TiamDesigns/Dachshund60F/hardware/case/renders/02-right-end.png

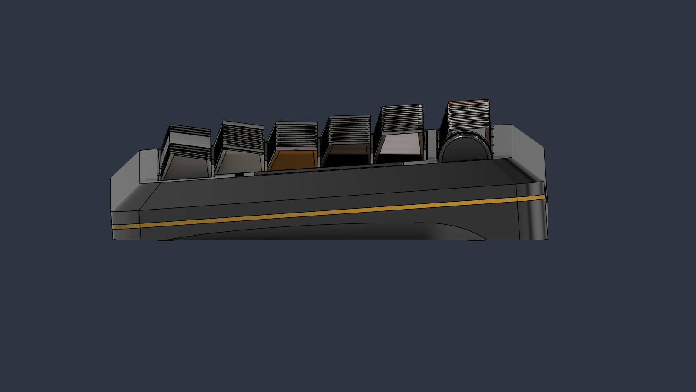
hardware/case/renders/02-right-end.png
