TiamDesigns/Dachshund60F/hardware/case/renders/03-bottom.png

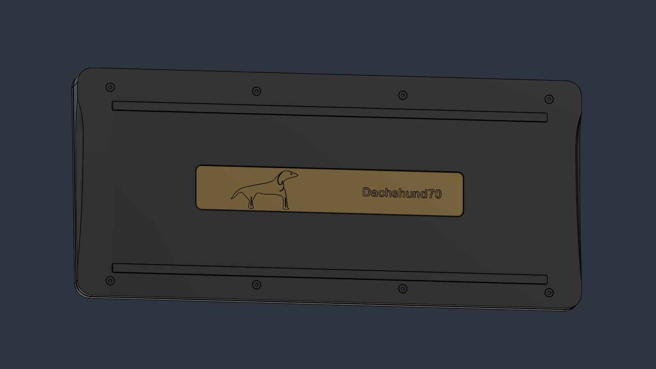
hardware/case/renders/03-bottom.png
