TiamDesigns/Dachshund60F/hardware/case/renders/04-back-face.png

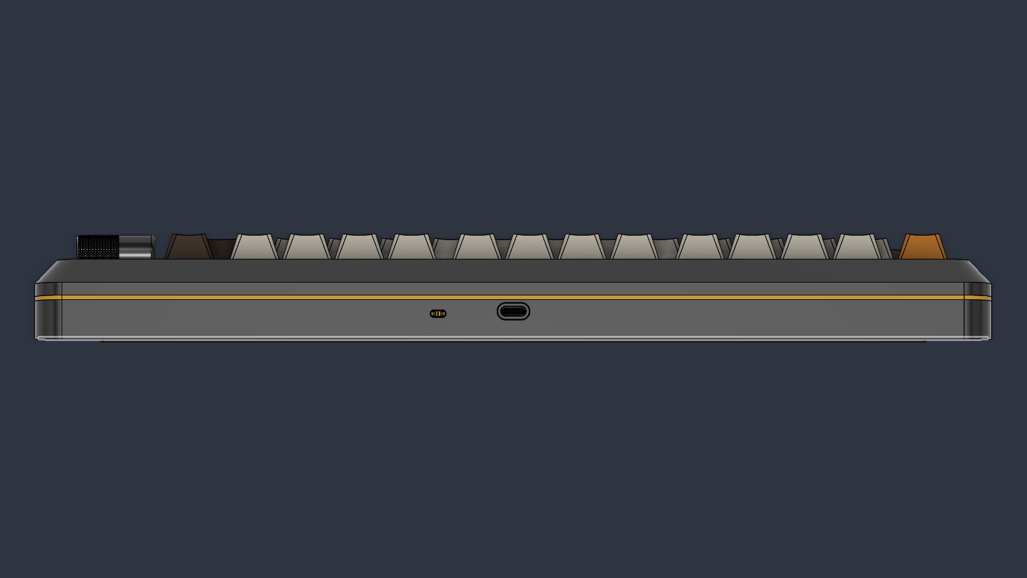
hardware/case/renders/04-back-face.png
