TiamDesigns/Dachshund60F/hardware/case/renders/05-weight-close-up.png

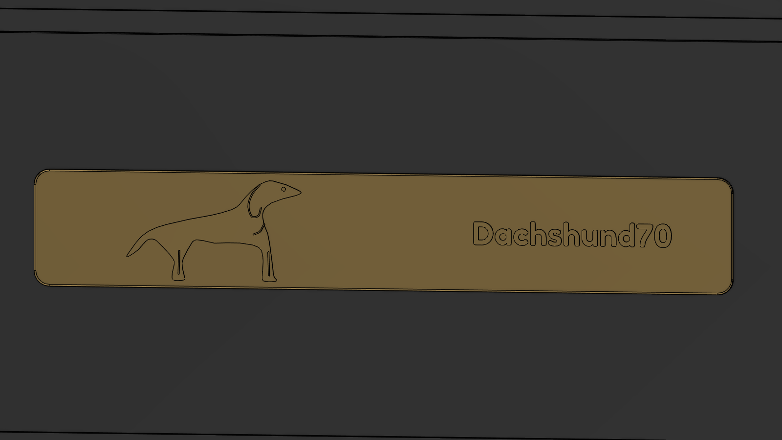
hardware/case/renders/05-weight-close-up.png
