TiamDesigns/Dachshund60F/hardware/3dmodels/Bourns_PEC12R-2x30F-S_standin.step

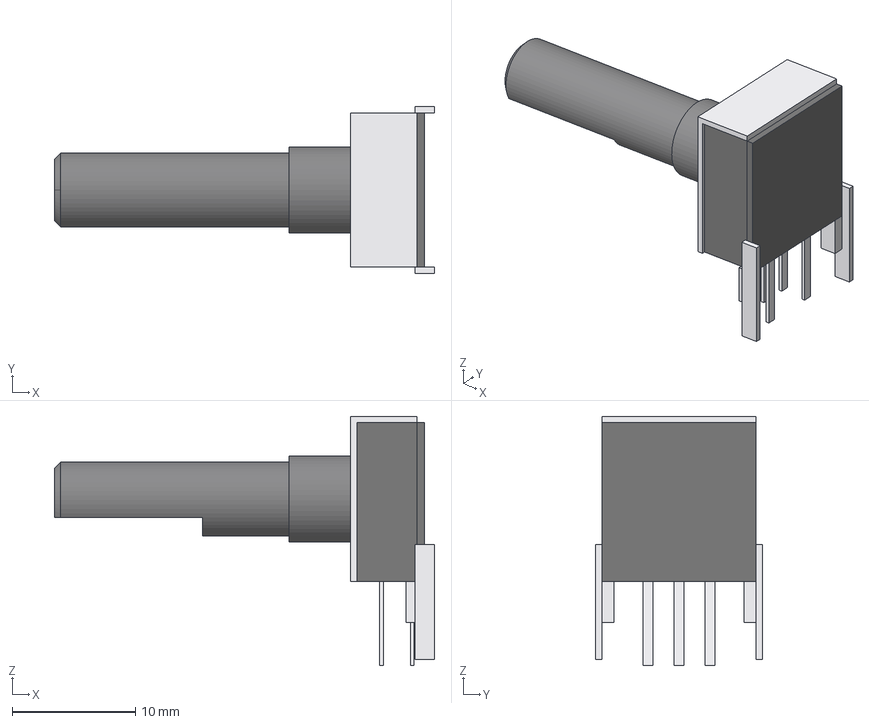
[picture p8: CAD file, 2026-10-28]
hardware/3dmodels/Bourns_PEC12R-2x30F-S_standin.step
30.8 x 13.5 x 20.2 mm
