TiamDesigns/Dachshund60F/hardware/case/dxf/Dachshund70-Weight-Engraving.dxf

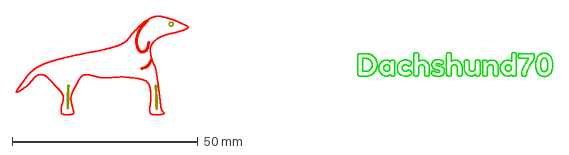
[picture p9: CAD file, 2026-11-04]
hardware/case/dxf/Dachshund70-Weight-Engraving.dxf
144.3 x 26.5 mm
