TiamDesigns/Dachshund60F/hardware/case/step/Dachshund70-Case-Weight.step

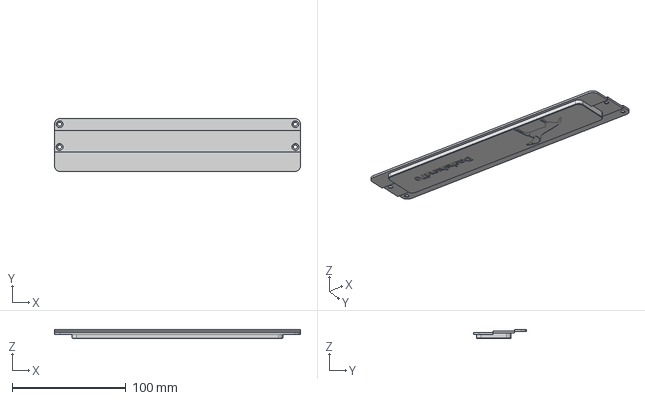
[picture p10: CAD file, 2026-11-04]
hardware/case/step/Dachshund70-Case-Weight.step
216.0 x 46.5 x 7.74 mm
