TiamDesigns/Dachshund60F/hardware/Dachshund70-Plate/Dachshund70-Plate-outline.dxf

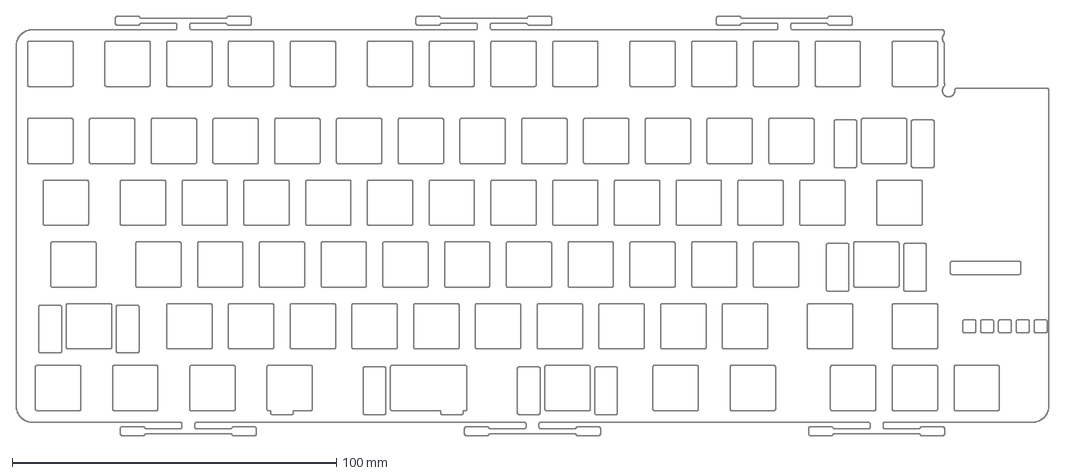
[picture p11: CAD file, 2026-11-03]
hardware/Dachshund70-Plate/Dachshund70-Plate-outline.dxf
318.5 x 129.4 mm
