TiamDesigns/Dachshund60F/hardware/3dmodels/Bourns_PEC12R-2x20F-S_standin.step

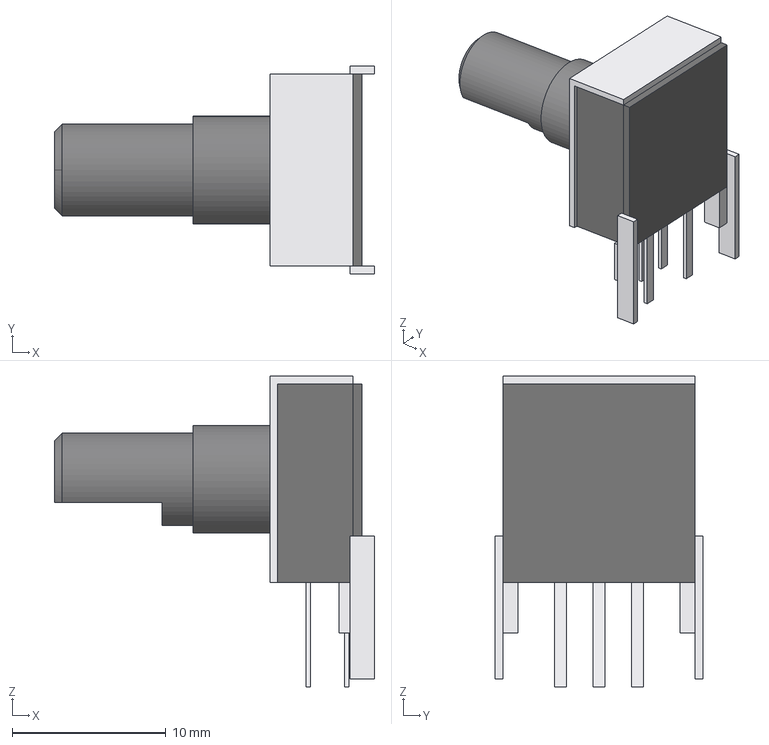
[picture p12: CAD file, 2026-10-28]
hardware/3dmodels/Bourns_PEC12R-2x20F-S_standin.step
20.8 x 13.5 x 20.2 mm
