TiamDesigns/Dachshund60F/hardware/step/Dachshund70-Plate.step

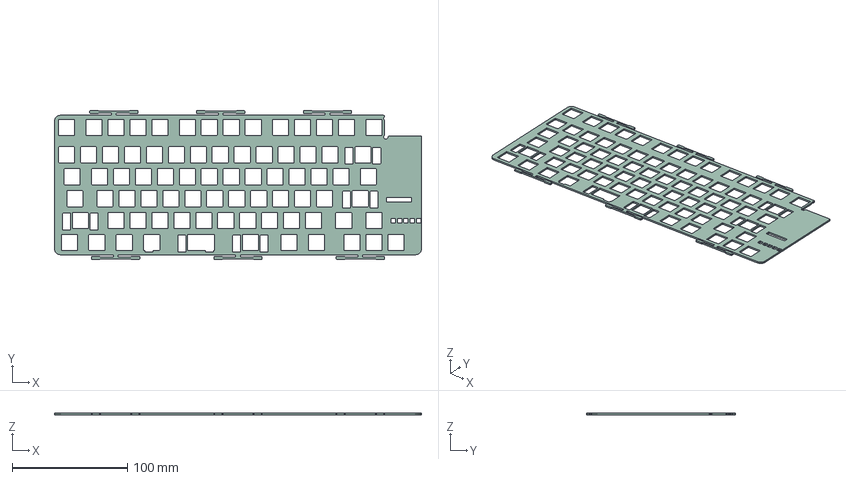
[picture p13: CAD file, 2026-11-03]
hardware/step/Dachshund70-Plate.step
318.5 x 129.4 x 1.51 mm
