TiamDesigns/Dachshund60F/hardware/3dmodels/USB_C_Receptacle_HRO_TYPE-C-31-M-12.step

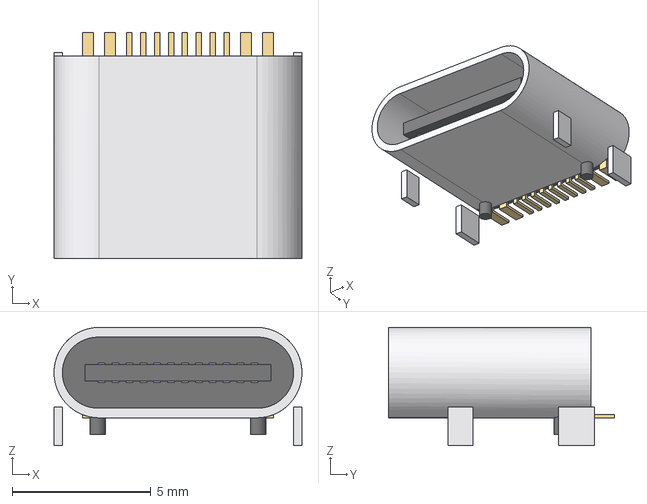
[picture p14: CAD file, 2026-10-23]
hardware/3dmodels/USB_C_Receptacle_HRO_TYPE-C-31-M-12.step
8.94 x 8.15 x 4.26 mm
