TiamDesigns/Dachshund60F/hardware/case/step/Dachshund70-Case-Top.step

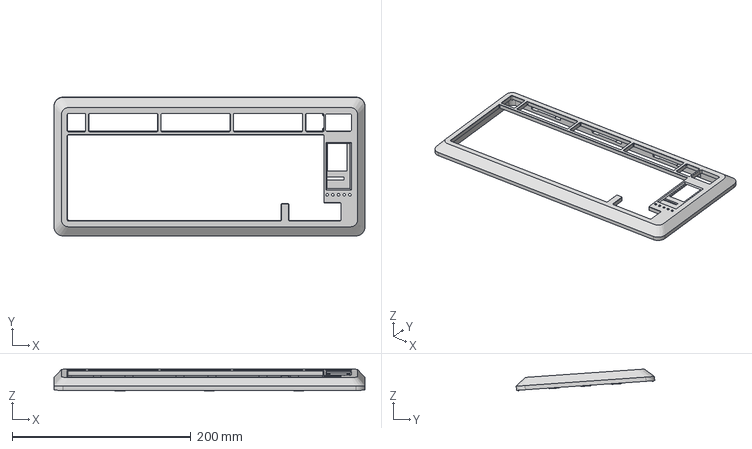
[picture p15: CAD file, 2026-11-03]
hardware/case/step/Dachshund70-Case-Top.step
347.9 x 155.2 x 24.5 mm
