TiamDesigns/Dachshund60F/hardware/3dmodels/JST_PH_S2B-PH-SM4-TB_standin.step

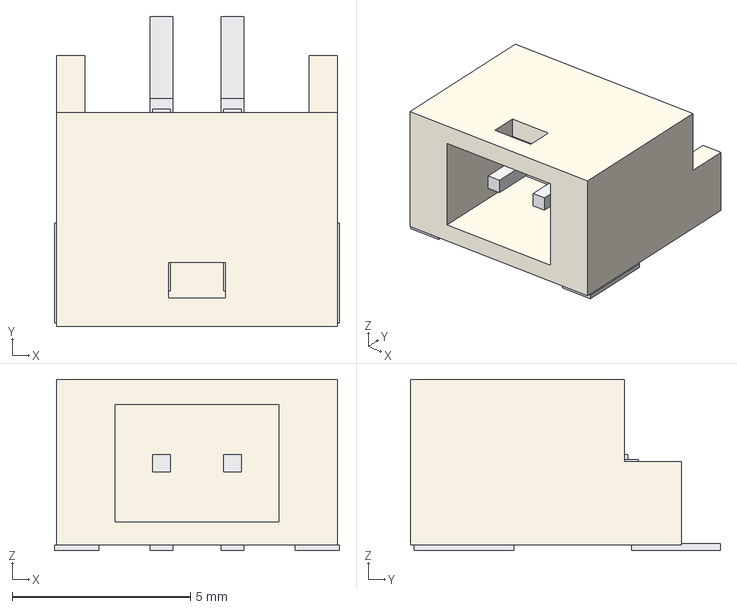
[picture p17: CAD file, 2026-10-23]
hardware/3dmodels/JST_PH_S2B-PH-SM4-TB_standin.step
8.00 x 8.70 x 4.80 mm
