TiamDesigns/Dachshund60F/hardware/case/step/Dachshund70-Case-Encoder-Cover.step

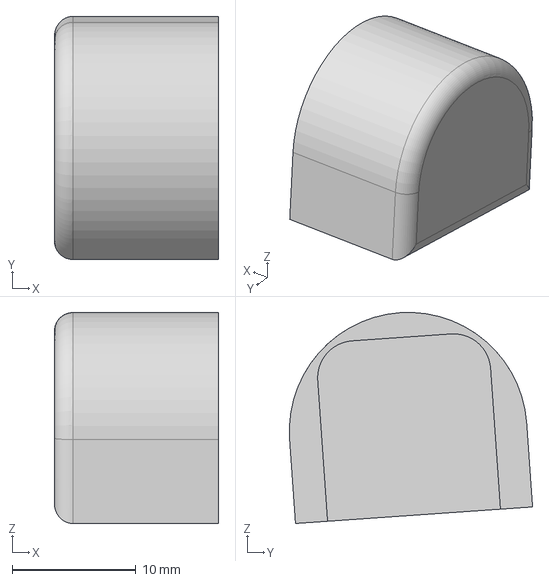
[picture p18: CAD file, 2026-11-03]
hardware/case/step/Dachshund70-Case-Encoder-Cover.step
13.3 x 19.6 x 17.0 mm
