TiamDesigns/Dachshund60F/hardware/case/step/Dachshund70-Case-LED-Guide.step

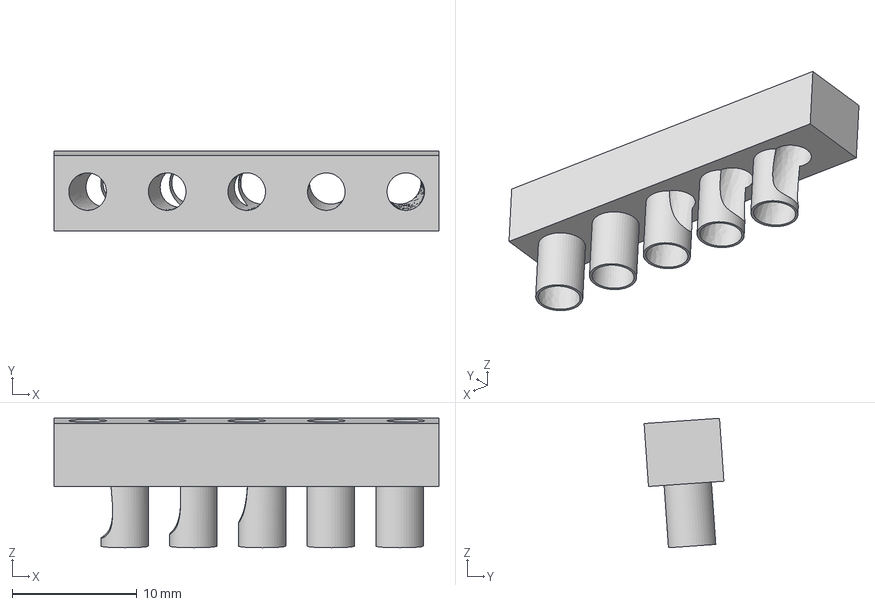
[picture p20: CAD file, 2026-11-03]
hardware/case/step/Dachshund70-Case-LED-Guide.step
30.8 x 6.39 x 10.4 mm
