TiamDesigns/Dachshund60F/hardware/step/Dachshund70-Encoder.step

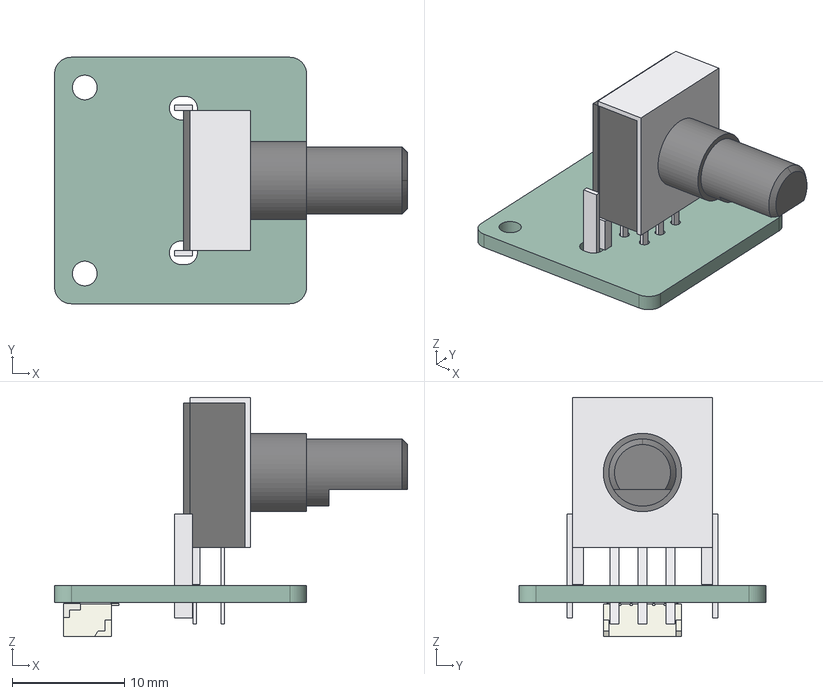
[picture p21: CAD file, 2026-11-03]
hardware/step/Dachshund70-Encoder.step
31.5 x 22.0 x 21.3 mm
Bourns PEC12R-2x20F-S
JST_SH_SM05B-SRSS-TB_1x05-1MP_P1.00mm_Horizontal
Dachshund70-Encoder_PCB
