TiamDesigns/Dachshund60F/hardware/case/step/Dachshund70-Case-Switch-Cap.step

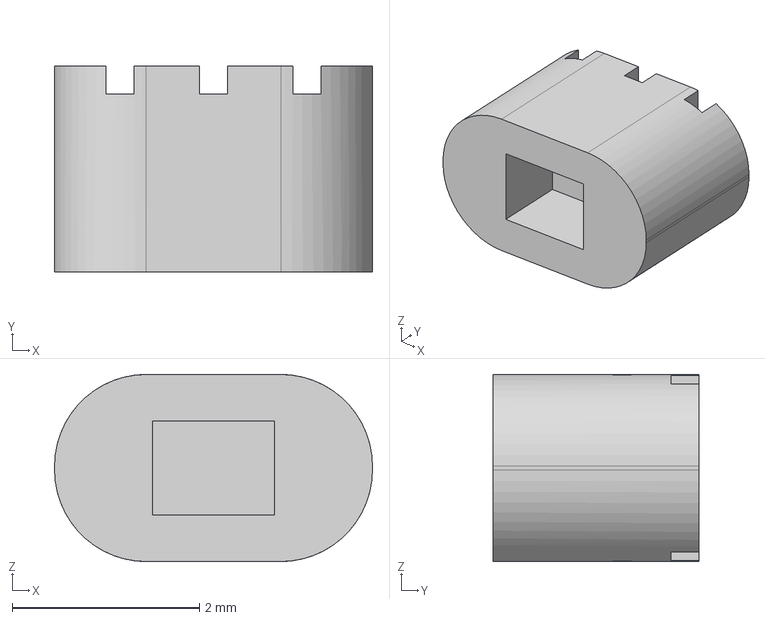
[picture p22: CAD file, 2026-11-03]
hardware/case/step/Dachshund70-Case-Switch-Cap.step
3.40 x 2.20 x 2.00 mm
