TiamDesigns/Dachshund60F/hardware/step/Dachshund70-USB.step

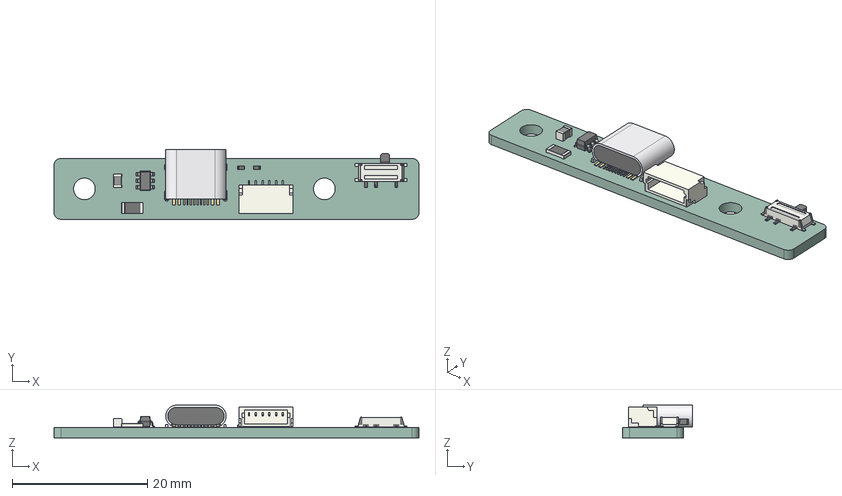
[picture p23: CAD file, 2026-11-03]
hardware/step/Dachshund70-USB.step
54.0 x 10.3 x 4.85 mm
SOT-23-6
HRO TYPE-C-31-M-12
L_0805_2012Metric
R_0402_1005Metric x 2
Fusion_sp
Fuse_1206_3216Metric
JST_SH_SM06B-SRSS-TB_1x06-1MP_P1.00mm_Horizontal
Dachshund70-USB_PCB
