TiamDesigns/Dachshund60F/hardware/case/step/Dachshund70-Case-Knob.step

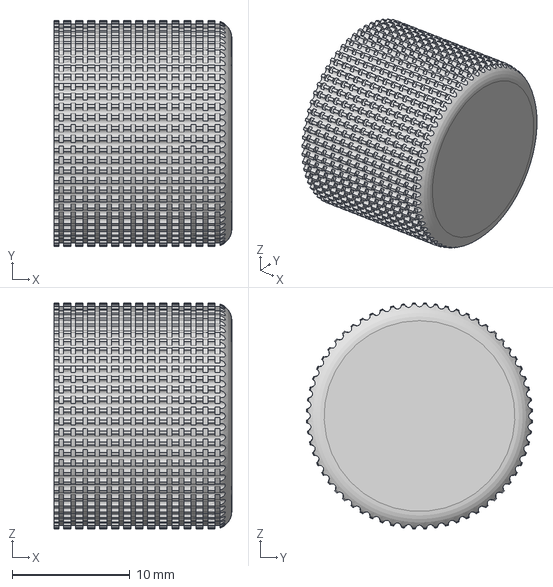
[picture p24: CAD file, 2026-11-03]
hardware/case/step/Dachshund70-Case-Knob.step
15.1 x 19.2 x 19.2 mm
