TiamDesigns/Dachshund60F/hardware/step/Dachshund70-Battery.step

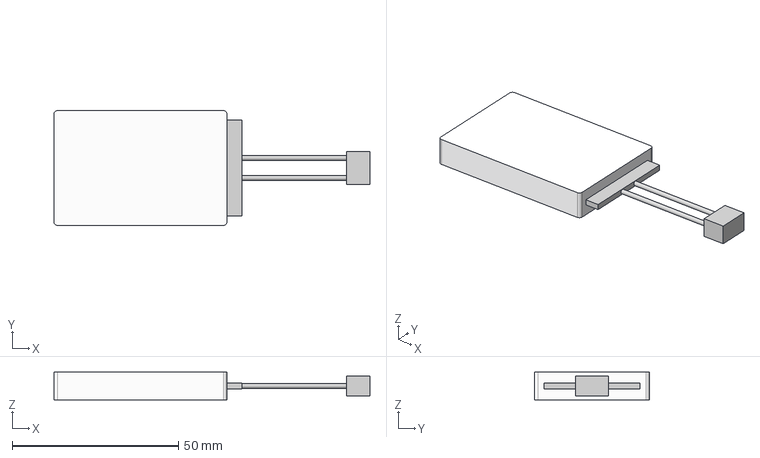
[picture p25: CAD file, 2026-11-03]
hardware/step/Dachshund70-Battery.step
95.0 x 34.5 x 8.30 mm
