TiamDesigns/Dachshund60F/hardware/case/step/Dachshund70-Case-Ring.step

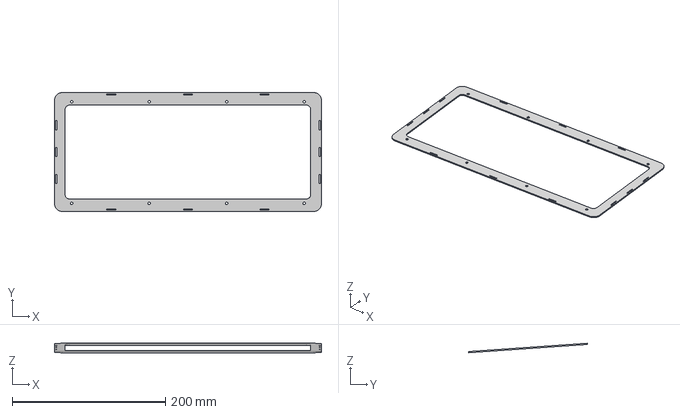
[picture p26: CAD file, 2026-11-03]
hardware/case/step/Dachshund70-Case-Ring.step
347.9 x 154.9 x 12.4 mm
