TiamDesigns/Dachshund60F/hardware/step/Dachshund70-Screen.step

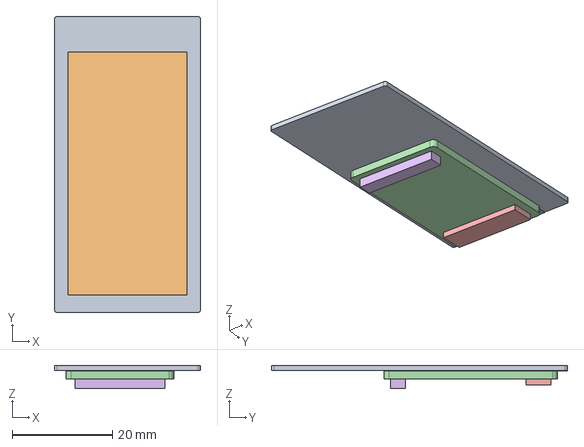
[picture p27: CAD file, 2026-11-03]
hardware/step/Dachshund70-Screen.step
29.2 x 59.2 x 4.60 mm
