TiamDesigns/Dachshund60F/hardware/case/step/Dachshund70-Keycaps.step

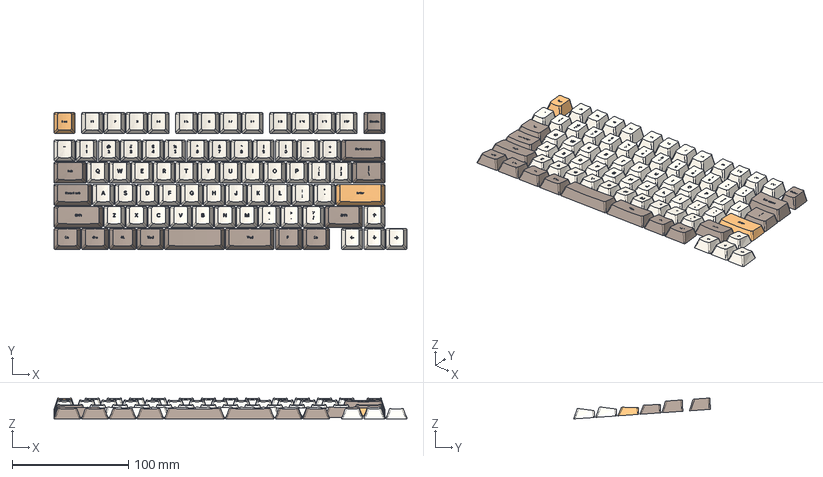
[picture p28: CAD file, 2026-11-03]
hardware/case/step/Dachshund70-Keycaps.step
303.9 x 117.9 x 17.9 mm
cap
legend
cap_1
legend_1
cap_2
legend_2
cap_3
legend_3
cap_4
legend_4
cap_5
legend_5
cap_6
legend_6
cap_7
legend_7
cap_8
legend_8
cap_9
legend_9
cap_10
legend_10
cap_11
legend_11
cap_12
legend_12
cap_13
legend_13
cap_14
legend_14
cap_15
legend_15
cap_16
legend_16
cap_17
legend_17
cap_18
legend_18
cap_19
legend_19
cap_20
legend_20
cap_21
legend_21
cap_22
legend_22
cap_23
legend_23
cap_24
legend_24
cap_25
legend_25
cap_26
legend_26
cap_27
legend_27
cap_28
legend_28
cap_29
legend_29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
