TiamDesigns/Dachshund60F/hardware/case/step/Dachshund70-Case-Bottom.step

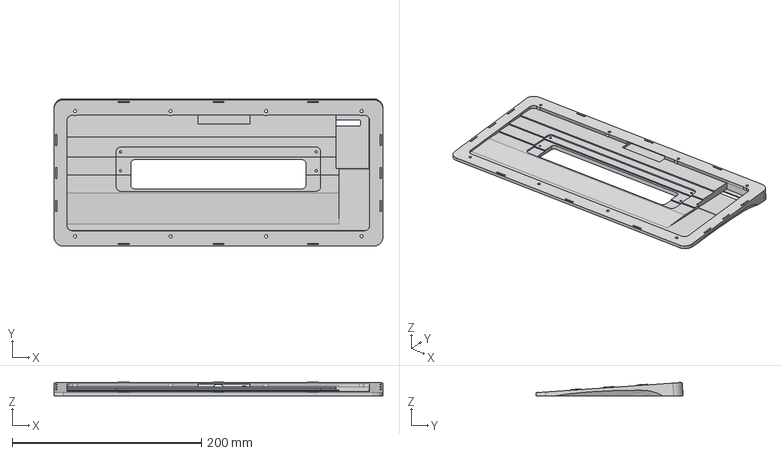
[picture p29: CAD file, 2026-11-03]
hardware/case/step/Dachshund70-Case-Bottom.step
347.9 x 155.8 x 15.1 mm
