TiamDesigns/Dachshund60F/hardware/case/step/Dachshund60F-Weight.step

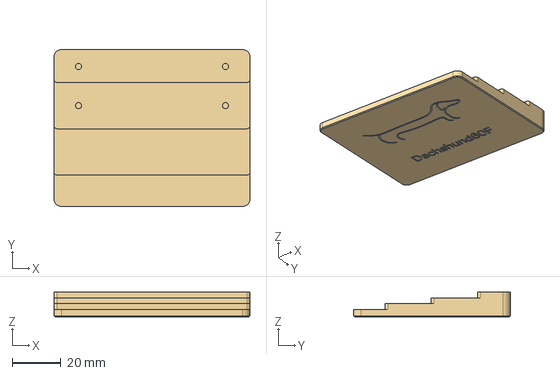
[picture p30: CAD file, 2026-10-29]
hardware/case/step/Dachshund60F-Weight.step
80.0 x 64.0 x 10.0 mm
