TiamDesigns/Dachshund60F/hardware/case/step/Dachshund60F-Case-Panel.step

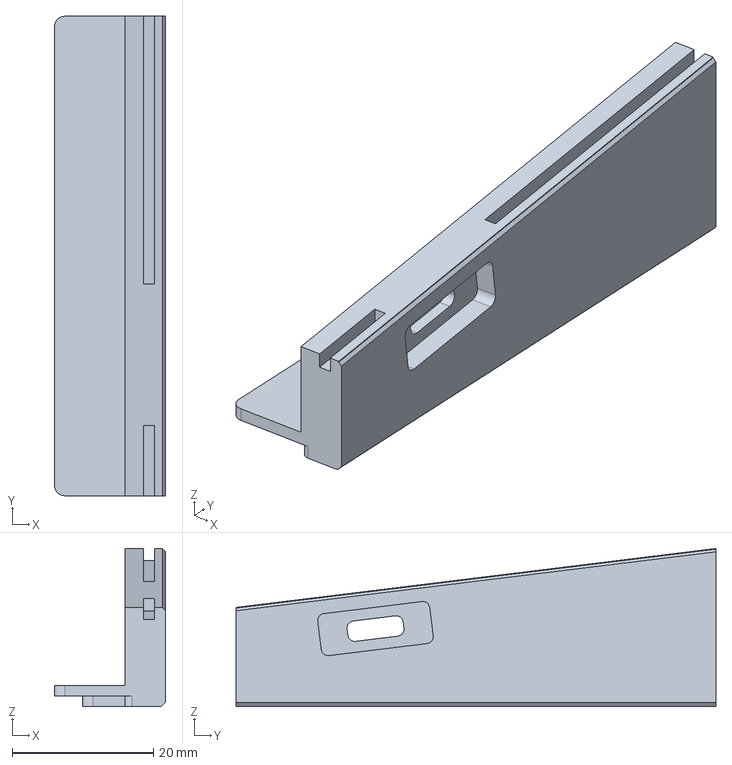
[picture p31: CAD file, 2026-10-29]
hardware/case/step/Dachshund60F-Case-Panel.step
15.8 x 68.0 x 22.4 mm
