TiamDesigns/Dachshund60F/hardware/case/step/Dachshund60F-Case-Bottom.step

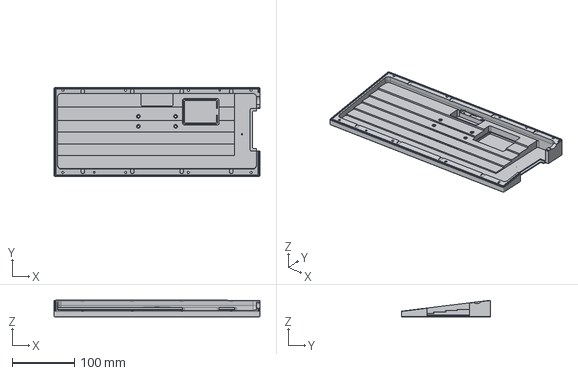
[picture p32: CAD file, 2026-10-29]
hardware/case/step/Dachshund60F-Case-Bottom.step
331.5 x 144.0 x 26.6 mm
