TiamDesigns/Dachshund60F/hardware/case/step/Dachshund60F-Case-Top.step

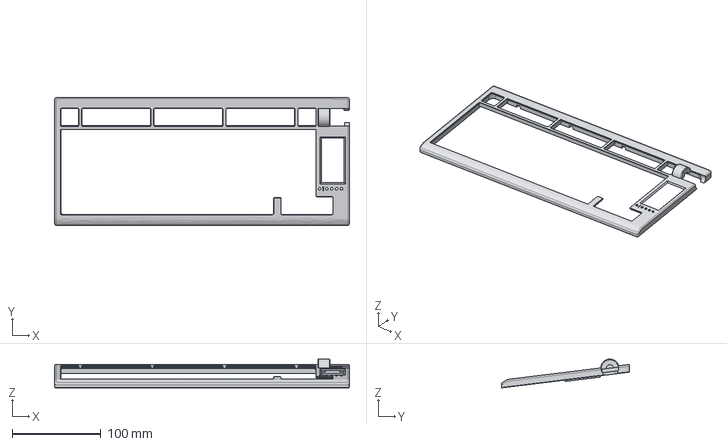
[picture p33: CAD file, 2026-10-29]
hardware/case/step/Dachshund60F-Case-Top.step
331.5 x 144.0 x 32.3 mm
