TiamDesigns/Dachshund60F/hardware/case/step/Dachshund60F-Gaskets.step

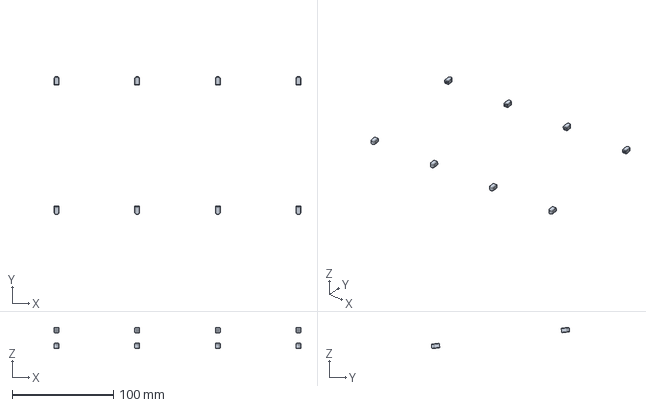
[picture p34: CAD file, 2026-10-29]
hardware/case/step/Dachshund60F-Gaskets.step
243.9 x 136.5 x 21.1 mm
