TiamDesigns/Dachshund60F/hardware/case/step/Dachshund60F-LED-Plugs.step

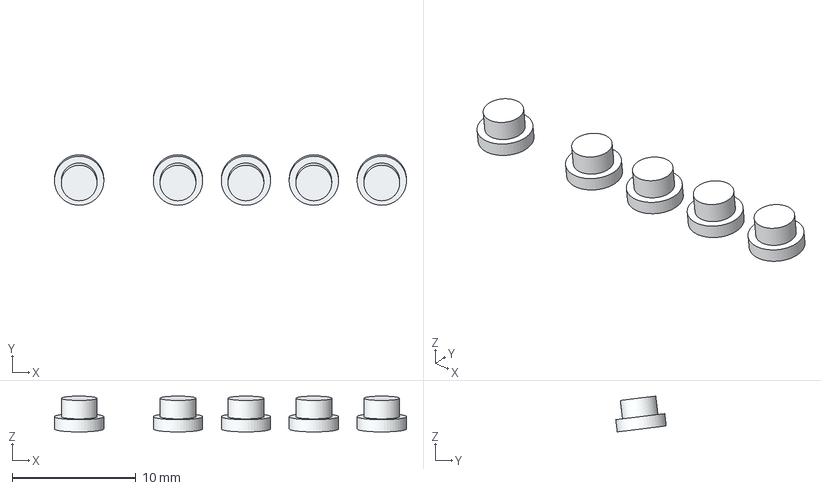
[picture p35: CAD file, 2026-10-29]
hardware/case/step/Dachshund60F-LED-Plugs.step
28.5 x 4.09 x 2.90 mm
