TiamDesigns/Dachshund60F/hardware/case/step/Dachshund60F-LED-Guide.step

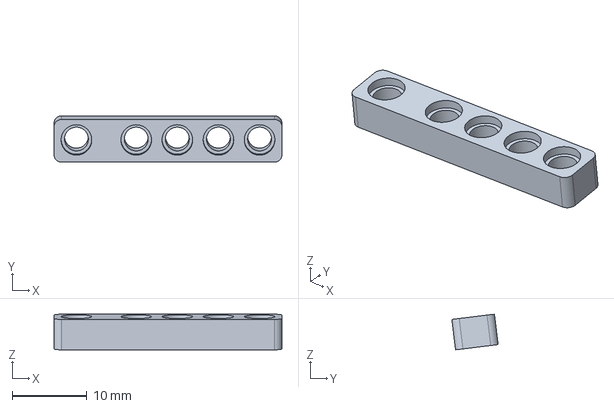
[picture p36: CAD file, 2026-10-29]
hardware/case/step/Dachshund60F-LED-Guide.step
30.5 x 6.21 x 4.77 mm
