TiamDesigns/Dachshund60F/hardware/case/step/Dachshund60F-Switch-Cap.step

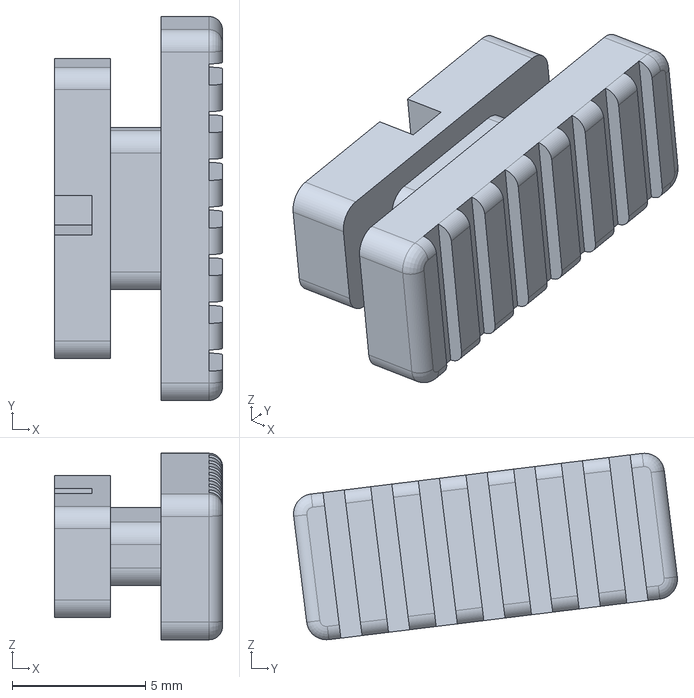
[picture p37: CAD file, 2026-10-29]
hardware/case/step/Dachshund60F-Switch-Cap.step
6.30 x 14.4 x 6.99 mm
