TiamDesigns/Dachshund60F/(list of files, cad)

Other CAD files:
hardware/case/step/Dachshund70-Case-Assembly.step
hardware/step/Dachshund60F-Assembly.step
hardware/case/step/Dachshund60F-Case-Assembly.step
hardware/step/Dachshund60F-Battery.step
hardware/case/step/Dachshund70-Keycaps-6.25u.step
hardware/step/Dachshund60F-Screen.step
hardware/step/Dachshund60F-Plate.step
hardware/step/Dachshund60F.step
hardware/step/Dachshund60F-USB.step
hardware/step/Dachshund60F-Encoder.step
hardware/step/Dachshund60F-Dongle.step
hardware/case/dxf/Dachshund70-Case-Ring.dxf
hardware/case/fusion/Dachshund70-Case-rev2.f3d
