TiamDesigns/Dachshund60F/hardware/Dachshund70/Dachshund70.kicad_pcb

## KiCad design hardware/Dachshund70/Dachshund70.kicad_pcb (2026-11-04)

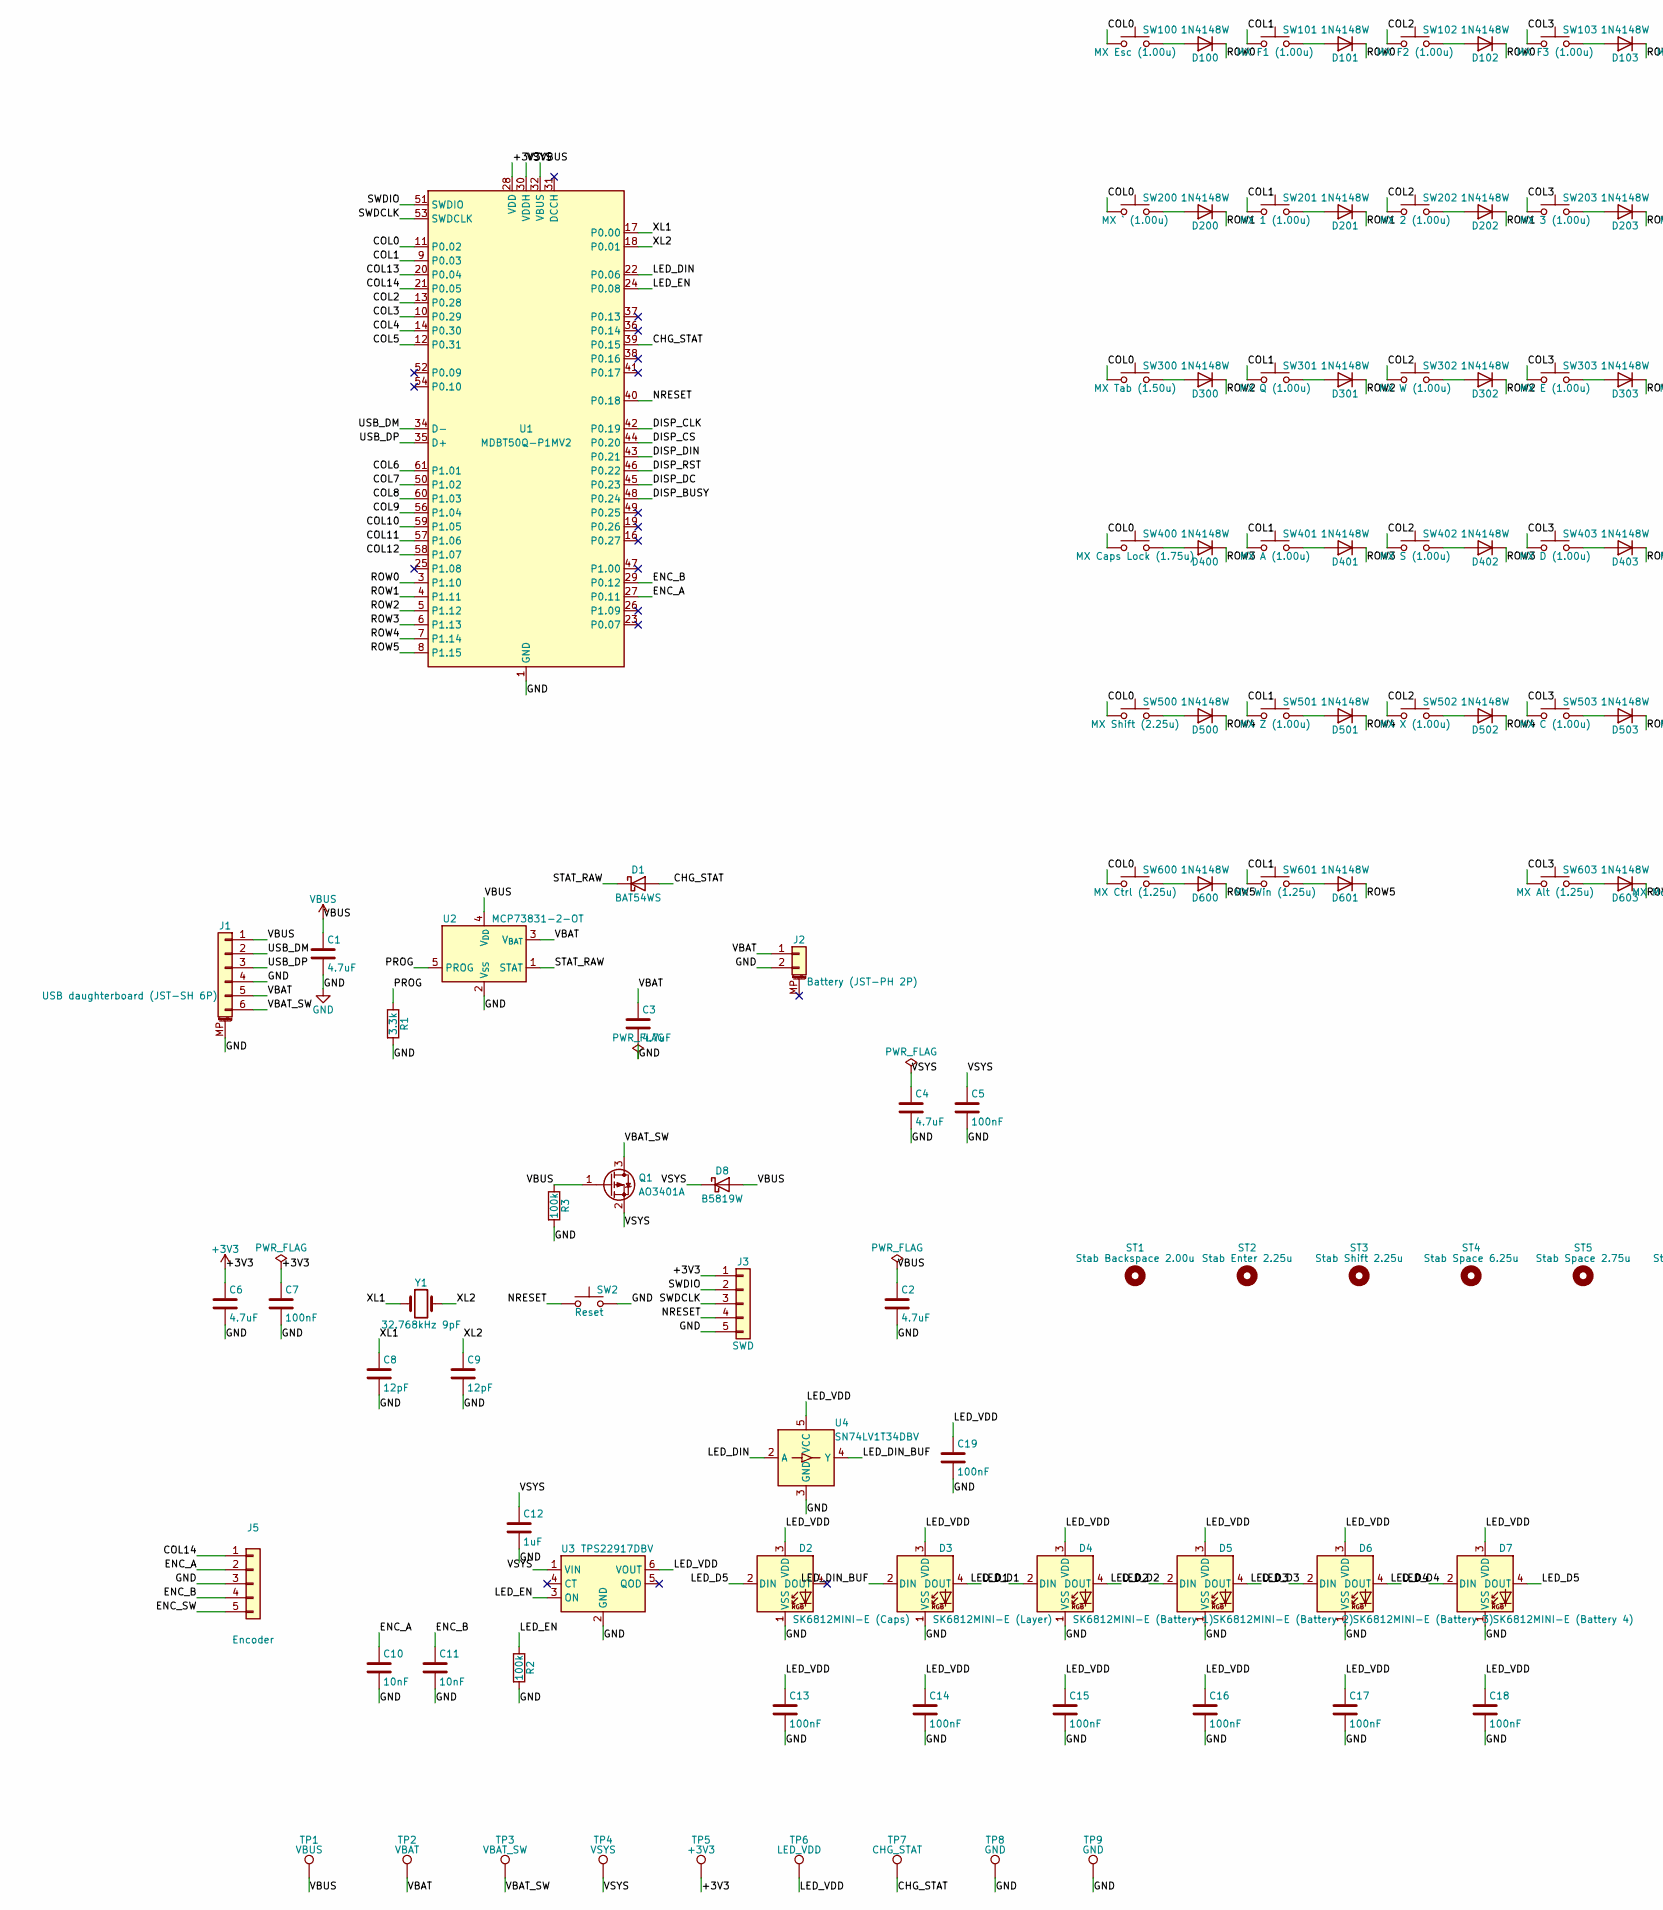
[picture p38: schematic Dachshund70.kicad_sch, part in row 1, column 1]

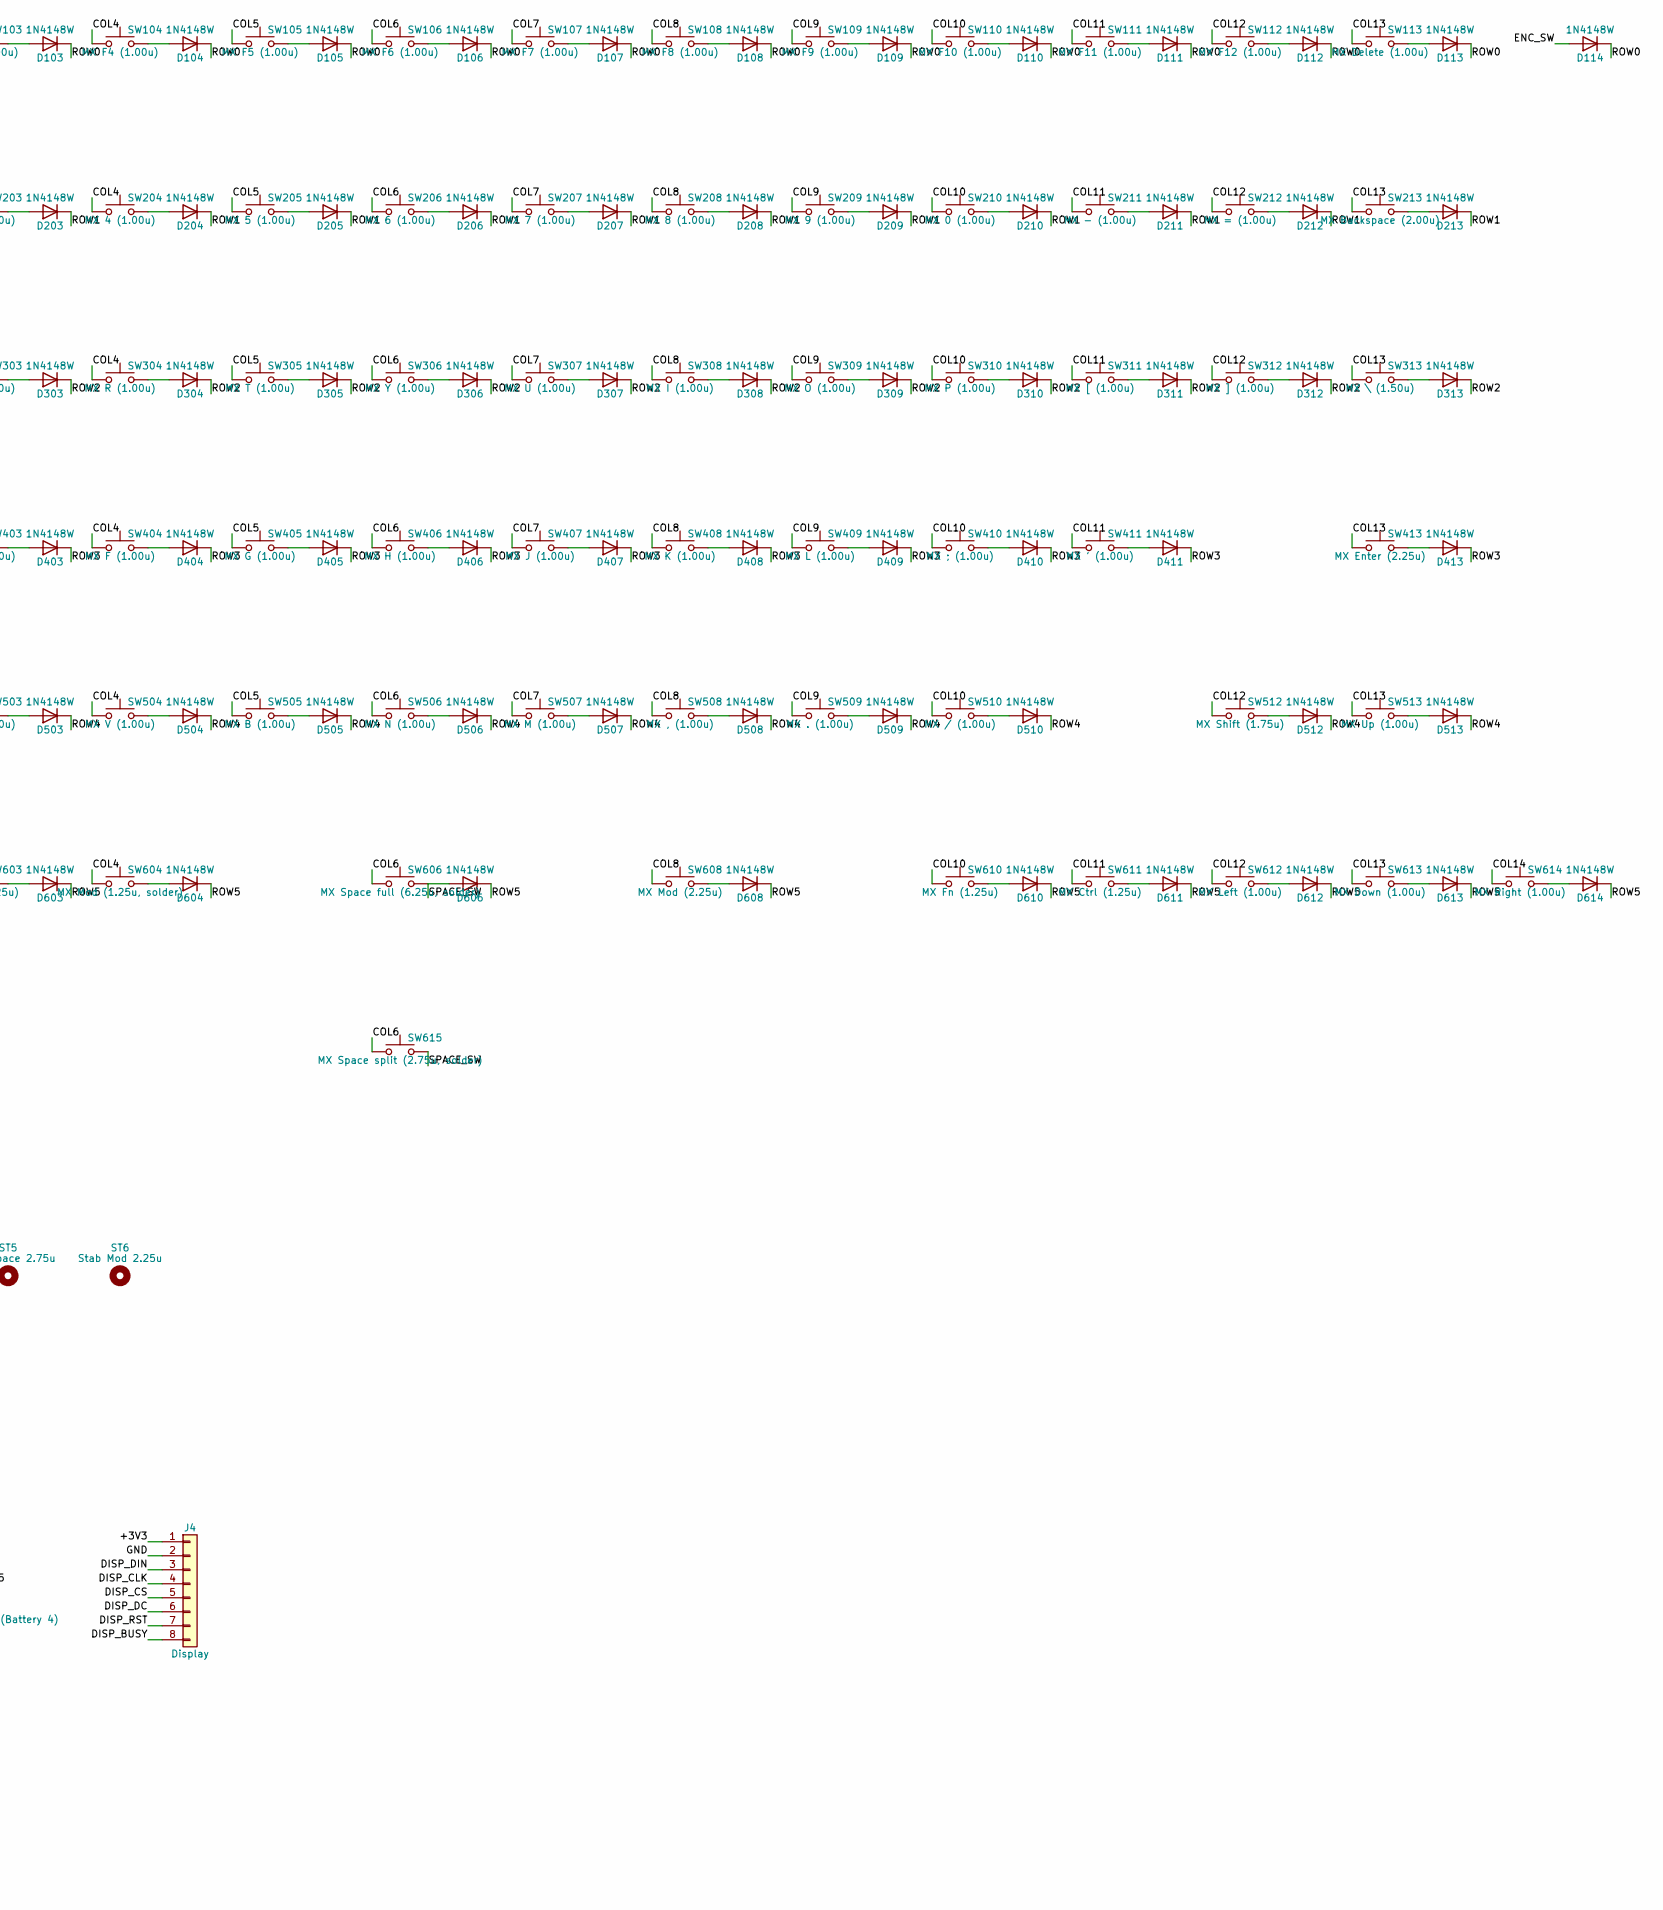
[picture p39: schematic Dachshund70.kicad_sch, part in row 1, column 2]

Parts:
C1, C2, C3, C4, C6: 4.7uF; C_0603_1608Metric; MPN Samsung CL10A475KO8NNNC; LCSC C19666
C5, C7, C13, C14, C15, C16, C17, C18, C19: 100nF; C_0402_1005Metric; MPN Samsung CL05B104KO5NNNC; LCSC C1525
C8, C9: 12pF; C_0402_1005Metric; MPN FH 0402CG120J500NT; LCSC C1547
C10, C11: 10nF; C_0402_1005Metric; MPN Samsung CL05B103KB5NNNC; LCSC C15195
C12: 1uF; C_0402_1005Metric; MPN Samsung CL05A105KA5NQNC; LCSC C52923
D1: BAT54WS; D_SOD-323; MPN CJ BAT54WS; LCSC C2991936
D2: SK6812MINI-E (Caps); LED_SK6812MINI-E_3.2x2.8mm_P1.5mm_ReverseMount_Cutout3.4; MPN OPSCO SK6812MINI-E; LCSC C5149201
D3: SK6812MINI-E (Layer); LED_SK6812MINI-E_3.2x2.8mm_P1.5mm_ReverseMount_Cutout3.4; MPN OPSCO SK6812MINI-E; LCSC C5149201
D4: SK6812MINI-E (Battery 1); LED_SK6812MINI-E_3.2x2.8mm_P1.5mm_ReverseMount_Cutout3.4; MPN OPSCO SK6812MINI-E; LCSC C5149201
D5: SK6812MINI-E (Battery 2); LED_SK6812MINI-E_3.2x2.8mm_P1.5mm_ReverseMount_Cutout3.4; MPN OPSCO SK6812MINI-E; LCSC C5149201
D6: SK6812MINI-E (Battery 3); LED_SK6812MINI-E_3.2x2.8mm_P1.5mm_ReverseMount_Cutout3.4; MPN OPSCO SK6812MINI-E; LCSC C5149201
D7: SK6812MINI-E (Battery 4); LED_SK6812MINI-E_3.2x2.8mm_P1.5mm_ReverseMount_Cutout3.4; MPN OPSCO SK6812MINI-E; LCSC C5149201
D8: B5819W; D_SOD-123; MPN B5819W SL; LCSC C8598
D100, D101, D102, D103, D104, D105, D106, D107, D108, D109, D110, D111, D112, D113, D114, D200, D201, D202, D203, D204, D205, D206, D207, D208, D209, D210, D211, D212, D213, D300, D301, D302, D303, D304, D305, D306, D307, D308, D309, D310, D311, D312, D313, D400, D401, D402, D403, D404, D405, D406, D407, D408, D409, D410, D411, D413, D500, D501, D502, D503, D504, D505, D506, D507, D508, D509, D510, D512, D513, D600, D601, D603, D604, D606, D608, D610, D611, D612, D613, D614: 1N4148W; D_SOD-123; MPN 1N4148W; LCSC C81598
J1: USB daughterboard (JST-SH 6P); JST_SH_SM06B-SRSS-TB_1x06-1MP_P1.00mm_Horizontal; MPN JST SM06B-SRSS-TB(LF)(SN); LCSC C160405
J2: Battery (JST-PH 2P); JST_PH_S2B-PH-SM4-TB_1x02-1MP_P2.00mm_Horizontal; MPN JST S2B-PH-SM4-TB(LF)(SN); LCSC C295747
J3: SWD; PinHeader_1x05_P1.27mm_Vertical; MPN XFCN PZ127V-11-05-H25; LCSC C962329
J4: Display; PinHeader_1x08_P2.54mm_Vertical
J5: Encoder; JST_SH_SM05B-SRSS-TB_1x05-1MP_P1.00mm_Horizontal; MPN JST SM05B-SRSS-TB
Q1: AO3401A; SOT-23; MPN AO3401A; LCSC C15127
R1: 3.3k; R_0603_1608Metric; MPN UNI-ROYAL 0603WAF3301T5E; LCSC C22978
R2: 100k; R_0402_1005Metric; MPN UNI-ROYAL 0402WGF1003TCE; LCSC C25741
R3: 100k; R_0603_1608Metric; MPN UNI-ROYAL 0603WAF1003T5E; LCSC C25803
ST1: Stab Backspace 2.00u; Stabilizer_Cherry_MX_2.00u
ST2: Stab Enter 2.25u; Stabilizer_Cherry_MX_2.00u
ST3: Stab Shift 2.25u; Stabilizer_Cherry_MX_2.00u
ST4: Stab Space 6.25u; Stabilizer_Cherry_MX_6.25u
ST5: Stab Space 2.75u; Stabilizer_Cherry_MX_2.00u
ST6: Stab Mod 2.25u; Stabilizer_Cherry_MX_2.00u
SW2: Reset; SW_SPST_TL3342; MPN E-Switch TL3342F160QG; LCSC C2886898
SW100: MX Esc (1.00u); SW_Hotswap_Kailh_MX_1.00u; MPN HanElectricity CPG151101S11-2 (Kailh-pa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; LCSC C49352235
SW101: MX F1 (1.00u); SW_Hotswap_Kailh_MX_1.00u; MPN HanElectricity CPG151101S11-2 (Kailh-pa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; LCSC C49352235
SW102: MX F2 (1.00u); SW_Hotswap_Kailh_MX_1.00u; MPN HanElectricity CPG151101S11-2 (Kailh-pa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; LCSC C49352235
SW103: MX F3 (1.00u); SW_Hotswap_Kailh_MX_1.00u; MPN HanElectricity CPG151101S11-2 (Kailh-pa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; LCSC C49352235
SW104: MX F4 (1.00u); SW_Hotswap_Kailh_MX_1.00u; MPN HanElectricity CPG151101S11-2 (Kailh-pa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; LCSC C49352235
SW105: MX F5 (1.00u); SW_Hotswap_Kailh_MX_1.00u; MPN HanElectricity CPG151101S11-2 (Kailh-pa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; LCSC C49352235
SW106: MX F6 (1.00u); SW_Hotswap_Kailh_MX_1.00u; MPN HanElectricity CPG151101S11-2 (Kailh-pa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; LCSC C49352235
SW107: MX F7 (1.00u); SW_Hotswap_Kailh_MX_1.00u; MPN HanElectricity CPG151101S11-2 (Kailh-pa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; LCSC C49352235
SW108: MX F8 (1.00u); SW_Hotswap_Kailh_MX_1.00u; MPN HanElectricity CPG151101S11-2 (Kailh-pa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; LCSC C49352235
SW109: MX F9 (1.00u); SW_Hotswap_Kailh_MX_1.00u; MPN HanElectricity CPG151101S11-2 (Kailh-pa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; LCSC C49352235
SW110: MX F10 (1.00u); SW_Hotswap_Kailh_MX_1.00u; MPN HanElectricity CPG151101S11-2 (Kailh-pa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; LCSC C49352235
SW111: MX F11 (1.00u); SW_Hotswap_Kailh_MX_1.00u; MPN HanElectricity CPG151101S11-2 (Kailh-pa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; LCSC C49352235
SW112: MX F12 (1.00u); SW_Hotswap_Kailh_MX_1.00u; MPN HanElectricity CPG151101S11-2 (Kailh-pa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; LCSC C49352235
SW113: MX Delete (1.00u); SW_Hotswap_Kailh_MX_1.00u; MPN HanElectricity CPG151101S11-2 (Kailh-pa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; LCSC C49352235
SW200: MX ` (1.00u); SW_Hotswap_Kailh_MX_1.00u; MPN HanElectricity CPG151101S11-2 (Kailh-pa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; LCSC C49352235
SW201: MX 1 (1.00u); SW_Hotswap_Kailh_MX_1.00u; MPN HanElectricity CPG151101S11-2 (Kailh-pa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; LCSC C49352235
SW202: MX 2 (1.00u); SW_Hotswap_Kailh_MX_1.00u; MPN HanElectricity CPG151101S11-2 (Kailh-pa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; LCSC C49352235
SW203: MX 3 (1.00u); SW_Hotswap_Kailh_MX_1.00u; MPN HanElectricity CPG151101S11-2 (Kailh-pa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; LCSC C49352235
SW204: MX 4 (1.00u); SW_Hotswap_Kailh_MX_1.00u; MPN HanElectricity CPG151101S11-2 (Kailh-pa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; LCSC C49352235
SW205: MX 5 (1.00u); SW_Hotswap_Kailh_MX_1.00u; MPN HanElectricity CPG151101S11-2 (Kailh-pa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; LCSC C49352235
SW206: MX 6 (1.00u); SW_Hotswap_Kailh_MX_1.00u; MPN HanElectricity CPG151101S11-2 (Kailh-pa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; LCSC C49352235
SW207: MX 7 (1.00u); SW_Hotswap_Kailh_MX_1.00u; MPN HanElectricity CPG151101S11-2 (Kailh-pa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; LCSC C49352235
SW208: MX 8 (1.00u); SW_Hotswap_Kailh_MX_1.00u; MPN HanElectricity CPG151101S11-2 (Kailh-pa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; LCSC C49352235
SW209: MX 9 (1.00u); SW_Hotswap_Kailh_MX_1.00u; MPN HanElectricity CPG151101S11-2 (Kailh-pa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; LCSC C49352235
SW210: MX 0 (1.00u); SW_Hotswap_Kailh_MX_1.00u; MPN HanElectricity CPG151101S11-2 (Kailh-pa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; LCSC C49352235
SW211: MX - (1.00u); SW_Hotswap_Kailh_MX_1.00u; MPN HanElectricity CPG151101S11-2 (Kailh-pa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; LCSC C49352235
SW212: MX = (1.00u); SW_Hotswap_Kailh_MX_1.00u; MPN HanElectricity CPG151101S11-2 (Kailh-pa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; LCSC C49352235
SW213: MX Backspace (2.00u); SW_Hotswap_Kailh_MX_2.00u; MPN HanElectricity CPG151101S11-2 (Kailh-pa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; LCSC C49352235
SW300: MX Tab (1.50u); SW_Hotswap_Kailh_MX_1.50u; MPN HanElectricity CPG151101S11-2 (Kailh-pa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; LCSC C49352235
SW301: MX Q (1.00u); SW_Hotswap_Kailh_MX_1.00u; MPN HanElectricity CPG151101S11-2 (Kailh-pa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; LCSC C49352235
SW302: MX W (1.00u); SW_Hotswap_Kailh_MX_1.00u; MPN HanElectricity CPG151101S11-2 (Kailh-pa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; LCSC C49352235
SW303: MX E (1.00u); SW_Hotswap_Kailh_MX_1.00u; MPN HanElectricity CPG151101S11-2 (Kailh-pa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; LCSC C49352235
SW304: MX R (1.00u); SW_Hotswap_Kailh_MX_1.00u; MPN HanElectricity CPG151101S11-2 (Kailh-pa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; LCSC C49352235
SW305: MX T (1.00u); SW_Hotswap_Kailh_MX_1.00u; MPN HanElectricity CPG151101S11-2 (Kailh-pa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; LCSC C49352235
SW306: MX Y (1.00u); SW_Hotswap_Kailh_MX_1.00u; MPN HanElectricity CPG151101S11-2 (Kailh-pa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; LCSC C49352235
SW307: MX U (1.00u); SW_Hotswap_Kailh_MX_1.00u; MPN HanElectricity CPG151101S11-2 (Kailh-pa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; LCSC C49352235
SW308: MX I (1.00u); SW_Hotswap_Kailh_MX_1.00u; MPN HanElectricity CPG151101S11-2 (Kailh-pa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; LCSC C49352235
SW309: MX O (1.00u); SW_Hotswap_Kailh_MX_1.00u; MPN HanElectricity CPG151101S11-2 (Kailh-pa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; LCSC C49352235
SW310: MX P (1.00u); SW_Hotswap_Kailh_MX_1.00u; MPN HanElectricity CPG151101S11-2 (Kailh-pa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; LCSC C49352235
SW311: MX [ (1.00u); SW_Hotswap_Kailh_MX_1.00u; MPN HanElectricity CPG151101S11-2 (Kailh-pa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; LCSC C49352235
SW312: MX ] (1.00u); SW_Hotswap_Kailh_MX_1.00u; MPN HanElectricity CPG151101S11-2 (Kailh-pa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; LCSC C49352235
SW313: MX \ (1.50u); SW_Hotswap_Kailh_MX_1.50u; MPN HanElectricity CPG151101S11-2 (Kailh-pa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; LCSC C49352235
SW400: MX Caps Lock (1.75u); SW_Hotswap_Kailh_MX_1.75u; MPN HanElectricity CPG151101S11-2 (Kailh-pa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; LCSC C49352235
SW401: MX A (1.00u); SW_Hotswap_Kailh_MX_1.00u; MPN HanElectricity CPG151101S11-2 (Kailh-pa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; LCSC C49352235
SW402: MX S (1.00u); SW_Hotswap_Kailh_MX_1.00u; MPN HanElectricity CPG151101S11-2 (Kailh-pa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; LCSC C49352235
SW403: MX D (1.00u); SW_Hotswap_Kailh_MX_1.00u; MPN HanElectricity CPG151101S11-2 (Kailh-pa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; LCSC C49352235
SW404: MX F (1.00u); SW_Hotswap_Kailh_MX_1.00u; MPN HanElectricity CPG151101S11-2 (Kailh-pa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; LCSC C49352235
SW405: MX G (1.00u); SW_Hotswap_Kailh_MX_1.00u; MPN HanElectricity CPG151101S11-2 (Kailh-pa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; LCSC C49352235
SW406: MX H (1.00u); SW_Hotswap_Kailh_MX_1.00u; MPN HanElectricity CPG151101S11-2 (Kailh-pa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; LCSC C49352235
SW407: MX J (1.00u); SW_Hotswap_Kailh_MX_1.00u; MPN HanElectricity CPG151101S11-2 (Kailh-pa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; LCSC C49352235
SW408: MX K (1.00u); SW_Hotswap_Kailh_MX_1.00u; MPN HanElectricity CPG151101S11-2 (Kailh-pa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; LCSC C49352235
SW409: MX L (1.00u); SW_Hotswap_Kailh_MX_1.00u; MPN HanElectricity CPG151101S11-2 (Kailh-pa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; LCSC C49352235
SW410: MX ; (1.00u); SW_Hotswap_Kailh_MX_1.00u; MPN HanElectricity CPG151101S11-2 (Kailh-pa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; LCSC C49352235
SW411: MX ' (1.00u); SW_Hotswap_Kailh_MX_1.00u; MPN HanElectricity CPG151101S11-2 (Kailh-pa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; LCSC C49352235
SW413: MX Enter (2.25u); SW_Hotswap_Kailh_MX_2.25u; MPN HanElectricity CPG151101S11-2 (Kailh-pa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; LCSC C49352235
SW500: MX Shift (2.25u); SW_Hotswap_Kailh_MX_2.25u; MPN HanElectricity CPG151101S11-2 (Kailh-pa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; LCSC C49352235
SW501: MX Z (1.00u); SW_Hotswap_Kailh_MX_1.00u; MPN HanElectricity CPG151101S11-2 (Kailh-pa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; LCSC C49352235
SW502: MX X (1.00u); SW_Hotswap_Kailh_MX_1.00u; MPN HanElectricity CPG151101S11-2 (Kailh-pa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; LCSC C49352235
SW503: MX C (1.00u); SW_Hotswap_Kailh_MX_1.00u; MPN HanElectricity CPG151101S11-2 (Kailh-pa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; LCSC C49352235
SW504: MX V (1.00u); SW_Hotswap_Kailh_MX_1.00u; MPN HanElectricity CPG151101S11-2 (Kailh-pa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; LCSC C49352235
SW505: MX B (1.00u); SW_Hotswap_Kailh_MX_1.00u; MPN HanElectricity CPG151101S11-2 (Kailh-pa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; LCSC C49352235
SW506: MX N (1.00u); SW_Hotswap_Kailh_MX_1.00u; MPN HanElectricity CPG151101S11-2 (Kailh-pa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; LCSC C49352235
SW507: MX M (1.00u); SW_Hotswap_Kailh_MX_1.00u; MPN HanElectricity CPG151101S11-2 (Kailh-pa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; LCSC C49352235
SW508: MX , (1.00u); SW_Hotswap_Kailh_MX_1.00u; MPN HanElectricity CPG151101S11-2 (Kailh-pa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; LCSC C49352235
SW509: MX . (1.00u); SW_Hotswap_Kailh_MX_1.00u; MPN HanElectricity CPG151101S11-2 (Kailh-pa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; LCSC C49352235
SW510: MX / (1.00u); SW_Hotswap_Kailh_MX_1.00u; MPN HanElectricity CPG151101S11-2 (Kailh-pa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; LCSC C49352235
SW512: MX Shift (1.75u); SW_Hotswap_Kailh_MX_1.75u; MPN HanElectricity CPG151101S11-2 (Kailh-pa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; LCSC C49352235
SW513: MX Up (1.00u); SW_Hotswap_Kailh_MX_1.00u; MPN HanElectricity CPG151101S11-2 (Kailh-pa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; LCSC C49352235
SW600, SW611: MX Ctrl (1.25u); SW_Hotswap_Kailh_MX_1.25u; MPN HanElectricity CPG151101S11-2 (Kailh-pa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; LCSC C49352235
SW601: MX Win (1.25u); SW_Hotswap_Kailh_MX_1.25u; MPN HanElectricity CPG151101S11-2 (Kailh-pa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; LCSC C49352235
SW603: MX Alt (1.25u); SW_Hotswap_Kailh_MX_1.25u; MPN HanElectricity CPG151101S11-2 (Kailh-pa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; LCSC C49352235
SW604: MX Mod (1.25u, solder); SW_Cherry_MX_1.25u_Plate
SW606: MX Space full (6.25u, solder); SW_Cherry_MX_6.25u_Plate
SW608: MX Mod (2.25u); SW_Hotswap_Kailh_MX_2.25u; MPN HanElectricity CPG151101S11-2 (Kailh-pa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; LCSC C49352235
SW610: MX Fn (1.25u); SW_Hotswap_Kailh_MX_1.25u; MPN HanElectricity CPG151101S11-2 (Kailh-pa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; LCSC C49352235
SW612: MX Left (1.00u); SW_Hotswap_Kailh_MX_1.00u; MPN HanElectricity CPG151101S11-2 (Kailh-pa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; LCSC C49352235
SW613: MX Down (1.00u); SW_Hotswap_Kailh_MX_1.00u; MPN HanElectricity CPG151101S11-2 (Kailh-pa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; LCSC C49352235
SW614: MX Right (1.00u); SW_Hotswap_Kailh_MX_1.00u; MPN HanElectricity CPG151101S11-2 (Kailh-pa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; LCSC C49352235
SW615: MX Space split (2.75u, solder); SW_Cherry_MX_2.75u_Plate
TP1: VBUS; TestPoint_Pad_D1.5mm
TP2: VBAT; TestPoint_Pad_D1.5mm
TP3: VBAT_SW; TestPoint_Pad_D1.5mm
TP4: VSYS; TestPoint_Pad_D1.5mm
TP5: +3V3; TestPoint_Pad_D1.5mm
TP6: LED_VDD; TestPoint_Pad_D1.5mm
TP7: CHG_STAT; TestPoint_Pad_D1.5mm
TP8, TP9: GND; TestPoint_Pad_D1.5mm
U1: MDBT50Q-P1MV2; Raytac_MDBT50Q; MPN Raytac MDBT50Q-P1MV2; LCSC C5119772
U2: MCP73831-2-OT; SOT-23-5; MPN Microchip MCP73831T-2ACI/OT; LCSC C424093
U3: TPS22917DBV; SOT-23-6; MPN TI TPS22917DBVR; LCSC C2681320
U4: SN74LV1T34DBV; SOT-23-5; MPN TI SN74LV1T34DBVR; LCSC C100024
Y1: 32.768kHz 9pF; Crystal_SMD_3215-2Pin_3.2x1.5mm; MPN Epson X1A0000910005 (32.768 kHz, 9 pF); LCSC C255869

Connections:
+3V3: C6.1, C7.1, J3.1, J4.1, TP5.1, U1.28 (VDD)
/CHG_STAT: D1.2 (A), TP7.1, U1.39 (P0.15)
/COL0: SW100.1, SW200.1, SW300.1, SW400.1, SW500.1, SW600.1, U1.11 (P0.02)
/COL1: SW101.1, SW201.1, SW301.1, SW401.1, SW501.1, SW601.1, U1.9 (P0.03)
/COL2: SW102.1, SW202.1, SW302.1, SW402.1, SW502.1, U1.13 (P0.28)
/COL3: SW103.1, SW203.1, SW303.1, SW403.1, SW503.1, SW603.1, U1.10 (P0.29)
/COL4: SW104.1, SW204.1, SW304.1, SW404.1, SW504.1, SW604.1, U1.14 (P0.30)
/COL5: SW105.1, SW205.1, SW305.1, SW405.1, SW505.1, U1.12 (P0.31)
/COL6: SW106.1, SW206.1, SW306.1, SW406.1, SW506.1, SW606.1, SW615.1, U1.61 (P1.01)
/COL7: SW107.1, SW207.1, SW307.1, SW407.1, SW507.1, U1.50 (P1.02)
/COL8: SW108.1, SW208.1, SW308.1, SW408.1, SW508.1, SW608.1, U1.60 (P1.03)
/COL9: SW109.1, SW209.1, SW309.1, SW409.1, SW509.1, U1.56 (P1.04)
/COL10: SW110.1, SW210.1, SW310.1, SW410.1, SW510.1, SW610.1, U1.59 (P1.05)
/COL11: SW111.1, SW211.1, SW311.1, SW411.1, SW611.1, U1.57 (P1.06)
/COL12: SW112.1, SW212.1, SW312.1, SW512.1, SW612.1, U1.58 (P1.07)
/COL13: SW113.1, SW213.1, SW313.1, SW413.1, SW513.1, SW613.1, U1.20 (P0.04)
/COL14: J5.1, SW614.1, U1.21 (P0.05)
/DISP_BUSY: J4.8, U1.48 (P0.24)
/DISP_CLK: J4.4, U1.42 (P0.19)
/DISP_CS: J4.5, U1.44 (P0.20)
/DISP_DC: J4.6, U1.45 (P0.23)
/DISP_DIN: J4.3, U1.43 (P0.21)
/DISP_RST: J4.7, U1.46 (P0.22)
/ENC_A: C10.1, J5.2, U1.27 (P0.11)
/ENC_B: C11.1, J5.4, U1.29 (P0.12)
/ENC_SW: D114.2 (A), J5.5
/LED_D1: D3.4 (DOUT), D4.2 (DIN)
/LED_D2: D4.4 (DOUT), D5.2 (DIN)
/LED_D3: D5.4 (DOUT), D6.2 (DIN)
/LED_D4: D6.4 (DOUT), D7.2 (DIN)
/LED_D5: D2.2 (DIN), D7.4 (DOUT)
/LED_DIN: U1.22 (P0.06), U4.2 (A)
/LED_DIN_BUF: D3.2 (DIN), U4.4 (Y)
/LED_EN: R2.1, U1.24 (P0.08), U3.3 (ON)
/LED_VDD: C13.1, C14.1, C15.1, C16.1, C17.1, C18.1, C19.1, D2.3 (VDD), D3.3 (VDD), D4.3 (VDD), D5.3 (VDD), D6.3 (VDD), D7.3 (VDD), TP6.1, U3.6 (VOUT), U4.5 (VCC)
/NRESET: J3.4, SW2.1, U1.40 (P0.18)
/PROG: R1.1, U2.5 (PROG)
/ROW0: D100.1 (K), D101.1 (K), D102.1 (K), D103.1 (K), D104.1 (K), D105.1 (K), D106.1 (K), D107.1 (K), D108.1 (K), D109.1 (K), D110.1 (K), D111.1 (K), D112.1 (K), D113.1 (K), D114.1 (K), U1.3 (P1.10)
/ROW1: D200.1 (K), D201.1 (K), D202.1 (K), D203.1 (K), D204.1 (K), D205.1 (K), D206.1 (K), D207.1 (K), D208.1 (K), D209.1 (K), D210.1 (K), D211.1 (K), D212.1 (K), D213.1 (K), U1.4 (P1.11)
/ROW2: D300.1 (K), D301.1 (K), D302.1 (K), D303.1 (K), D304.1 (K), D305.1 (K), D306.1 (K), D307.1 (K), D308.1 (K), D309.1 (K), D310.1 (K), D311.1 (K), D312.1 (K), D313.1 (K), U1.5 (P1.12)
/ROW3: D400.1 (K), D401.1 (K), D402.1 (K), D403.1 (K), D404.1 (K), D405.1 (K), D406.1 (K), D407.1 (K), D408.1 (K), D409.1 (K), D410.1 (K), D411.1 (K), D413.1 (K), U1.6 (P1.13)
/ROW4: D500.1 (K), D501.1 (K), D502.1 (K), D503.1 (K), D504.1 (K), D505.1 (K), D506.1 (K), D507.1 (K), D508.1 (K), D509.1 (K), D510.1 (K), D512.1 (K), D513.1 (K), U1.7 (P1.14)
/ROW5: D600.1 (K), D601.1 (K), D603.1 (K), D604.1 (K), D606.1 (K), D608.1 (K), D610.1 (K), D611.1 (K), D612.1 (K), D613.1 (K), D614.1 (K), U1.8 (P1.15)
/SPACE_SW: D606.2 (A), SW606.2, SW615.2
/STAT_RAW: D1.1 (K), U2.1 (STAT)
/SWDCLK: J3.3, U1.53 (SWDCLK)
/SWDIO: J3.2, U1.51 (SWDIO)
/USB_DM: J1.2, U1.34 (D-)
/USB_DP: J1.3, U1.35 (D+)
/VBAT: C3.1, J1.5, J2.1, TP2.1, U2.3 (V_{BAT})
/VBAT_SW: J1.6, Q1.3 (D), TP3.1
/VSYS: C4.1, C5.1, C12.1, D8.1 (K), Q1.2 (S), TP4.1, U1.30 (VDDH), U3.1 (VIN)
/XL1: C8.1, U1.17 (P0.00), Y1.1
/XL2: C9.1, U1.18 (P0.01), Y1.2
GND: C1.2, C2.2, C3.2, C4.2, C5.2, C6.2, C7.2, C8.2, C9.2, C10.2, C11.2, C12.2, C13.2, C14.2, C15.2, C16.2, C17.2, C18.2, C19.2, D2.1 (VSS), D3.1 (VSS), D4.1 (VSS), D5.1 (VSS), D6.1 (VSS), D7.1 (VSS), J1.4, J1.MP (MountPin), J2.2, J3.5, J4.2, J5.3, J5.MP, R1.2, R2.2, R3.2, SW2.2, TP8.1, TP9.1, U1.1 (GND), U1.2 (GND), U1.15 (GND), U1.33 (GND), U1.55 (GND), U2.2 (V_{SS}), U3.2 (GND), U4.3 (GND)
unnamed: D100.2 (A), SW100.2
unnamed: D101.2 (A), SW101.2
unnamed: D102.2 (A), SW102.2
unnamed: D103.2 (A), SW103.2
unnamed: D104.2 (A), SW104.2
unnamed: D105.2 (A), SW105.2
unnamed: D106.2 (A), SW106.2
unnamed: D107.2 (A), SW107.2
unnamed: D108.2 (A), SW108.2
unnamed: D109.2 (A), SW109.2
unnamed: D110.2 (A), SW110.2
unnamed: D111.2 (A), SW111.2
unnamed: D112.2 (A), SW112.2
unnamed: D113.2 (A), SW113.2
unnamed: D200.2 (A), SW200.2
unnamed: D201.2 (A), SW201.2
unnamed: D202.2 (A), SW202.2
unnamed: D203.2 (A), SW203.2
unnamed: D204.2 (A), SW204.2
unnamed: D205.2 (A), SW205.2
unnamed: D206.2 (A), SW206.2
unnamed: D207.2 (A), SW207.2
unnamed: D208.2 (A), SW208.2
unnamed: D209.2 (A), SW209.2
unnamed: D210.2 (A), SW210.2
unnamed: D211.2 (A), SW211.2
unnamed: D212.2 (A), SW212.2
unnamed: D213.2 (A), SW213.2
unnamed: D300.2 (A), SW300.2
unnamed: D301.2 (A), SW301.2
unnamed: D302.2 (A), SW302.2
unnamed: D303.2 (A), SW303.2
unnamed: D304.2 (A), SW304.2
unnamed: D305.2 (A), SW305.2
unnamed: D306.2 (A), SW306.2
unnamed: D307.2 (A), SW307.2
unnamed: D308.2 (A), SW308.2
unnamed: D309.2 (A), SW309.2
unnamed: D310.2 (A), SW310.2
unnamed: D311.2 (A), SW311.2
unnamed: D312.2 (A), SW312.2
unnamed: D313.2 (A), SW313.2
unnamed: D400.2 (A), SW400.2
unnamed: D401.2 (A), SW401.2
unnamed: D402.2 (A), SW402.2
unnamed: D403.2 (A), SW403.2
unnamed: D404.2 (A), SW404.2
unnamed: D405.2 (A), SW405.2
unnamed: D406.2 (A), SW406.2
unnamed: D407.2 (A), SW407.2
unnamed: D408.2 (A), SW408.2
unnamed: D409.2 (A), SW409.2
unnamed: D410.2 (A), SW410.2
unnamed: D411.2 (A), SW411.2
unnamed: D413.2 (A), SW413.2
unnamed: D500.2 (A), SW500.2
unnamed: D501.2 (A), SW501.2
unnamed: D502.2 (A), SW502.2
unnamed: D503.2 (A), SW503.2
unnamed: D504.2 (A), SW504.2
unnamed: D505.2 (A), SW505.2
unnamed: D506.2 (A), SW506.2
unnamed: D507.2 (A), SW507.2
unnamed: D508.2 (A), SW508.2
unnamed: D509.2 (A), SW509.2
unnamed: D510.2 (A), SW510.2
unnamed: D512.2 (A), SW512.2
unnamed: D513.2 (A), SW513.2
unnamed: D600.2 (A), SW600.2
unnamed: D601.2 (A), SW601.2
unnamed: D603.2 (A), SW603.2
unnamed: D604.2 (A), SW604.2
unnamed: D608.2 (A), SW608.2
unnamed: D610.2 (A), SW610.2
unnamed: D611.2 (A), SW611.2
unnamed: D612.2 (A), SW612.2
unnamed: D613.2 (A), SW613.2
unnamed: D614.2 (A), SW614.2
VBUS: C1.1, C2.1, D8.2 (A), J1.1, Q1.1 (G), R3.1, TP1.1, U1.32 (VBUS), U2.4 (V_{DD})

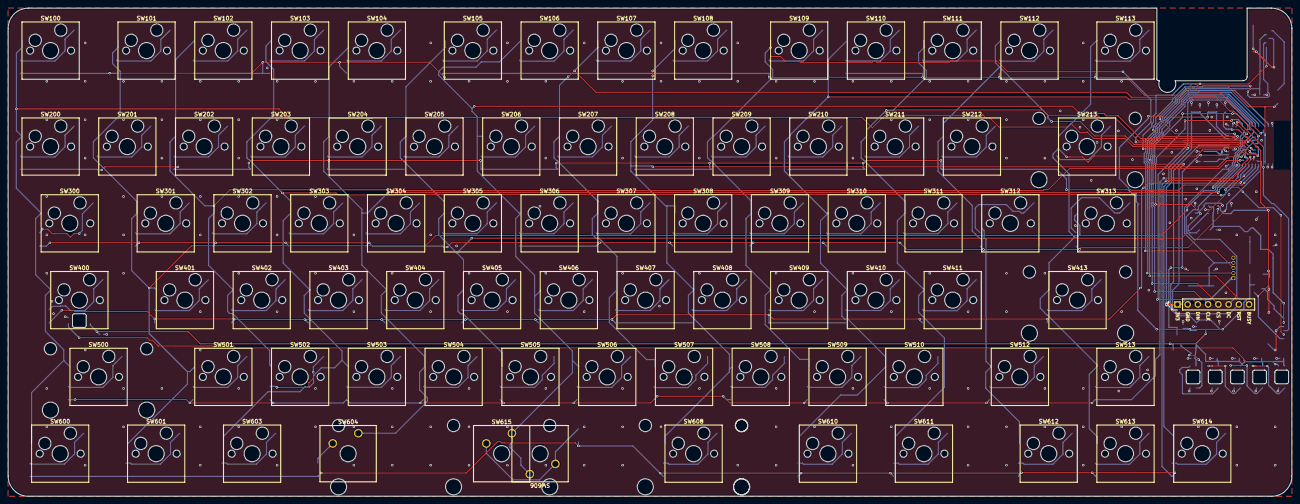
[picture p40: board Dachshund70.kicad_pcb from above]

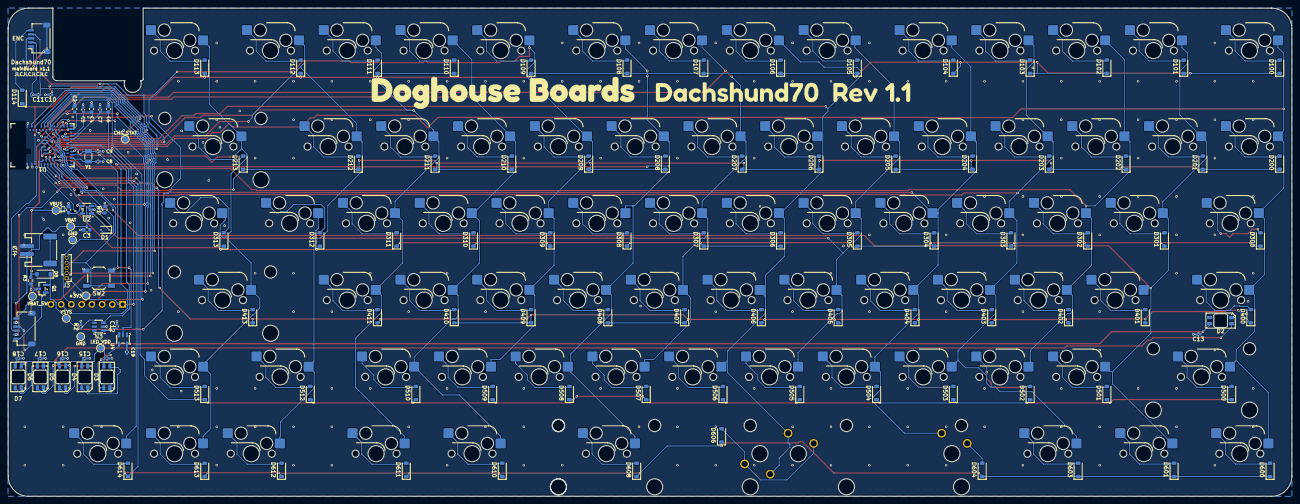
[picture p41: board Dachshund70.kicad_pcb from below]

Board: 2 copper layers, 318.5 x 121.1 mm, 217 parts (130 on the bottom side), 134 nets.
