TiamDesigns/Dachshund60F/hardware/Dachshund70-USB/Dachshund70-USB.kicad_pcb

## KiCad design hardware/Dachshund70-USB/Dachshund70-USB.kicad_pcb (2026-11-03)

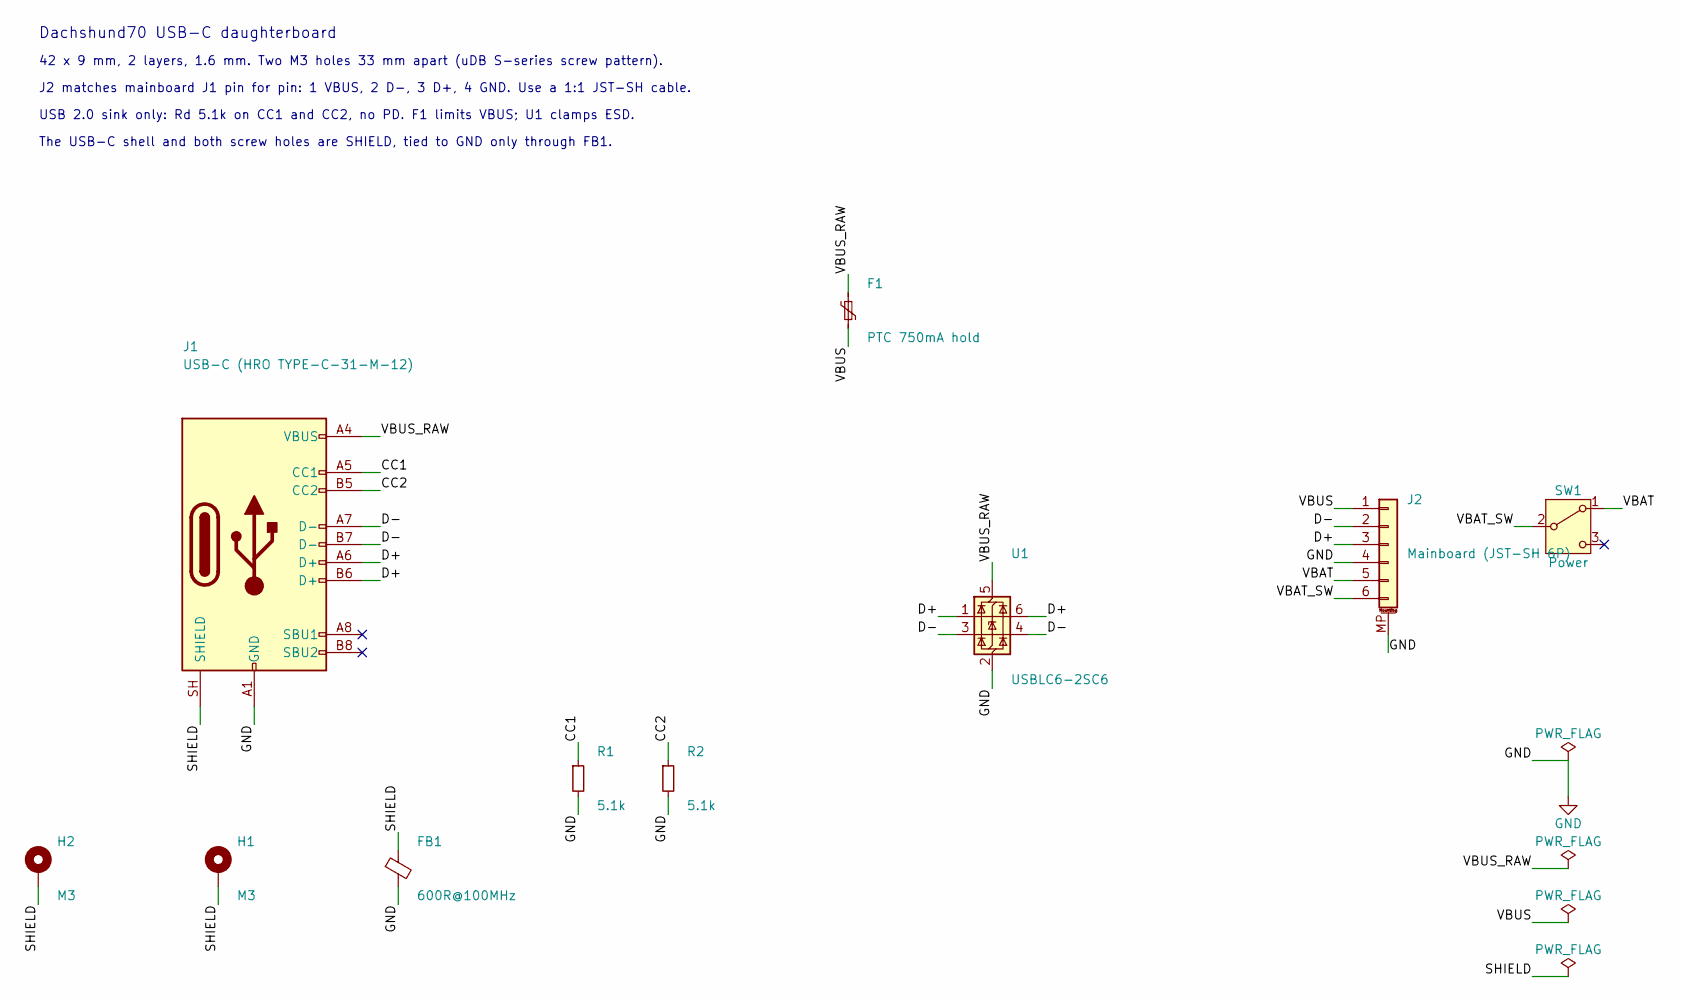
[picture p42: schematic Dachshund70-USB.kicad_sch, Dachshund70 USB-C daughterboard]

Parts:
F1: PTC 750mA hold; Fuse_1206_3216Metric; MPN BHFUSE BSMD1206-075-6V; LCSC C883127
FB1: 600R@100MHz; L_0805_2012Metric; MPN Sunlord GZ2012D601TF; LCSC C1017
H1, H2: M3; MountingHole_3.2mm_M3_ISO7380_Pad_TopBottom
J1: USB-C (HRO TYPE-C-31-M-12); USB_C_Receptacle_HRO_TYPE-C-31-M-12; MPN HRO TYPE-C-31-M-12; LCSC C165948
J2: Mainboard (JST-SH 6P); JST_SH_SM06B-SRSS-TB_1x06-1MP_P1.00mm_Horizontal; MPN JST SM06B-SRSS-TB(LF)(SN); LCSC C160405
R1, R2: 5.1k; R_0402_1005Metric; MPN UNI-ROYAL 0402WGF5101TCE; LCSC C25905
SW1: Power; SW_SPDT_PCM12; MPN C&K PCM12SMTR; LCSC C221841
U1: USBLC6-2SC6; SOT-23-6; MPN ST USBLC6-2SC6; LCSC C7519

Connections:
/CC1: J1.A5 (CC1), R1.1
/CC2: J1.B5 (CC2), R2.1
/D+: J1.A6 (D+), J1.B6 (D+), J2.3, U1.1 (I/O1), U1.6 (I/O1)
/D-: J1.A7 (D-), J1.B7 (D-), J2.2, U1.3 (I/O2), U1.4 (I/O2)
/SHIELD: FB1.1, H1.1, H2.1, J1.SH (SHIELD)
/VBAT: J2.5, SW1.1 (A)
/VBAT_SW: J2.6, SW1.2 (B)
/VBUS: F1.2, J2.1
/VBUS_RAW: F1.1, J1.A4 (VBUS), J1.A9 (VBUS), J1.B4 (VBUS), J1.B9 (VBUS), U1.5 (VBUS)
GND: FB1.2, J1.A1 (GND), J1.A12 (GND), J1.B1 (GND), J1.B12 (GND), J2.4, J2.MP (MountPin), R1.2, R2.2, U1.2 (GND)

Notes on the sheet:
Dachshund70 USB-C daughterboard
42 x 9 mm, 2 layers, 1.6 mm. Two M3 holes 33 mm apart (uDB S-series screw pattern).
J2 matches mainboard J1 pin for pin: 1 VBUS, 2 D-, 3 D+, 4 GND. Use a 1:1 JST-SH cable.
USB 2.0 sink only: Rd 5.1k on CC1 and CC2, no PD. F1 limits VBUS; U1 clamps ESD.
The USB-C shell and both screw holes are SHIELD, tied to GND only through FB1.

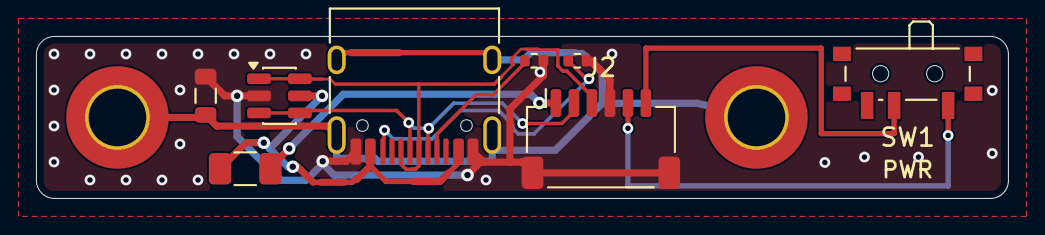
[picture p43: board Dachshund70-USB.kicad_pcb from above]

Board: 2 copper layers, 54.0 x 9.0 mm, 10 parts (0 on the bottom side), 10 nets.
