TiamDesigns/Dachshund60F/hardware/Dachshund70-Dongle/Dachshund70-Dongle.kicad_pcb

## KiCad design hardware/Dachshund70-Dongle/Dachshund70-Dongle.kicad_pcb (2026-11-03)

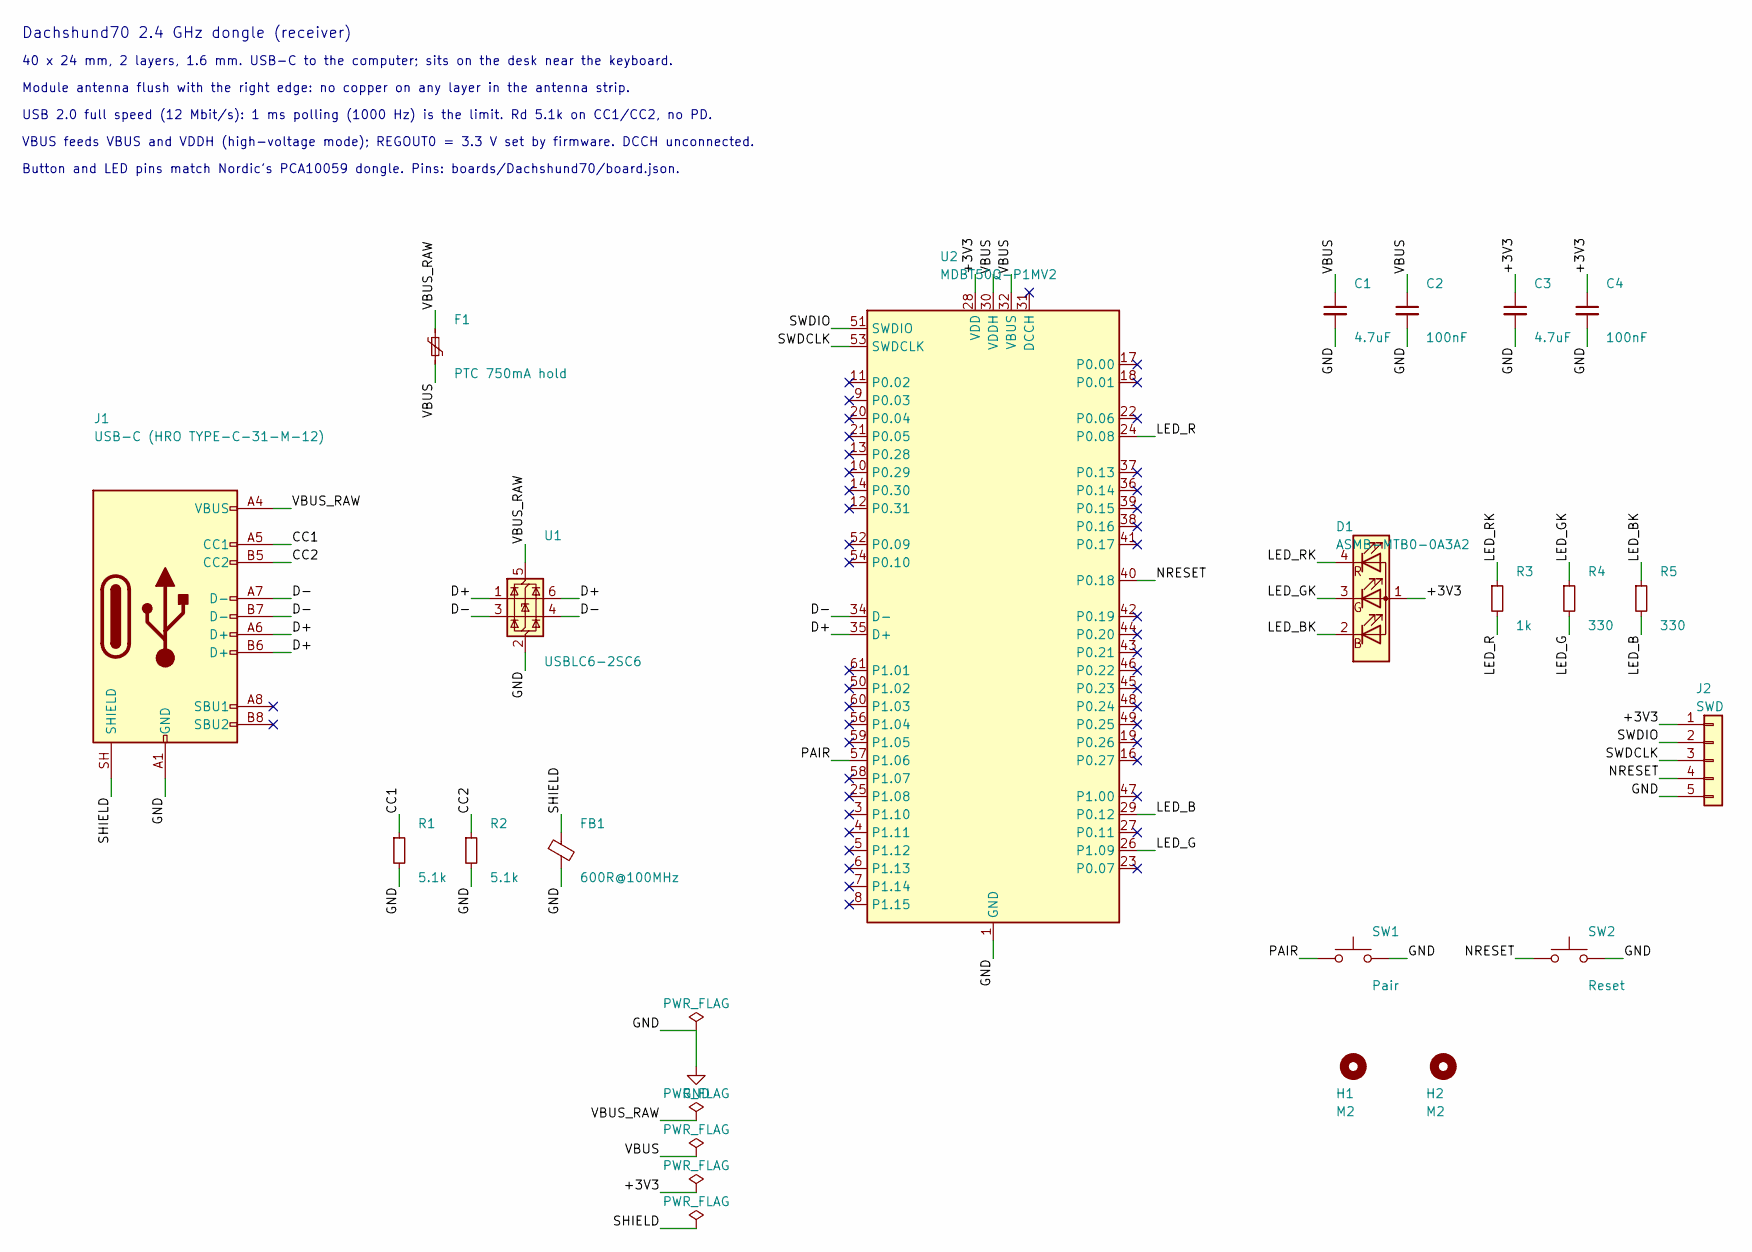
[picture p44: schematic Dachshund70-Dongle.kicad_sch, Dachshund70 2.4 GHz dongle]

Parts:
C1, C3: 4.7uF; C_0603_1608Metric; MPN Samsung CL10A475KO8NNNC; LCSC C19666
C2, C4: 100nF; C_0402_1005Metric; MPN Samsung CL05B104KO5NNNC; LCSC C1525
D1: ASMB-MTB0-0A3A2; LED_Avago_PLCC4_3.2x2.8mm_CW; MPN Broadcom ASMB-MTB0-0A3A2
F1: PTC 750mA hold; Fuse_1206_3216Metric; MPN BHFUSE BSMD1206-075-6V; LCSC C883127
FB1: 600R@100MHz; L_0805_2012Metric; MPN Sunlord GZ2012D601TF; LCSC C1017
H1, H2: M2; MountingHole_2.2mm_M2
J1: USB-C (HRO TYPE-C-31-M-12); USB_C_Receptacle_HRO_TYPE-C-31-M-12; MPN HRO TYPE-C-31-M-12; LCSC C165948
J2: SWD; PinHeader_1x05_P1.27mm_Vertical; MPN XFCN PZ127V-11-05-H25; LCSC C962329
R1, R2: 5.1k; R_0402_1005Metric; MPN UNI-ROYAL 0402WGF5101TCE; LCSC C25905
R3: 1k; R_0402_1005Metric; MPN UNI-ROYAL 0402WGF1001TCE; LCSC C11702
R4, R5: 330; R_0402_1005Metric; MPN UNI-ROYAL 0402WGF3300TCE; LCSC C25104
SW1: Pair; SW_SPST_TL3342; MPN E-Switch TL3342F160QG; LCSC C2886898
SW2: Reset; SW_SPST_TL3342; MPN E-Switch TL3342F160QG; LCSC C2886898
U1: USBLC6-2SC6; SOT-23-6; MPN ST USBLC6-2SC6; LCSC C7519
U2: MDBT50Q-P1MV2; Raytac_MDBT50Q; MPN Raytac MDBT50Q-P1MV2; LCSC C5119772

Connections:
/+3V3: C3.1, C4.1, D1.1 (A), J2.1, U2.28 (VDD)
/CC1: J1.A5 (CC1), R1.1
/CC2: J1.B5 (CC2), R2.1
/D+: J1.A6 (D+), J1.B6 (D+), U1.1 (I/O1), U1.6 (I/O1), U2.35 (D+)
/D-: J1.A7 (D-), J1.B7 (D-), U1.3 (I/O2), U1.4 (I/O2), U2.34 (D-)
/LED_B: R5.2, U2.29 (P0.12)
/LED_BK: D1.2 (BK), R5.1
/LED_G: R4.2, U2.26 (P1.09)
/LED_GK: D1.3 (GK), R4.1
/LED_R: R3.2, U2.24 (P0.08)
/LED_RK: D1.4 (RK), R3.1
/NRESET: J2.4, SW2.1, U2.40 (P0.18)
/PAIR: SW1.1, U2.57 (P1.06)
/SHIELD: FB1.1, J1.SH (SHIELD)
/SWDCLK: J2.3, U2.53 (SWDCLK)
/SWDIO: J2.2, U2.51 (SWDIO)
/VBUS: C1.1, C2.1, F1.2, U2.30 (VDDH), U2.32 (VBUS)
/VBUS_RAW: F1.1, J1.A4 (VBUS), J1.A9 (VBUS), J1.B4 (VBUS), J1.B9 (VBUS), U1.5 (VBUS)
GND: C1.2, C2.2, C3.2, C4.2, FB1.2, J1.A1 (GND), J1.A12 (GND), J1.B1 (GND), J1.B12 (GND), J2.5, R1.2, R2.2, SW1.2, SW2.2, U1.2 (GND), U2.1 (GND), U2.2 (GND), U2.15 (GND), U2.33 (GND), U2.55 (GND)

Notes on the sheet:
Dachshund70 2.4 GHz dongle (receiver)
40 x 24 mm, 2 layers, 1.6 mm. USB-C to the computer; sits on the desk near the keyboard.
Module antenna flush with the right edge: no copper on any layer in the antenna strip.
USB 2.0 full speed (12 Mbit/s): 1 ms polling (1000 Hz) is the limit. Rd 5.1k on CC1/CC2, no PD.
VBUS feeds VBUS and VDDH (high-voltage mode); REGOUT0 = 3.3 V set by firmware. DCCH unconnected.
Button and LED pins match Nordic's PCA10059 dongle. Pins: boards/Dachshund70/board.json.

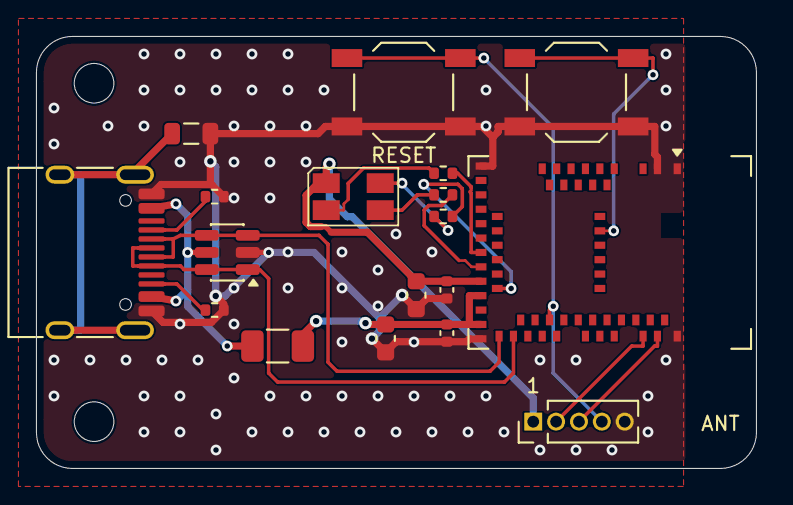
[picture p45: board Dachshund70-Dongle.kicad_pcb from above]

Board: 2 copper layers, 40.0 x 24.0 mm, 20 parts (0 on the bottom side), 19 nets.
