TiamDesigns/Dachshund60F/boards/Pup/firmware/board_keymap.h

/* The Pup's default keymap size: one key (boards/Pup/keyboard.json). */
#ifndef BOARD_KEYMAP_H
#define BOARD_KEYMAP_H

#define DEFAULT_KEYMAP_LAYERS 4
#define DEFAULT_KEYMAP_ROWS 1
#define DEFAULT_KEYMAP_COLS 1

#endif /* BOARD_KEYMAP_H */
