TiamDesigns/Dachshund60F/firmware/src/main.c

/*
 * Keyboard firmware entry point.
 *
 * Matrix scanning and the keymap (phase 3) typing over USB with NKRO,
 * media and system keys (phase 4), the config protocol on a vendor HID
 * interface (phase 5), indicator LEDs for layer and Caps Lock
 * after a power-on walk along the chain, the status screen when a
 * panel overlay is built in, and Bluetooth LE with host profiles
 * (phase 12), with keys going to USB or Bluetooth (output.c), and power
 * management: idle, deep sleep and the battery gauge (phase 13), and the
 * 2.4 GHz dongle (phase 14).
 */

#include <zephyr/kernel.h>
#include <zephyr/logging/log.h>

#include <app_version.h>

#include "kb/core.h"
#include "config.h"
#include "indicators.h"
#include "kb_ble.h"
#include "kb_esb.h"
#include "kb_usb.h"
#include "keyboard.h"
#include "power.h"
#include "status_screen.h"

LOG_MODULE_REGISTER(kb_main, LOG_LEVEL_INF);

int main(void)
{
    LOG_INF("keyboard firmware %s, core api %u", APP_VERSION_STRING,
            (unsigned)kb_core_api_version());

    /* First: it reads why the board started (a key waking it from deep sleep, or not). */
    if (power_init() != 0) {
        LOG_WRN("no battery gauge");
    }

    /* Start the keyboard first: its hold-Esc recovery key works even if USB fails. */
    if (keyboard_start() != 0) {
        LOG_ERR("keyboard unavailable");
    }

    /* Before USB, so the screen sees the first lock-state report. */
    if (IS_ENABLED(CONFIG_KB_SCREEN) && status_screen_init() != 0) {
        LOG_ERR("status screen unavailable");
    }

    /* Before USB, so the first config request finds a listener. */
    if (config_start() != 0) {
        LOG_ERR("config protocol unavailable");
    }

    if (kb_usb_init() != 0) {
        LOG_ERR("USB init failed");
    }

    /* Also loads the preferred output; until then keys prefer USB. */
    if (kb_ble_init() != 0) {
        LOG_ERR("Bluetooth unavailable");
    }

    /* After the settings load (kb_ble_init), which has the paired dongle. */
    if (IS_ENABLED(CONFIG_KB_DONGLE) && kb_esb_init() != 0) {
        LOG_ERR("2.4 GHz radio unavailable");
    }

    /* No LED walk when a key just woke the board: it is in use. */
    if (indicators_start(!power_woke_from_sleep()) != 0) {
        LOG_ERR("indicator LEDs unavailable");
    }

    return 0;
}
