TiamDesigns/Dachshund60F/firmware/core/include/kb/protocol.h

/*
 * Config protocol: handles one request frame from the host and builds the
 * response frame. Frame layout and commands are defined in
 * protocol/protocol.yaml (bindings in kb/protocol_gen.h).
 *
 * Hardware- and transport-independent: the firmware hands in the bytes of
 * one output report (USB now, BLE and the dongle later) and sends back the
 * response. Every index and length from the host is checked here; a
 * malformed frame gets an error status and changes nothing.
 */
#ifndef KB_PROTOCOL_H
#define KB_PROTOCOL_H

#include <stdbool.h>
#include <stddef.h>
#include <stdint.h>

#include "kb/features.h"
#include "kb/keymap.h"
#include "kb/protocol_gen.h"
#include "kb/settings.h"

/* What the firmware does for the commands that reach beyond the keymap. */
/* pair_dongle modes */
#define KB_PROTO_PAIR_STOP 0u
#define KB_PROTO_PAIR_START 1u
#define KB_PROTO_PAIR_FORGET 2u

struct kb_protocol_ops {
    /*
     * Save, revert, factory reset: return a KB_PROTO_* status. Revert and
     * factory reset replace the live keymap themselves.
     */
    uint8_t (*save)(void *ctx);
    uint8_t (*revert)(void *ctx);
    uint8_t (*factory_reset)(void *ctx);
    /* Reboot once the response is on its way (bootloader: into UF2). */
    void (*reboot)(bool bootloader, void *ctx);
    /* Flash the indicators for this many seconds. NULL: not supported. */
    void (*identify)(uint8_t seconds, void *ctx);
    /*
     * The advanced-key tables changed (called with the lock held), so the
     * engine can drop state that refers to the old ones. Optional.
     */
    void (*features_changed)(void *ctx);
    /*
     * The settings or indicator colours changed (called with the lock
     * held), so the firmware can put them into effect. Optional.
     */
    void (*settings_changed)(void *ctx);
    /*
     * Bluetooth host profiles and output selection (kb/output.h). All four
     * or none: without them get_connection and friends answer
     * not_supported. The protocol checks the output and profile numbers
     * first; the others return a KB_PROTO_* status (busy while Bluetooth
     * can't do it yet).
     */
    void (*get_connection)(struct kb_proto_get_connection_resp *out, void *ctx);
    uint8_t (*set_output)(uint8_t output, void *ctx);
    uint8_t (*select_profile)(uint8_t profile, void *ctx);
    uint8_t (*clear_profile)(uint8_t profile, void *ctx);
    /* The battery and the power source (get_power). NULL: not supported. */
    void (*get_power)(struct kb_proto_get_power_resp *out, void *ctx);
    /*
     * Input timing (get_timing); with reset, the counters start again from
     * zero after this reading. NULL: not supported.
     */
    void (*get_timing)(struct kb_proto_get_timing_resp *out, bool reset, void *ctx);
    /*
     * The 2.4 GHz dongle (get_dongle, pair_dongle, and set_output 3). Both
     * or neither; NULL: not in this build. pair_dongle gets a checked mode
     * (KB_PROTO_PAIR_*) and returns a KB_PROTO_* status.
     */
    void (*get_dongle)(struct kb_proto_get_dongle_resp *out, void *ctx);
    uint8_t (*pair_dongle)(uint8_t mode, void *ctx);
    /* Guard keymap changes against the scan thread. Optional. */
    void (*lock)(void *ctx);
    void (*unlock)(void *ctx);
};

struct kb_protocol {
    struct kb_keymap *keymap;
    const struct kb_protocol_ops *ops;
    void *ctx;
    /* Handshake fields that don't come from the keymap. */
    uint8_t firmware_major;
    uint8_t firmware_minor;
    uint8_t firmware_patch;
    const char *build;
    const char *model;
    const char *serial; /* the USB serial number string */
    uint32_t capabilities;
    uint8_t encoders;
    uint8_t ble_profiles; /* select_profile and clear_profile take 0 to this - 1 */
    uint16_t macro_buffer_size;
    /*
     * The live advanced-key tables, and a KB_MACRO_BUFFER-byte buffer where
     * the host edits macros before apply_macros. NULL: the feature commands
     * answer not_supported. Revert and factory reset replace the tables
     * themselves; the edit buffer is refreshed here.
     */
    struct kb_features *features;
    uint8_t *macro_edit;
    /*
     * The live global settings and indicator colours (the colours'
     * brightness comes from the settings). NULL: their commands answer
     * not_supported. Revert and factory reset replace them themselves.
     */
    struct kb_settings *settings;
    struct kb_indicator_config *indicators;
};

/*
 * Handle one request of req_len bytes (a whole report, or less) and write
 * a KB_PROTO_REPORT_SIZE response into resp, zero-padded. Returns false if
 * the request is too short to answer (no header).
 */
bool kb_protocol_handle(const struct kb_protocol *p, const uint8_t *req, size_t req_len,
                        uint8_t resp[KB_PROTO_REPORT_SIZE]);

#endif /* KB_PROTOCOL_H */
