TiamDesigns/Dachshund60F/firmware/core/tests/test_protocol.c

#include "kb_test.h"
#include "protocol_fixture.h"

static uint8_t req[KB_PROTO_REPORT_SIZE];
static uint8_t resp[KB_PROTO_REPORT_SIZE];
static uint8_t seq;

/* Send a command with a payload and return the response status. */
static uint8_t call(uint8_t command, const uint8_t *payload, uint8_t len)
{
    memset(req, 0, sizeof(req));
    req[KB_PROTO_OFF_COMMAND] = command;
    req[KB_PROTO_OFF_SEQUENCE] = ++seq;
    req[KB_PROTO_OFF_LENGTH] = len;
    req[KB_PROTO_OFF_VERSION] = KB_PROTO_VERSION;
    if (len) {
        memcpy(&req[KB_PROTO_HEADER_SIZE], payload, len);
    }
    memset(resp, 0xAA, sizeof(resp));
    KB_CHECK(kb_protocol_handle(&fx_proto, req, sizeof(req), resp));
    KB_CHECK_EQ(resp[KB_PROTO_OFF_COMMAND], command);
    KB_CHECK_EQ(resp[KB_PROTO_OFF_SEQUENCE], seq);
    return resp[KB_PROTO_OFF_STATUS];
}

static const uint8_t *payload(void)
{
    return &resp[KB_PROTO_HEADER_SIZE];
}

static uint8_t payload_len(void)
{
    return resp[KB_PROTO_OFF_LENGTH];
}

static void test_handshake(void)
{
    fx_init();
    KB_CHECK_EQ(call(KB_PROTO_CMD_HANDSHAKE, NULL, 0), KB_PROTO_OK);
    struct kb_proto_handshake_resp h;
    KB_CHECK_EQ(kb_proto_handshake_resp_decode(payload(), payload_len(), &h), 0);
    KB_CHECK_EQ(h.protocol_version, KB_PROTO_VERSION);
    KB_CHECK_EQ(h.firmware_minor, 4);
    KB_CHECK_EQ(h.rows, FX_ROWS);
    KB_CHECK_EQ(h.cols, FX_COLS);
    KB_CHECK_EQ(h.layers, FX_LAYERS);
    KB_CHECK_EQ(h.encoders, 1);
    KB_CHECK_EQ(h.capabilities, KB_PROTO_CAP_KEYMAP | KB_PROTO_CAP_IDENTIFY);
    KB_CHECK(strcmp(h.model, "Dachshund70") == 0);
    KB_CHECK(strcmp(h.build, "abc1234") == 0);
    /* The padding after the payload is zero. */
    for (size_t i = KB_PROTO_HEADER_SIZE + payload_len(); i < KB_PROTO_REPORT_SIZE; i++) {
        KB_CHECK_EQ(resp[i], 0);
    }
}

static void test_get_serial(void)
{
    fx_init();
    KB_CHECK_EQ(call(KB_PROTO_CMD_GET_SERIAL, NULL, 0), KB_PROTO_OK);
    struct kb_proto_get_serial_resp r;
    KB_CHECK_EQ(kb_proto_get_serial_resp_decode(payload(), payload_len(), &r), 0);
    KB_CHECK(strcmp(r.serial, "0123456789ABCDEF") == 0);
    uint8_t one = 0;
    KB_CHECK_EQ(call(KB_PROTO_CMD_GET_SERIAL, &one, 1), KB_PROTO_BAD_LENGTH);
}

static void test_version_mismatch(void)
{
    fx_init();
    uint8_t p[5] = {0, 0, 0, (uint8_t)KC_Z, 0};
    memset(req, 0, sizeof(req));
    req[KB_PROTO_OFF_COMMAND] = KB_PROTO_CMD_SET_KEY;
    req[KB_PROTO_OFF_LENGTH] = sizeof(p);
    req[KB_PROTO_OFF_VERSION] = KB_PROTO_VERSION + 1;
    memcpy(&req[KB_PROTO_HEADER_SIZE], p, sizeof(p));
    KB_CHECK(kb_protocol_handle(&fx_proto, req, sizeof(req), resp));
    KB_CHECK_EQ(resp[KB_PROTO_OFF_STATUS], KB_PROTO_VERSION_MISMATCH);
    KB_CHECK_EQ(fx.live[0], KC_A);

    /* Handshake still answers, so the app can say which versions differ. */
    req[KB_PROTO_OFF_COMMAND] = KB_PROTO_CMD_HANDSHAKE;
    req[KB_PROTO_OFF_LENGTH] = 0;
    KB_CHECK(kb_protocol_handle(&fx_proto, req, sizeof(req), resp));
    KB_CHECK_EQ(resp[KB_PROTO_OFF_STATUS], KB_PROTO_OK);
}

static void test_framing_errors(void)
{
    fx_init();
    /* Too short to have a header: no answer. */
    KB_CHECK(!kb_protocol_handle(&fx_proto, req, 3, resp));

    KB_CHECK_EQ(call(0xEE, NULL, 0), KB_PROTO_UNKNOWN_COMMAND);
    KB_CHECK_EQ(payload_len(), 0);

    /* Length beyond the payload area. */
    memset(req, 0, sizeof(req));
    req[KB_PROTO_OFF_COMMAND] = KB_PROTO_CMD_GET_KEY;
    req[KB_PROTO_OFF_LENGTH] = KB_PROTO_MAX_PAYLOAD + 1;
    req[KB_PROTO_OFF_VERSION] = KB_PROTO_VERSION;
    KB_CHECK(kb_protocol_handle(&fx_proto, req, sizeof(req), resp));
    KB_CHECK_EQ(resp[KB_PROTO_OFF_STATUS], KB_PROTO_BAD_LENGTH);

    /* Length beyond what was received (a short report). */
    req[KB_PROTO_OFF_LENGTH] = 3;
    KB_CHECK(kb_protocol_handle(&fx_proto, req, KB_PROTO_HEADER_SIZE + 2, resp));
    KB_CHECK_EQ(resp[KB_PROTO_OFF_STATUS], KB_PROTO_BAD_LENGTH);

    /* Wrong payload length for the command. */
    uint8_t two[2] = {0, 0};
    KB_CHECK_EQ(call(KB_PROTO_CMD_GET_KEY, two, 2), KB_PROTO_BAD_LENGTH);
    KB_CHECK_EQ(call(KB_PROTO_CMD_SAVE, two, 1), KB_PROTO_BAD_LENGTH);
    KB_CHECK_EQ(fx.saves, 0);
}

static void test_get_and_set_key(void)
{
    fx_init();
    uint8_t get[3] = {1, 1, 3};
    KB_CHECK_EQ(call(KB_PROTO_CMD_GET_KEY, get, 3), KB_PROTO_OK);
    KB_CHECK_EQ(payload_len(), 2);
    KB_CHECK_EQ(payload()[0] | (payload()[1] << 8), QK_BOOT);

    uint8_t set[5] = {0, 0, 1, (uint8_t)(LSFT(KC_1) & 0xFF), (uint8_t)(LSFT(KC_1) >> 8)};
    KB_CHECK_EQ(call(KB_PROTO_CMD_SET_KEY, set, 5), KB_PROTO_OK);
    KB_CHECK_EQ(kb_keymap_get(&fx.keymap, 0, 0, 1), LSFT(KC_1));
    KB_CHECK_EQ(fx.locks, fx.unlocks);
    KB_CHECK(fx.locks >= 2);

    /* Out of range indices */
    uint8_t bad_layer[3] = {FX_LAYERS, 0, 0};
    uint8_t bad_row[3] = {0, FX_ROWS, 0};
    uint8_t bad_col[3] = {0, 0, FX_COLS};
    KB_CHECK_EQ(call(KB_PROTO_CMD_GET_KEY, bad_layer, 3), KB_PROTO_OUT_OF_RANGE);
    KB_CHECK_EQ(call(KB_PROTO_CMD_GET_KEY, bad_row, 3), KB_PROTO_OUT_OF_RANGE);
    KB_CHECK_EQ(call(KB_PROTO_CMD_GET_KEY, bad_col, 3), KB_PROTO_OUT_OF_RANGE);
    uint8_t set_bad[5] = {0, 0, 255, KC_A, 0};
    KB_CHECK_EQ(call(KB_PROTO_CMD_SET_KEY, set_bad, 5), KB_PROTO_OUT_OF_RANGE);

    /* Invalid keycodes: undefined, and a layer key past the layer count. */
    uint8_t undefined[5] = {0, 0, 0, 0xFF, 0xFF};
    KB_CHECK_EQ(call(KB_PROTO_CMD_SET_KEY, undefined, 5), KB_PROTO_BAD_VALUE);
    uint8_t mo9[5] = {0, 0, 0, (uint8_t)(MO(9) & 0xFF), (uint8_t)(MO(9) >> 8)};
    KB_CHECK_EQ(call(KB_PROTO_CMD_SET_KEY, mo9, 5), KB_PROTO_BAD_VALUE);
    KB_CHECK_EQ(fx.live[0], KC_A);
}

static void test_keymap_chunks(void)
{
    fx_init();
    /* Read the whole keymap in chunks of up to 28. */
    kb_keycode_t all[FX_KEYS];
    for (uint16_t off = 0; off < FX_KEYS;) {
        uint8_t n = (uint8_t)(FX_KEYS - off > 28 ? 28 : FX_KEYS - off);
        uint8_t p[3] = {(uint8_t)off, (uint8_t)(off >> 8), n};
        KB_CHECK_EQ(call(KB_PROTO_CMD_GET_KEYMAP_CHUNK, p, 3), KB_PROTO_OK);
        struct kb_proto_get_keymap_chunk_resp r;
        KB_CHECK_EQ(kb_proto_get_keymap_chunk_resp_decode(payload(), payload_len(), &r), 0);
        KB_CHECK_EQ(r.offset, off);
        KB_CHECK_EQ(r.keycodes_count, n);
        memcpy(&all[off], r.keycodes, n * sizeof(kb_keycode_t));
        off = (uint16_t)(off + n);
    }
    KB_CHECK(memcmp(all, fx_default, sizeof(all)) == 0);

    /* Past the end, or more than fits */
    uint8_t past[3] = {(uint8_t)(FX_KEYS - 1), 0, 2};
    KB_CHECK_EQ(call(KB_PROTO_CMD_GET_KEYMAP_CHUNK, past, 3), KB_PROTO_OUT_OF_RANGE);
    uint8_t too_many[3] = {0, 0, 29};
    KB_CHECK_EQ(call(KB_PROTO_CMD_GET_KEYMAP_CHUNK, too_many, 3), KB_PROTO_OUT_OF_RANGE);
    uint8_t huge[3] = {0xFF, 0xFF, 1};
    KB_CHECK_EQ(call(KB_PROTO_CMD_GET_KEYMAP_CHUNK, huge, 3), KB_PROTO_OUT_OF_RANGE);

    /* Write keys 10-12 (layer 1, row 0, cols 0-2). */
    struct kb_proto_set_keymap_chunk_req w = {.offset = 10, .keycodes_count = 3,
                                              .keycodes = {KC_X, KC_Y, TG(2)}};
    uint8_t buf[KB_PROTO_MAX_PAYLOAD];
    size_t n = kb_proto_set_keymap_chunk_req_encode(&w, buf);
    KB_CHECK_EQ(call(KB_PROTO_CMD_SET_KEYMAP_CHUNK, buf, (uint8_t)n), KB_PROTO_OK);
    KB_CHECK_EQ(kb_keymap_get(&fx.keymap, 1, 0, 0), KC_X);
    KB_CHECK_EQ(kb_keymap_get(&fx.keymap, 1, 0, 2), TG(2));

    /* One bad keycode: nothing is written. */
    w.keycodes[0] = KC_Z;
    w.keycodes[2] = 0xFFFF;
    n = kb_proto_set_keymap_chunk_req_encode(&w, buf);
    KB_CHECK_EQ(call(KB_PROTO_CMD_SET_KEYMAP_CHUNK, buf, (uint8_t)n), KB_PROTO_BAD_VALUE);
    KB_CHECK_EQ(kb_keymap_get(&fx.keymap, 1, 0, 0), KC_X);

    /* Running past the end: nothing is written. */
    w.offset = FX_KEYS - 2;
    w.keycodes[2] = KC_Z;
    n = kb_proto_set_keymap_chunk_req_encode(&w, buf);
    KB_CHECK_EQ(call(KB_PROTO_CMD_SET_KEYMAP_CHUNK, buf, (uint8_t)n), KB_PROTO_OUT_OF_RANGE);
    KB_CHECK_EQ(fx.live[FX_KEYS - 1], fx_default[FX_LAYERS - 1][FX_ROWS - 1][FX_COLS - 1]);

    /* An odd payload length can't be a list of keycodes. */
    KB_CHECK_EQ(call(KB_PROTO_CMD_SET_KEYMAP_CHUNK, buf, 5), KB_PROTO_BAD_LENGTH);
}

static void test_save_revert_reset(void)
{
    fx_init();
    uint8_t set[5] = {0, 0, 0, KC_Q, 0};
    KB_CHECK_EQ(call(KB_PROTO_CMD_SET_KEY, set, 5), KB_PROTO_OK);
    KB_CHECK_EQ(call(KB_PROTO_CMD_REVERT, NULL, 0), KB_PROTO_OK);
    KB_CHECK_EQ(fx.live[0], KC_A);

    KB_CHECK_EQ(call(KB_PROTO_CMD_SET_KEY, set, 5), KB_PROTO_OK);
    KB_CHECK_EQ(call(KB_PROTO_CMD_SAVE, NULL, 0), KB_PROTO_OK);
    KB_CHECK_EQ(fx.saved[0], KC_Q);

    /* A failing save reports its status. */
    fx.save_status = KB_PROTO_STORAGE_FULL;
    KB_CHECK_EQ(call(KB_PROTO_CMD_SAVE, NULL, 0), KB_PROTO_STORAGE_FULL);
    KB_CHECK_EQ(payload_len(), 0);

    KB_CHECK_EQ(call(KB_PROTO_CMD_FACTORY_RESET, NULL, 0), KB_PROTO_OK);
    KB_CHECK_EQ(fx.live[0], KC_A);
    KB_CHECK_EQ(fx.saved[0], KC_A);
}

static void test_features(void)
{
    fx_init();
    /* Read the first combo: unused, all positions 0xFF. */
    uint8_t get[3] = {KB_PROTO_TABLE_COMBO, 0, 0};
    KB_CHECK_EQ(call(KB_PROTO_CMD_GET_FEATURE, get, 3), KB_PROTO_OK);
    KB_CHECK_EQ(payload_len(), 3 + KB_PROTO_TABLE_COMBO_SIZE);
    KB_CHECK_EQ(payload()[0], KB_PROTO_TABLE_COMBO);
    KB_CHECK_EQ(payload()[3], 0xFF);
    KB_CHECK_EQ(payload()[11], 0); /* result high byte */

    /* Combo 2: (0,0) + (0,1) = Esc. */
    uint8_t set[3 + 14] = {KB_PROTO_TABLE_COMBO, 2, 0, 0, 0, 0, 1, 0xFF, 0xFF, 0xFF, 0xFF,
                           KC_ESC, 0, 0, 0, 0, 0};
    KB_CHECK_EQ(call(KB_PROTO_CMD_SET_FEATURE, set, sizeof(set)), KB_PROTO_OK);
    KB_CHECK_EQ(fx.features.combos[2].result, KC_ESC);
    KB_CHECK_EQ(fx.features.combos[2].keys[1].col, 1);
    KB_CHECK_EQ(fx.feature_changes, 1);
    get[1] = 2;
    KB_CHECK_EQ(call(KB_PROTO_CMD_GET_FEATURE, get, 3), KB_PROTO_OK);
    KB_CHECK(memcmp(payload() + 3, set + 3, 14) == 0);

    /* A key off the board: refused, the old entry stays. */
    set[3 + 2] = 1;
    set[3 + 3] = FX_COLS;
    KB_CHECK_EQ(call(KB_PROTO_CMD_SET_FEATURE, set, sizeof(set)), KB_PROTO_BAD_VALUE);
    KB_CHECK_EQ(fx.features.combos[2].keys[1].col, 1);
    KB_CHECK_EQ(fx.feature_changes, 1);

    /* Options, shorter than the entry: only the fields given change. */
    uint8_t opt[3 + 2] = {KB_PROTO_TABLE_OPTIONS, 0, 0, 0xF4, 0x01}; /* Leader 500 ms */
    KB_CHECK_EQ(call(KB_PROTO_CMD_SET_FEATURE, opt, sizeof(opt)), KB_PROTO_OK);
    KB_CHECK_EQ(fx.features.leader_timeout_ms, 500);
    KB_CHECK_EQ(fx.features.auto_shift_ms, 175);

    /* Encoders: two per layer the keymap has. */
    uint8_t enc[3 + 4] = {KB_PROTO_TABLE_ENCODER, 7, 0, (uint8_t)KC_VOLU, (uint8_t)(KC_VOLU >> 8),
                          (uint8_t)KC_VOLD, (uint8_t)(KC_VOLD >> 8)};
    KB_CHECK_EQ(call(KB_PROTO_CMD_SET_FEATURE, enc, sizeof(enc)), KB_PROTO_OK);
    KB_CHECK_EQ(fx.features.encoders[3][1].ccw, KC_VOLD);
    enc[1] = FX_LAYERS * 2;
    KB_CHECK_EQ(call(KB_PROTO_CMD_SET_FEATURE, enc, sizeof(enc)), KB_PROTO_OUT_OF_RANGE);

    /* Bad table, index, lengths. */
    uint8_t bad[3] = {KB_PROTO_TABLE_COUNT, 0, 0};
    KB_CHECK_EQ(call(KB_PROTO_CMD_GET_FEATURE, bad, 3), KB_PROTO_OUT_OF_RANGE);
    bad[0] = KB_PROTO_TABLE_TAP_DANCE;
    bad[1] = 16;
    KB_CHECK_EQ(call(KB_PROTO_CMD_GET_FEATURE, bad, 3), KB_PROTO_OUT_OF_RANGE);
    KB_CHECK_EQ(call(KB_PROTO_CMD_GET_FEATURE, bad, 2), KB_PROTO_BAD_LENGTH);
    uint8_t too_long[3 + 11] = {KB_PROTO_TABLE_TAP_DANCE, 0, 0};
    KB_CHECK_EQ(call(KB_PROTO_CMD_SET_FEATURE, too_long, sizeof(too_long)), KB_PROTO_BAD_LENGTH);
    KB_CHECK_EQ(call(KB_PROTO_CMD_SET_FEATURE, too_long, 3), KB_PROTO_BAD_LENGTH);

    /* Revert brings back the saved tables. */
    KB_CHECK_EQ(call(KB_PROTO_CMD_REVERT, NULL, 0), KB_PROTO_OK);
    KB_CHECK_EQ(fx.features.combos[2].result, KC_NO);
    KB_CHECK_EQ(fx.locks, fx.unlocks);
}

static void test_macros(void)
{
    fx_init();
    /* "ab" then Enter, written in two chunks; nothing live until applied. */
    uint8_t c1[2 + 3] = {0, 0, 'a', 'b', KB_MACRO_TAP};
    uint8_t c2[2 + 2] = {3, 0, KC_ENT, 0};
    KB_CHECK_EQ(call(KB_PROTO_CMD_SET_MACRO_CHUNK, c1, sizeof(c1)), KB_PROTO_OK);
    KB_CHECK_EQ(fx.features.macros[0], 0);
    /* Half a step: applying now is refused. */
    uint8_t cut[2 + 1] = {5, 0, KB_MACRO_TAP};
    KB_CHECK_EQ(call(KB_PROTO_CMD_SET_MACRO_CHUNK, cut, sizeof(cut)), KB_PROTO_OK);
    KB_CHECK_EQ(call(KB_PROTO_CMD_SET_MACRO_CHUNK, c2, sizeof(c2)), KB_PROTO_OK);
    KB_CHECK_EQ(call(KB_PROTO_CMD_APPLY_MACROS, NULL, 0), KB_PROTO_BAD_VALUE);
    KB_CHECK_EQ(fx.features.macros[0], 0);
    /* The refused edit is gone; write it again, whole this time. */
    uint8_t clear[2 + 1] = {5, 0, KB_MACRO_END};
    KB_CHECK_EQ(call(KB_PROTO_CMD_SET_MACRO_CHUNK, c1, sizeof(c1)), KB_PROTO_OK);
    KB_CHECK_EQ(call(KB_PROTO_CMD_SET_MACRO_CHUNK, c2, sizeof(c2)), KB_PROTO_OK);
    KB_CHECK_EQ(call(KB_PROTO_CMD_SET_MACRO_CHUNK, clear, sizeof(clear)), KB_PROTO_OK);
    KB_CHECK_EQ(call(KB_PROTO_CMD_APPLY_MACROS, NULL, 0), KB_PROTO_OK);
    KB_CHECK_EQ(fx.features.macros[0], 'a');
    KB_CHECK_EQ(fx.features.macros[3], KC_ENT);
    KB_CHECK_EQ(fx.feature_changes, 1);

    uint8_t bad_step[2 + 1] = {10, 0, 0x05};
    KB_CHECK_EQ(call(KB_PROTO_CMD_SET_MACRO_CHUNK, bad_step, sizeof(bad_step)), KB_PROTO_OK);
    KB_CHECK_EQ(call(KB_PROTO_CMD_APPLY_MACROS, NULL, 0), KB_PROTO_BAD_VALUE);
    KB_CHECK_EQ(fx.features.macros[10], 0);

    /* The refused edit is dropped: reads show the live macros. */
    uint8_t get[3] = {0, 0, 12};
    KB_CHECK_EQ(call(KB_PROTO_CMD_GET_MACRO_CHUNK, get, 3), KB_PROTO_OK);
    KB_CHECK_EQ(payload_len(), 2 + 12);
    KB_CHECK_EQ(payload()[2], 'a');
    KB_CHECK_EQ(payload()[2 + 10], 0);

    /* An edit not yet applied is what reads show. */
    KB_CHECK_EQ(call(KB_PROTO_CMD_SET_MACRO_CHUNK, bad_step, sizeof(bad_step)), KB_PROTO_OK);
    KB_CHECK_EQ(call(KB_PROTO_CMD_GET_MACRO_CHUNK, get, 3), KB_PROTO_OK);
    KB_CHECK_EQ(payload()[2 + 10], 0x05);

    /* Revert drops the edit, and the saved macros (none) come back. */
    KB_CHECK_EQ(call(KB_PROTO_CMD_REVERT, NULL, 0), KB_PROTO_OK);
    KB_CHECK_EQ(call(KB_PROTO_CMD_GET_MACRO_CHUNK, get, 3), KB_PROTO_OK);
    KB_CHECK_EQ(payload()[2], 0);
    KB_CHECK_EQ(payload()[2 + 10], 0);

    /* Bounds. */
    uint8_t end[3] = {(uint8_t)(KB_MACRO_BUFFER - 4), (uint8_t)((KB_MACRO_BUFFER - 4) >> 8), 5};
    KB_CHECK_EQ(call(KB_PROTO_CMD_GET_MACRO_CHUNK, end, 3), KB_PROTO_OUT_OF_RANGE);
    end[2] = 57;
    end[0] = 0;
    end[1] = 0;
    KB_CHECK_EQ(call(KB_PROTO_CMD_GET_MACRO_CHUNK, end, 3), KB_PROTO_OUT_OF_RANGE);
    uint8_t over[2 + 4] = {(uint8_t)(KB_MACRO_BUFFER - 2), (uint8_t)((KB_MACRO_BUFFER - 2) >> 8)};
    KB_CHECK_EQ(call(KB_PROTO_CMD_SET_MACRO_CHUNK, over, sizeof(over)), KB_PROTO_OUT_OF_RANGE);
    KB_CHECK_EQ(call(KB_PROTO_CMD_APPLY_MACROS, c1, 1), KB_PROTO_BAD_LENGTH);
}

static void test_settings(void)
{
    fx_init();
    KB_CHECK_EQ(call(KB_PROTO_CMD_GET_SETTINGS, NULL, 0), KB_PROTO_OK);
    struct kb_proto_get_settings_resp g;
    KB_CHECK_EQ(kb_proto_get_settings_resp_decode(payload(), payload_len(), &g), 0);
    KB_CHECK_EQ(g.debounce_algorithm, 4);
    KB_CHECK_EQ(g.tapping_term_ms, 200);
    KB_CHECK_EQ(g.nkro, 1);
    KB_CHECK(strcmp(g.name, "") == 0);

    struct kb_proto_set_settings_req r = {
        .debounce_algorithm = 1,
        .debounce_ms = 8,
        .tapping_term_ms = 250,
        .nkro = 0,
        .sleep_timeout_min = 30,
        .indicator_brightness = 60,
        .name = "Frankfurter Long",
    };
    uint8_t buf[KB_PROTO_SET_SETTINGS_REQ_SIZE];
    KB_CHECK_EQ(kb_proto_set_settings_req_encode(&r, buf), sizeof(buf));
    KB_CHECK_EQ(call(KB_PROTO_CMD_SET_SETTINGS, buf, sizeof(buf)), KB_PROTO_OK);
    KB_CHECK_EQ(fx.settings.debounce_algo, 1);
    KB_CHECK_EQ(fx.settings.tapping_term_ms, 250);
    KB_CHECK(!fx.settings.nkro);
    KB_CHECK(strcmp(fx.settings.name, "Frankfurter Long") == 0);
    KB_CHECK_EQ(fx.settings_changes, 1);
    KB_CHECK_EQ(call(KB_PROTO_CMD_GET_SETTINGS, NULL, 0), KB_PROTO_OK);
    KB_CHECK_EQ(kb_proto_get_settings_resp_decode(payload(), payload_len(), &g), 0);
    KB_CHECK(strcmp(g.name, "Frankfurter Long") == 0);
    KB_CHECK_EQ(g.sleep_timeout_min, 30);

    /* Each field out of range: refused, nothing changes. */
    struct kb_proto_set_settings_req bad[] = {r, r, r, r, r, r, r, r};
    bad[0].debounce_algorithm = 5;
    bad[1].debounce_ms = 101;
    bad[2].tapping_term_ms = 49;
    bad[3].tapping_term_ms = 2001;
    bad[4].nkro = 2;
    bad[5].sleep_timeout_min = 241;
    bad[6].indicator_brightness = 101;
    bad[7].debounce_ms = 0;
    for (size_t i = 0; i < 7; i++) {
        bad[i].name[0] = 'X';
        kb_proto_set_settings_req_encode(&bad[i], buf);
        KB_CHECK_EQ(call(KB_PROTO_CMD_SET_SETTINGS, buf, sizeof(buf)), KB_PROTO_BAD_VALUE);
        KB_CHECK_EQ(fx.settings.name[0], 'F');
    }
    /* 0 ms debounce is allowed. */
    kb_proto_set_settings_req_encode(&bad[7], buf);
    KB_CHECK_EQ(call(KB_PROTO_CMD_SET_SETTINGS, buf, sizeof(buf)), KB_PROTO_OK);
    KB_CHECK_EQ(call(KB_PROTO_CMD_SET_SETTINGS, buf, sizeof(buf) - 1), KB_PROTO_BAD_LENGTH);
    KB_CHECK_EQ(call(KB_PROTO_CMD_GET_SETTINGS, buf, 1), KB_PROTO_BAD_LENGTH);
    KB_CHECK_EQ(fx.settings_changes, 2);

    /* Revert brings back the saved settings. */
    KB_CHECK_EQ(call(KB_PROTO_CMD_REVERT, NULL, 0), KB_PROTO_OK);
    KB_CHECK_EQ(fx.settings.tapping_term_ms, 200);
    KB_CHECK_EQ(fx.locks, fx.unlocks);
}

static void test_indicators(void)
{
    fx_init();
    KB_CHECK_EQ(call(KB_PROTO_CMD_GET_INDICATORS, NULL, 0), KB_PROTO_OK);
    struct kb_proto_get_indicators_resp g;
    KB_CHECK_EQ(kb_proto_get_indicators_resp_decode(payload(), payload_len(), &g), 0);
    KB_CHECK_EQ(g.caps, 0xFFDCB4u);
    KB_CHECK_EQ(g.battery_low_percent, 15);

    struct kb_proto_set_indicators_req r = {
        .caps = 0x112233,
        .num = 0,
        .scroll = 0xFFFFFF,
        .battery = 0x00FF00,
        .battery_low = 0xFF0000,
        .battery_low_percent = 20,
    };
    uint8_t buf[KB_PROTO_SET_INDICATORS_REQ_SIZE];
    kb_proto_set_indicators_req_encode(&r, buf);
    KB_CHECK_EQ(call(KB_PROTO_CMD_SET_INDICATORS, buf, sizeof(buf)), KB_PROTO_OK);
    KB_CHECK_EQ(fx.indicators.caps.r, 0x11);
    KB_CHECK_EQ(fx.indicators.caps.g, 0x22);
    KB_CHECK_EQ(fx.indicators.caps.b, 0x33);
    KB_CHECK_EQ(fx.indicators.battery_low_pct, 20);
    KB_CHECK_EQ(fx.settings_changes, 1);

    r.battery = 0x01000000; /* not a colour */
    kb_proto_set_indicators_req_encode(&r, buf);
    KB_CHECK_EQ(call(KB_PROTO_CMD_SET_INDICATORS, buf, sizeof(buf)), KB_PROTO_BAD_VALUE);
    r.battery = 0;
    r.battery_low_percent = 101;
    kb_proto_set_indicators_req_encode(&r, buf);
    KB_CHECK_EQ(call(KB_PROTO_CMD_SET_INDICATORS, buf, sizeof(buf)), KB_PROTO_BAD_VALUE);
    KB_CHECK_EQ(fx.indicators.battery.g, 0xFF);

    /* Layer colours, for the layers the keymap has. */
    uint8_t set[5] = {2, 0x56, 0x34, 0x12, 0};
    KB_CHECK_EQ(call(KB_PROTO_CMD_SET_LAYER_COLOUR, set, sizeof(set)), KB_PROTO_OK);
    KB_CHECK_EQ(fx.indicators.layer[2].r, 0x12);
    KB_CHECK_EQ(fx.indicators.layer[2].b, 0x56);
    uint8_t get = 2;
    KB_CHECK_EQ(call(KB_PROTO_CMD_GET_LAYER_COLOUR, &get, 1), KB_PROTO_OK);
    KB_CHECK_EQ(payload_len(), 5);
    KB_CHECK(memcmp(payload(), set, 5) == 0);
    get = FX_LAYERS;
    KB_CHECK_EQ(call(KB_PROTO_CMD_GET_LAYER_COLOUR, &get, 1), KB_PROTO_OUT_OF_RANGE);
    set[0] = FX_LAYERS;
    KB_CHECK_EQ(call(KB_PROTO_CMD_SET_LAYER_COLOUR, set, sizeof(set)), KB_PROTO_OUT_OF_RANGE);
    set[0] = 1;
    set[4] = 1;
    KB_CHECK_EQ(call(KB_PROTO_CMD_SET_LAYER_COLOUR, set, sizeof(set)), KB_PROTO_BAD_VALUE);
    KB_CHECK_EQ(call(KB_PROTO_CMD_SET_LAYER_COLOUR, set, 4), KB_PROTO_BAD_LENGTH);
    KB_CHECK_EQ(fx.settings_changes, 2);

    KB_CHECK_EQ(call(KB_PROTO_CMD_FACTORY_RESET, NULL, 0), KB_PROTO_OK);
    KB_CHECK_EQ(fx.indicators.layer[2].r, 0);
    KB_CHECK_EQ(fx.locks, fx.unlocks);
}

static void test_features_not_supported(void)
{
    fx_init();
    fx_proto.features = NULL;
    uint8_t get[3] = {0, 0, 0};
    KB_CHECK_EQ(call(KB_PROTO_CMD_GET_FEATURE, get, 3), KB_PROTO_NOT_SUPPORTED);
    KB_CHECK_EQ(call(KB_PROTO_CMD_GET_MACRO_CHUNK, get, 3), KB_PROTO_NOT_SUPPORTED);
    KB_CHECK_EQ(call(KB_PROTO_CMD_APPLY_MACROS, NULL, 0), KB_PROTO_NOT_SUPPORTED);

    fx_proto.settings = NULL;
    fx_proto.indicators = NULL;
    KB_CHECK_EQ(call(KB_PROTO_CMD_GET_SETTINGS, NULL, 0), KB_PROTO_NOT_SUPPORTED);
    KB_CHECK_EQ(call(KB_PROTO_CMD_GET_INDICATORS, NULL, 0), KB_PROTO_NOT_SUPPORTED);
    KB_CHECK_EQ(call(KB_PROTO_CMD_GET_LAYER_COLOUR, get, 1), KB_PROTO_NOT_SUPPORTED);
}

static void test_connection(void)
{
    fx_init();
    KB_CHECK_EQ(call(KB_PROTO_CMD_GET_CONNECTION, NULL, 0), KB_PROTO_OK);
    struct kb_proto_get_connection_resp c;
    KB_CHECK_EQ(kb_proto_get_connection_resp_decode(payload(), payload_len(), &c), 0);
    KB_CHECK_EQ(c.active_output, KB_OUTPUT_USB);
    KB_CHECK_EQ(c.preferred_output, KB_OUTPUT_USB);
    KB_CHECK_EQ(c.usb, 1);
    KB_CHECK_EQ(c.ble, KB_BLE_SECURE);
    KB_CHECK_EQ(c.profile, 0);
    KB_CHECK_EQ(c.profile_count, 3);
    KB_CHECK_EQ(c.bonded, 0x1);
    KB_CHECK_EQ(call(KB_PROTO_CMD_GET_CONNECTION, &c.profile, 1), KB_PROTO_BAD_LENGTH);

    /* Prefer Bluetooth: keys move there. */
    uint8_t out = KB_OUTPUT_BLE;
    KB_CHECK_EQ(call(KB_PROTO_CMD_SET_OUTPUT, &out, 1), KB_PROTO_OK);
    KB_CHECK_EQ(call(KB_PROTO_CMD_GET_CONNECTION, NULL, 0), KB_PROTO_OK);
    kb_proto_get_connection_resp_decode(payload(), payload_len(), &c);
    KB_CHECK_EQ(c.active_output, KB_OUTPUT_BLE);
    KB_CHECK_EQ(c.preferred_output, KB_OUTPUT_BLE);
    /* No such output: nothing changes. */
    const uint8_t bad[] = {KB_OUTPUT_NONE, 4, 0xFF};
    for (size_t i = 0; i < sizeof(bad); i++) {
        KB_CHECK_EQ(call(KB_PROTO_CMD_SET_OUTPUT, &bad[i], 1), KB_PROTO_BAD_VALUE);
    }
    KB_CHECK_EQ(fx.preferred, KB_OUTPUT_BLE);
    /* The dongle, before it is in range: preferred, but keys stay on Bluetooth. */
    out = KB_OUTPUT_DONGLE;
    KB_CHECK_EQ(call(KB_PROTO_CMD_SET_OUTPUT, &out, 1), KB_PROTO_OK);
    KB_CHECK_EQ(call(KB_PROTO_CMD_GET_CONNECTION, NULL, 0), KB_PROTO_OK);
    kb_proto_get_connection_resp_decode(payload(), payload_len(), &c);
    KB_CHECK_EQ(c.preferred_output, KB_OUTPUT_DONGLE);
    KB_CHECK_EQ(c.active_output, KB_OUTPUT_USB);
    fx.dongle_ready = true;
    KB_CHECK_EQ(call(KB_PROTO_CMD_GET_CONNECTION, NULL, 0), KB_PROTO_OK);
    kb_proto_get_connection_resp_decode(payload(), payload_len(), &c);
    KB_CHECK_EQ(c.active_output, KB_OUTPUT_DONGLE);
    out = KB_OUTPUT_BLE;
    KB_CHECK_EQ(call(KB_PROTO_CMD_SET_OUTPUT, &out, 1), KB_PROTO_OK);
    /* A build without the dongle refuses it. */
    struct kb_protocol_ops no_dongle = *fx_proto.ops;
    no_dongle.get_dongle = NULL;
    no_dongle.pair_dongle = NULL;
    fx_proto.ops = &no_dongle;
    out = KB_OUTPUT_DONGLE;
    KB_CHECK_EQ(call(KB_PROTO_CMD_SET_OUTPUT, &out, 1), KB_PROTO_NOT_SUPPORTED);
    KB_CHECK_EQ(call(KB_PROTO_CMD_GET_DONGLE, NULL, 0), KB_PROTO_NOT_SUPPORTED);
    KB_CHECK_EQ(call(KB_PROTO_CMD_PAIR_DONGLE, &out, 1), KB_PROTO_NOT_SUPPORTED);
    KB_CHECK_EQ(fx.preferred, KB_OUTPUT_BLE);
    fx_proto.ops = &fx_ops;
    KB_CHECK_EQ(call(KB_PROTO_CMD_SET_OUTPUT, NULL, 0), KB_PROTO_BAD_LENGTH);

    /* Profiles: only 0-2 exist. */
    uint8_t profile = 2;
    KB_CHECK_EQ(call(KB_PROTO_CMD_SELECT_PROFILE, &profile, 1), KB_PROTO_OK);
    KB_CHECK_EQ(fx.profile, 2);
    profile = 3;
    KB_CHECK_EQ(call(KB_PROTO_CMD_SELECT_PROFILE, &profile, 1), KB_PROTO_OUT_OF_RANGE);
    KB_CHECK_EQ(call(KB_PROTO_CMD_CLEAR_PROFILE, &profile, 1), KB_PROTO_OUT_OF_RANGE);
    profile = 0xFF;
    KB_CHECK_EQ(call(KB_PROTO_CMD_CLEAR_PROFILE, &profile, 1), KB_PROTO_OUT_OF_RANGE);
    KB_CHECK_EQ(fx.profile_selects, 1);
    KB_CHECK_EQ(fx.profile_clears, 0);
    profile = 0;
    KB_CHECK_EQ(call(KB_PROTO_CMD_CLEAR_PROFILE, &profile, 1), KB_PROTO_OK);
    KB_CHECK_EQ(fx.bonded, 0);
    const uint8_t two[2] = {0, 0};
    KB_CHECK_EQ(call(KB_PROTO_CMD_CLEAR_PROFILE, two, 2), KB_PROTO_BAD_LENGTH);

    /* The firmware's own refusal comes through. */
    fx.ble_status = KB_PROTO_BUSY;
    profile = 1;
    KB_CHECK_EQ(call(KB_PROTO_CMD_SELECT_PROFILE, &profile, 1), KB_PROTO_BUSY);
    KB_CHECK_EQ(fx.profile, 2);

    /* A build without Bluetooth. */
    fx_proto.ble_profiles = 0;
    profile = 0;
    KB_CHECK_EQ(call(KB_PROTO_CMD_SELECT_PROFILE, &profile, 1), KB_PROTO_OUT_OF_RANGE);
    static const struct kb_protocol_ops none = {0};
    fx_proto.ops = &none;
    KB_CHECK_EQ(call(KB_PROTO_CMD_GET_CONNECTION, NULL, 0), KB_PROTO_NOT_SUPPORTED);
    KB_CHECK_EQ(call(KB_PROTO_CMD_SET_OUTPUT, &out, 1), KB_PROTO_NOT_SUPPORTED);
    KB_CHECK_EQ(call(KB_PROTO_CMD_SELECT_PROFILE, &profile, 1), KB_PROTO_NOT_SUPPORTED);
    KB_CHECK_EQ(call(KB_PROTO_CMD_CLEAR_PROFILE, &profile, 1), KB_PROTO_NOT_SUPPORTED);
}

static void test_dongle(void)
{
    fx_init();
    fx.dongle = (struct kb_proto_get_dongle_resp){.paired = 1, .link = 3, .pairing = 0};
    KB_CHECK_EQ(call(KB_PROTO_CMD_GET_DONGLE, NULL, 0), KB_PROTO_OK);
    struct kb_proto_get_dongle_resp d;
    KB_CHECK_EQ(kb_proto_get_dongle_resp_decode(payload(), payload_len(), &d), 0);
    KB_CHECK_EQ(d.paired, 1);
    KB_CHECK_EQ(d.link, 3);
    KB_CHECK_EQ(d.pairing, 0);
    uint8_t one = 1;
    KB_CHECK_EQ(call(KB_PROTO_CMD_GET_DONGLE, &one, 1), KB_PROTO_BAD_LENGTH);

    uint8_t mode = KB_PROTO_PAIR_START;
    KB_CHECK_EQ(call(KB_PROTO_CMD_PAIR_DONGLE, &mode, 1), KB_PROTO_OK);
    KB_CHECK_EQ(fx.pair_mode, KB_PROTO_PAIR_START);
    KB_CHECK_EQ(fx.dongle.pairing, 1);
    mode = KB_PROTO_PAIR_FORGET;
    KB_CHECK_EQ(call(KB_PROTO_CMD_PAIR_DONGLE, &mode, 1), KB_PROTO_OK);
    KB_CHECK_EQ(fx.dongle.paired, 0);
    /* Unknown modes and lengths never reach the firmware. */
    const uint8_t bad[] = {3, 0x80, 0xFF};
    for (size_t i = 0; i < sizeof(bad); i++) {
        KB_CHECK_EQ(call(KB_PROTO_CMD_PAIR_DONGLE, &bad[i], 1), KB_PROTO_BAD_VALUE);
    }
    KB_CHECK_EQ(call(KB_PROTO_CMD_PAIR_DONGLE, NULL, 0), KB_PROTO_BAD_LENGTH);
    const uint8_t two[2] = {1, 0};
    KB_CHECK_EQ(call(KB_PROTO_CMD_PAIR_DONGLE, two, 2), KB_PROTO_BAD_LENGTH);
    KB_CHECK_EQ(fx.pair_calls, 2);
}

static void test_power_and_timing(void)
{
    fx_init();
    KB_CHECK_EQ(call(KB_PROTO_CMD_GET_POWER, NULL, 0), KB_PROTO_OK);
    struct kb_proto_get_power_resp pw;
    KB_CHECK_EQ(kb_proto_get_power_resp_decode(payload(), payload_len(), &pw), 0);
    KB_CHECK_EQ(pw.battery_percent, 80);
    KB_CHECK_EQ(pw.battery_mv, 4020);
    KB_CHECK_EQ(pw.charging, 0);
    KB_CHECK_EQ(pw.usb_power, 1);
    uint8_t one = 1;
    KB_CHECK_EQ(call(KB_PROTO_CMD_GET_POWER, &one, 1), KB_PROTO_BAD_LENGTH);

    uint8_t reset = 0;
    KB_CHECK_EQ(call(KB_PROTO_CMD_GET_TIMING, &reset, 1), KB_PROTO_OK);
    struct kb_proto_get_timing_resp t;
    KB_CHECK_EQ(kb_proto_get_timing_resp_decode(payload(), payload_len(), &t), 0);
    KB_CHECK_EQ(t.scan_period_us, 1000);
    KB_CHECK_EQ(t.scans, 1234u);
    KB_CHECK_EQ(fx.timing_resets, 0);
    reset = 1;
    KB_CHECK_EQ(call(KB_PROTO_CMD_GET_TIMING, &reset, 1), KB_PROTO_OK);
    kb_proto_get_timing_resp_decode(payload(), payload_len(), &t);
    KB_CHECK_EQ(t.scans, 1234u); /* read, then zeroed */
    KB_CHECK_EQ(fx.scans, 0u);
    KB_CHECK_EQ(fx.timing_resets, 1);
    reset = 2;
    KB_CHECK_EQ(call(KB_PROTO_CMD_GET_TIMING, &reset, 1), KB_PROTO_BAD_VALUE);
    KB_CHECK_EQ(call(KB_PROTO_CMD_GET_TIMING, NULL, 0), KB_PROTO_BAD_LENGTH);
    KB_CHECK_EQ(fx.timing_resets, 1);

    static const struct kb_protocol_ops none = {0};
    fx_proto.ops = &none;
    KB_CHECK_EQ(call(KB_PROTO_CMD_GET_POWER, NULL, 0), KB_PROTO_NOT_SUPPORTED);
    KB_CHECK_EQ(call(KB_PROTO_CMD_GET_TIMING, &reset, 1), KB_PROTO_NOT_SUPPORTED);
}

static void test_device_control(void)
{
    fx_init();
    uint8_t mode = 1;
    KB_CHECK_EQ(call(KB_PROTO_CMD_REBOOT, &mode, 1), KB_PROTO_OK);
    KB_CHECK_EQ(fx.reboots, 1);
    KB_CHECK(fx.reboot_bootloader);
    mode = 2;
    KB_CHECK_EQ(call(KB_PROTO_CMD_REBOOT, &mode, 1), KB_PROTO_BAD_VALUE);
    KB_CHECK_EQ(fx.reboots, 1);

    uint8_t secs = 5;
    KB_CHECK_EQ(call(KB_PROTO_CMD_IDENTIFY, &secs, 1), KB_PROTO_OK);
    KB_CHECK_EQ(fx.identify_seconds, 5);
    secs = 0;
    KB_CHECK_EQ(call(KB_PROTO_CMD_IDENTIFY, &secs, 1), KB_PROTO_BAD_VALUE);
    secs = 31;
    KB_CHECK_EQ(call(KB_PROTO_CMD_IDENTIFY, &secs, 1), KB_PROTO_BAD_VALUE);

    /* Without ops, the commands say so instead of crashing. */
    static const struct kb_protocol_ops none = {0};
    fx_proto.ops = &none;
    secs = 5;
    KB_CHECK_EQ(call(KB_PROTO_CMD_IDENTIFY, &secs, 1), KB_PROTO_NOT_SUPPORTED);
    KB_CHECK_EQ(call(KB_PROTO_CMD_SAVE, NULL, 0), KB_PROTO_NOT_SUPPORTED);
    mode = 0;
    KB_CHECK_EQ(call(KB_PROTO_CMD_REBOOT, &mode, 1), KB_PROTO_NOT_SUPPORTED);
}

static void test_codec_round_trip(void)
{
    /* Every generated encoder and decoder agree, including text padding. */
    struct kb_proto_handshake_resp h = {0}, h2;
    h.protocol_version = 1;
    h.capabilities = 0x89ABCDEFu;
    h.macro_buffer_size = 0x1234;
    memcpy(h.model, "0123456789abcdef", 16); /* exactly 16: no terminator on the wire */
    uint8_t buf[KB_PROTO_MAX_PAYLOAD];
    size_t n = kb_proto_handshake_resp_encode(&h, buf);
    KB_CHECK_EQ(n, KB_PROTO_HANDSHAKE_RESP_SIZE);
    KB_CHECK_EQ(kb_proto_handshake_resp_decode(buf, n, &h2), 0);
    KB_CHECK_EQ(h2.capabilities, 0x89ABCDEFu);
    KB_CHECK_EQ(h2.macro_buffer_size, 0x1234);
    KB_CHECK(strcmp(h2.model, "0123456789abcdef") == 0);
    KB_CHECK_EQ(kb_proto_handshake_resp_decode(buf, n - 1, &h2), -1);

    struct kb_proto_set_keymap_chunk_req c = {.offset = 300, .keycodes_count = 28};
    for (int i = 0; i < 28; i++) {
        c.keycodes[i] = (uint16_t)(0x100 * i + 7);
    }
    n = kb_proto_set_keymap_chunk_req_encode(&c, buf);
    KB_CHECK_EQ(n, 58);
    struct kb_proto_set_keymap_chunk_req c2;
    KB_CHECK_EQ(kb_proto_set_keymap_chunk_req_decode(buf, n, &c2), 0);
    KB_CHECK_EQ(c2.offset, 300);
    KB_CHECK_EQ(c2.keycodes_count, 28);
    KB_CHECK_EQ(c2.keycodes[27], 0x100 * 27 + 7);
    /* 29 keycodes don't fit the message. */
    KB_CHECK_EQ(kb_proto_set_keymap_chunk_req_decode(buf, 60, &c2), -1);
}

int main(void)
{
    KB_RUN(test_handshake);
    KB_RUN(test_get_serial);
    KB_RUN(test_version_mismatch);
    KB_RUN(test_framing_errors);
    KB_RUN(test_get_and_set_key);
    KB_RUN(test_keymap_chunks);
    KB_RUN(test_save_revert_reset);
    KB_RUN(test_features);
    KB_RUN(test_macros);
    KB_RUN(test_settings);
    KB_RUN(test_indicators);
    KB_RUN(test_features_not_supported);
    KB_RUN(test_connection);
    KB_RUN(test_dongle);
    KB_RUN(test_power_and_timing);
    KB_RUN(test_device_control);
    KB_RUN(test_codec_round_trip);
    return KB_TEST_RESULT();
}
