TiamDesigns/Dachshund60F/firmware/core/tests/test_settings.c

#include "kb/debounce.h"
#include "kb/keycodes.h"
#include "kb/protocol_gen.h"
#include "kb/settings.h"
#include "kb_test.h"

#include <string.h>

#define L 2
#define R 2
#define C 3

static const kb_keycode_t defaults[L][R][C] = {
    {{KC_A, KC_B, MO(1)}, {KC_1, KC_2, KC_3}},
    {{KC_F1, _______, _______}, {_______, KC_VOLU, QK_BOOT}},
};

static kb_keycode_t keys[L * R * C];
static struct kb_keymap km;
static struct kb_settings st;

static const struct kb_settings default_settings = {
    .debounce_algo = KB_DEBOUNCE_EAGER_PRESS,
    .debounce_ms = 5,
    .tapping_term_ms = 200,
    .nkro = true,
    .sleep_timeout_min = 10,
    .indicator_brightness = 25,
    .name = "",
};

static void reset(void)
{
    kb_keymap_init(&km, keys, L, R, C, &defaults[0][0][0]);
    st = default_settings;
}

static void test_defaults_valid(void)
{
    KB_CHECK(kb_settings_valid(&default_settings));
    struct kb_settings s = default_settings;
    s.debounce_algo = KB_DEBOUNCE_ALGO_COUNT;
    KB_CHECK(!kb_settings_valid(&s));
    s = default_settings;
    s.tapping_term_ms = 10;
    KB_CHECK(!kb_settings_valid(&s));
    s = default_settings;
    s.indicator_brightness = 101;
    KB_CHECK(!kb_settings_valid(&s));
}

static void test_round_trip(void)
{
    reset();
    kb_keymap_set(&km, 0, 0, 0, KC_Z);
    kb_keymap_set(&km, 1, 1, 1, LSFT(KC_9));
    st.debounce_ms = 12;
    st.tapping_term_ms = 333;
    st.nkro = false;
    memcpy(st.name, "Oskar's board!!!", 16);

    uint8_t buf[256];
    size_t n = kb_settings_encode(&km, &st, buf, sizeof(buf));
    KB_CHECK_EQ(n, kb_settings_encoded_size(&km));
    KB_CHECK_EQ(kb_settings_encode(&km, &st, buf, n - 1), 0);

    reset();
    KB_CHECK_EQ(kb_settings_decode(KB_SETTINGS_SCHEMA, buf, n, &km, &st),
                KB_LOADED_KEYMAP | KB_LOADED_SETTINGS);
    KB_CHECK_EQ(kb_keymap_get(&km, 0, 0, 0), KC_Z);
    KB_CHECK_EQ(kb_keymap_get(&km, 1, 1, 1), LSFT(KC_9));
    KB_CHECK_EQ(kb_keymap_get(&km, 1, 1, 2), QK_BOOT);
    KB_CHECK_EQ(st.debounce_ms, 12);
    KB_CHECK_EQ(st.tapping_term_ms, 333);
    KB_CHECK(!st.nkro);
    KB_CHECK(strcmp(st.name, "Oskar's board!!!") == 0);
}
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
