TiamDesigns/Dachshund60F/(commit log)

2026-10-21 Phase 1: scaffold monorepo
    - Zephyr / NCS v3.4.1 (pinned in west.yml) keyboard firmware and dongle apps
    - Hardware-independent C core with standalone CMake/CTest host tests
    - TypeScript host-lib with node:test smoke test
    - protocol/, boards/, app/ placeholders
    - CI: core tests, host-lib tests, debug/release firmware builds
    - CLAUDE.md stack and commands, PROGRESS.md
2026-10-21 Add Dachshund60F board definition and pid.codes test IDs
    - boards/Dachshund60F/keyboard.json: layout generated from the KLE file,
    79 keys, split/full spacebar option, encoder right of Delete, 2 indicators
    - boards/Dachshund60F/board.json: proposed MDBT50Q-1MV2 pin map
    (6x15 COL2ROW matrix, encoder, gated SK6812MINI-E, charger status)
    - USB IDs: pid.codes test PIDs 1209:0001 (keyboard), 1209:0002 (dongle);
    in-house testing only
    - host-lib test validating every board folder (matrix, overlaps, pins)
2026-10-21 Add KiCad project and Konnect MCP server config
    - hardware/Dachshund60F/: empty KiCad 10 project for the PCB
    - .mcp.json: register the Konnect v0.13.0 KiCad MCP server
    - .gitignore: exclude KiCad lock files, backups and view state
    - CLAUDE.md, PROGRESS.md: document hardware/ and the MCP setup
    [Dachshund60F.kicad_pcb, Dachshund60F.kicad_sch]
2026-10-21 Add Dachshund60F schematic and PCB placement
    - Schematic (one A2 sheet, 195 parts, ERC clean): MDBT50Q-1MV2 with
    32.768 kHz crystal, SWD and reset; MCP73831 charger (500 mA), JST-PH
    battery and power switch into VDDH; TPS22917-switched SK6812MINI-E
    LEDs; EC11 encoder; 6x15 COL2ROW matrix with 80 positions; JST-SH
    connector for a USB-C daughterboard. Module pins match board.json.
    - PCB: all footprints placed from the KLE layout. Switches, stabilizers
    and encoder on the front, every SMD part on the back, and an 18 mm
    top strip for the module (antenna at the edge) and power parts.
    Not routed yet.
    - Kailh MX hot-swap everywhere except SW604, SW606 and SW615, which use
    solder-only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
    [Dachshund60F.kicad_pcb, Dachshund60F.kicad_sch]
2026-10-21 Route Dachshund60F PCB with horizontal encoder and compact layout
    - Encoder: replace the vertical EC11 with a Bourns PEC12R-4220F-S0024
    horizontal encoder (24 detents, push) so a wide roller turns like a
    mouse wheel. The body sits just past 16u; the board is about 12.7 mm
    wider.
    - Layout: drop the 18 mm top strip. The module (antenna at the right
    edge), charger, connectors, power switch, reset, SWD and LED load
    switch move to the empty column under the encoder. Outline is now
    318.5 x 121.1 mm.
    - Routing: Freerouting 2.5.0 autorouted all signal and power nets
    (0.25 mm signal, 0.3 mm power), with an antenna keep-out added to the
    DSN. GND pours on both layers, stitching vias, an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
    [Dachshund60F.kicad_pcb, Dachshund60F.kicad_sch]
2026-10-22 Rework MCU decoupling and re-route Dachshund60F PCB
    The decoupling caps sat in a column across the module's left-edge signal
    exit, which left the C5, C6 and C7 GND pads boxed in by tracks.
    - Move C2, C4-C7 into a row above the module's top-left corner, next to
    the VBUS, VSYS and +3V3 pins, GND pads facing the pour.
    - Move Y1, C8 and C9 left of the module's lower-left corner, level with
    XL1/XL2, so the crystal tracks no longer wall in U1 pad 15 (GND).
    - Give each of the 31 SMD GND pads its own fixed via, then re-route the
    whole board with Freerouting, leaving GND to the pours and vias.
    - Re-pour GND (solid to SMD pads), add stitching vias clear of parts.
    DRC: 0 errors, 0 unconnected.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
    [Dachshund60F.kicad_pcb]
2026-10-22 Add layer and battery indicator row; round board corners
    Move the layer LED from under Esc to a row of five reverse-mount
    SK6812MINI-E LEDs above the Right arrow: layer, then a 4-step battery
    gauge (D4-D7, each with a 100 nF cap). The chain is now U1 P0.06 ->
    D3 (layer) -> D4..D7 (battery) -> D2 (Caps Lock).
    - Re-route the whole board. The router now keeps clear of the LED
    cutouts and of a 0.35 mm band along the board edge, including the
    corners. DRC: 0 errors and 0 unconnected items, besides the 7 excluded
    spacebar items.
    - Board corner radius is 5 mm (was 1 mm).
    - Extend the 0.2 mm LED cutout edge rule to D2-D7.
    - board.json: 6 indicators. keyboard.json: indicator id is the chain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
    [Dachshund60F.kicad_pcb, Dachshund60F.kicad_sch]
2026-10-22 Phase 2 (firmware): Dachshund60F board, USB boot keyboard, LED bring-up, UF2 reboot
    - Zephyr HWMv2 board in boards/Dachshund60F: devicetree from board.json,
    Adafruit UF2 flash layout, UF2 output, REG0 in LDO mode, REGOUT0 set to
    3.3 V at first boot, P0.18 as nRESET
    - USB device_next boot keyboard on 1209:0001 with per-board serial number
    and bcdDevice from firmware/VERSION
    - SK6812 chain bring-up: enable the load switch, walk R/G/B along the chain
    - Hold Esc for 3 s to reboot into the UF2 bootloader (GPREGRET 0x57)
    - Core: kb_version_bcd_device and kb_hold with host tests
    - host-lib: check devicetree pins and Kconfig USB IDs against board.json
    - CI builds firmware for dachshund60f/nrf5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
    [bootloader.c, bootloader.h, hold.c]
2026-10-22 Use the label property for the HID keyboard interface name
    zephyr,hid-device in NCS v3.4.1 names the interface string with label;
    interface-name is not part of the binding.
2026-10-22 Add display header J4 to Dachshund60F
    An 8-pin 2.54 mm through-hole header on the front at y 112.5 mm, between
    the reset button and the LED load switch, for a case-mounted e-ink or
    OLED display. Pinout in Waveshare e-Paper module order: +3V3, GND,
    DIN (P0.21), CLK (P0.19), CS (P0.20), DC (P0.23), RST (P0.22),
    BUSY (P0.24); an I2C OLED uses CLK/DIN as SCL/SDA. Pin names are on the
    front silkscreen. Power is +3V3 straight from REGOUT0.
    - Re-route the board. DRC: 0 errors and 0 unconnected items, besides the
    7 excluded spacebar items. Nothing is in the antenna keep-out.
    - board.json: new display section; the host-lib pin test covers it.
    - Hardware provision only: SPEC.md still lists the disp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
    [Dachshund60F.kicad_pcb, Dachshund60F.kicad_sch]
2026-10-22 Add a configurable status screen for OLED or e-paper on J4
    - Board: J4 as a GPIO nexus (display_header, indexed by J4 pin), plus
    disabled display_i2c (TWIM0) and display_spi (SPIM2) with pinctrl from
    board.json
    - firmware/displays: one overlay per panel (SSD1306 128x32 and 128x64,
    SH1106 128x64, Waveshare 2.13" e-Paper V4), selected with
    EXTRA_DTC_OVERLAY_FILE; CONFIG_KB_SCREEN turns on from the chosen display
    - Core: kb/screen.h layout model (widgets on a character grid, layer
    names, validation) with host tests
    - Firmware: status_screen renders the layout through the character
    framebuffer, coalesces OLED updates and rate-limits e-paper refreshes;
    lock state and USB connection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
2026-10-22 Start Doghouse, the configurator GUI, against mock boards
    - host-lib: typed Board/BoardManager API (connection kind, battery,
    keymap and encoders, settings, save/revert, events, error codes),
    keycode catalog, Dachshund60F default keymap, validating MockBoard and
    MockBoardManager with battery simulation; tests for all of it
    - app/: Svelte 5 + TypeScript + Vite. Pack sidebar with connection and
    battery per board, keymap editor drawn from keyboard.json (layers,
    transparent fall-through, roller, LED row, palette, drag and drop,
    undo/redo), settings and about tabs, light and dark warm-earth themes,
    dog-themed details; Node tests for geometry, keymap and history
    - CI: app job runs sv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
2026-10-23 Add the Dachshund60F 2.4 GHz dongle PCB
    A new KiCad 10 project in hardware/Dachshund60F-Dongle: a 40 x 24 mm,
    2-layer desk puck that connects to the computer over USB-C. It sits next
    to the keyboard, away from USB 3 noise and the PC case.
    - Raytac MDBT50Q-1MV2 (same module as the keyboard), antenna flush with
    the right edge and a full-width copper keep-out on both layers.
    - HRO USB-C, USBLC6-2SC6 ESD clamp, 750 mA PTC, 5.1k Rd on CC1/CC2.
    VBUS feeds VBUS and VDDH; REGOUT0 is +3V3; no 32 kHz crystal.
    - PAIR (P1.06), RESET (P0.18), RGB status LED (P0.08/P1.09/P0.12,
    active low) and an SWD header in the keyboard's pin order. Button and
    LED pins match Nordic's PCA10059.
    - D+/D- hand-rou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
    [Dachshund60F-Dongle.kicad_pcb, Dachshund60F-Dongle.kicad_sch]
2026-10-23 Add the Dachshund60F USB-C daughterboard PCB
    A new KiCad 10 project in hardware/Dachshund60F-USB: a 42 x 9 mm,
    2-layer board that carries the USB-C port and connects to mainboard J1
    over a 1:1 JST-SH 4-pin cable.
    - Mounting: two 3.2 mm plated holes 33 mm apart (uDB S-series screw
    pattern) for M3, or M2 with a washer.
    - J2 pinout 1 VBUS, 2 D-, 3 D+, 4 GND matches mainboard J1 and the
    Unified Daughterboard spec.
    - USBLC6-2SC6 ESD clamp, 750 mA PTC on VBUS, 5.1k Rd on CC1/CC2.
    Shell and screw holes are SHIELD, tied to GND through a ferrite bead.
    - Routed with Freerouting, GND pours on both layers. ERC 0, DRC 0
    errors, 0 unconnected, 0 parity issues; 2 silkscreen-edge warnings
    from th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
    [Dachshund60F-USB.kicad_pcb, Dachshund60F-USB.kicad_sch]
2026-10-23 Add the FR4 gasket plate; give the LED cutouts more clearance
    Plate (hardware/Dachshund60F-Plate): generated from the mainboard by
    gen_plate.py, run with KiCad's Python. 1.6 mm FR4 with cutouts for 80
    switches and 12 Cherry stabilizers (both spacebar layouts, overlaps
    merged), an encoder notch, a J4 slot and windows over D3-D7. Eight
    2.8 x 6.5 mm tabs take silicone gasket socks. Exposed-copper accent
    rings follow every switch and stabilizer cutout, at least 0.4 mm from
    any routed edge. DRC: 0 violations.
    Mainboard: D2-D7 use a project copy of the SK6812MINI-E reverse-mount
    footprint with a plain 3.4 x 3.4 mm cutout instead of the corner
    reliefs. Pads are now 0.35 mm from the edge (was 0.247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
    [Dachshund60F-Plate.kicad_pcb, Dachshund60F.kicad_pcb, Dachshund60F.kicad_sch]
2026-10-23 Add 3D models and a STEP export for case design
    hardware/export_step.py writes STEP files of the mainboard, plate,
    mainboard+plate assembly, USB-C daughterboard and dongle to
    hardware/step/ (git-ignored). The mainboard, plate and assembly share
    the mainboard's centre as origin; the plate sits 5.0 mm above the PCB.
    - Mainboard footprints had lost their 3D model links; relink every
    footprint to its library models.
    - Vendor the perigoso keyswitch STEP models (CC-BY-SA-4.0) next to the
    vendored footprints; hot-swap footprints also show the switch body.
    - hardware/3dmodels/ holds dimensioned stand-ins for parts KiCad has no
    model for: the HRO USB-C receptacle, the horizontal PEC12R encoder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
    [Bourns_PEC12R_Horizontal_standin_body.step, Bourns_PEC12R_Horizontal_standin_bushing.step, Bourns_PEC12R_Horizontal_standin_shaft.step, Dachshund60F-Dongle.kicad_pcb, Dachshund60F-USB.kicad_pcb, Dachshund60F.kicad_pcb, JST_PH_S2B-PH-SM4-TB_standin.step, USB_C_Receptacle_HRO_TYPE-C-31-M-12.step]
2026-10-23 Widen plate stabilizer cutouts; generate USB-C and JST PH models
    Plate: stabilizer cutouts were Cherry's plate-mount size (6.75 x 12.3 mm),
    slightly smaller than the stabilizer housing at plate height. They are now
    7.0 x 14.7 mm (6.5 mm above to 8.2 mm below the key centre) for screw-in
    stabilizers of any brand; plate-mount stabilizers no longer clip in. The
    size is STAB_CUTOUT_* in gen_plate.py. DRC: 0 violations.
    3D models: hardware/3dmodels/gen_models.py (FreeCAD 1.1) generates
    coloured models of the HRO TYPE-C-31-M-12 receptacle and the JST PH
    S2B-PH-SM4-TB, each in its footprint's frame. The old USB-C stand-in sat
    7.3 mm behind its footprint on the daughterboard and the dongle; both
    fo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
    [Dachshund60F-Dongle.kicad_pcb, Dachshund60F-Plate.kicad_pcb, Dachshund60F-USB.kicad_pcb, JST_PH_S2B-PH-SM4-TB_standin.step, USB_C_Receptacle_HRO_TYPE-C-31-M-12.step]
2026-10-23 Commit the generated STEP exports
    hardware/step/ is no longer git-ignored, so the STEP files for case design
    reach every device. They are regenerated by python hardware/export_step.py;
    commit a fresh export when you want a snapshot (about 55 MB per export).
    [Dachshund60F-Assembly.step, Dachshund60F-Dongle.step, Dachshund60F-Plate.step, Dachshund60F-USB.step, Dachshund60F.step]
2026-10-23 PROGRESS: confirm PEC12R-4220F-S0024 is the horizontal encoder
    Bourns' ordering table: 2 = vertical mount, 3/4 = horizontal mount.
    The known-bug note suggested PEC12R-2217F-S0024, which is the vertical part.
    Claude-Session: https://claude.ai/code/session_01GDinCSZ9cwwF9dNdQbw1V4
2026-10-23 Add the Dachshund60F UF2 bootloader board definition
    Board files for the Adafruit nRF52 bootloader in boards/Dachshund60F/bootloader/,
    plus build.sh, which builds it at a pinned upstream commit. The output is one
    hex (MBR + S140 6.1.1 + bootloader) for the first SWD flash, and a UF2 for
    updates later.
    - DFU key is Esc: board_init2() drives col 0, and the bootloader reads row 0
    - Status on the SK6812 chain behind the LED load switch; REGOUT0 set to 3.3 V
    - USB 1209:0003 (pid.codes test PID), recorded in board.json
    - code_partition ends at 0xEA000, where the bootloader's UF2 writes stop
    - host-lib test checks board.h and the flash layout against board.json
    - CI job builds the bootloader and u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
2026-10-23 Phase 3: matrix scanning, debounce, keycode model and keymap
    Core (host-tested, no hardware or transport dependencies):
    - kb/keycodes.h: 16-bit keycode space with QMK-style names matching
    Doghouse's ids, and validation of every keycode.
    - kb/keymap.h: (layer, row, col) lookup with transparent and no-op keys,
    bounds-checked get/set.
    - kb/debounce.h: five selectable algorithms with a configurable time.
    - kb/engine.h: layers (MO, TG, TO, DF, OSL), modifiers, one-shot mods,
    layer-tap and mod-tap with a tapping term, consumer/system keys and
    boot/NKRO HID state.
    Firmware: 1 kHz COL2ROW scan thread, the compiled-in 4-layer default
    keymap, QK_BOOT and QK_RBT, hold-Esc recovery on the debou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
2026-10-23 Add the bring-up and test plan for all three PCBs (#9)
    docs/bringup-test-plan.md covers the mainboard, USB-C daughterboard and
    dongle: unpowered checks, first power and rails, the charger, flashing over
    SWD then UF2, functional tests, and measurements (current and battery life,
    scan rate and debounce, USB polling and latency, radio, LEDs, encoder,
    display, thermal), plus the firmware each test still needs.
    PROGRESS.md links it and records the mainboard power-path question.
    Claude-Session: https://claude.ai/code/session_01M1qfv5vq4vmCJasArQbkgz
2026-10-23 Add a USB power path to the mainboard, licences and a task list
    The mainboard ran only from the battery through the slide switch, so it
    was off on USB with the switch off and browned out with no battery.
    - Schematic and PCB: Microchip's MCP73831 load-sharing circuit. SW1 now
    feeds VBAT_SW; Q1 (AO3401A) connects it to VSYS only while VBUS is
    absent, R3 (100k) pulls the gate down, and D8 (B5819W) feeds VSYS from
    VBUS. Placed on the back between J2, J3 and SW1 and hand-routed; ERC
    and DRC show no new errors.
    - Licence: MIT for code (LICENSE), CERN-OHL-P-2.0 for hardware
    (hardware/LICENSE).
    - SCHEDULED_TASKS.md: open tasks to reference in later prompts.
    - Bring-up plan, board README a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
    [Dachshund60F.kicad_pcb, Dachshund60F.kicad_sch]
2026-10-23 Buffer the LED data line for the higher USB-side LED_VDD
    With the power path, LED_VDD is about 4.7 V on USB, which puts the
    SK6812 input-high threshold (0.7 x VDD) at the 3.3 V data level. U4, an
    SN74LV1T34 with TTL-level inputs powered from LED_VDD, now drives D3's
    DIN (net LED_DIN_BUF), decoupled by C19. Placed on the back above D3.
    ERC and DRC show no new errors.
    Claude-Session: https://claude.ai/code/session_01D9WgQVzjyM3BLJSpari9iy
    [Dachshund60F.kicad_pcb, Dachshund60F.kicad_sch]
2026-10-23 Record the LED buffer decision
    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
2026-10-23 Move the D8 and C19 reference labels clear of their parts
    D8's label sat under the diode body and C19's crowded C14's. DRC is
    unchanged; the rest of the diff is KiCad re-ordering segments on save.
    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
    [Dachshund60F.kicad_pcb]
2026-10-23 Add test pads for probing the mainboard
    Nine 1.5 mm SMD test pads on the back, each on its net's existing
    track with the net name on the silkscreen: VBUS, VBAT, VBAT_SW, VSYS,
    +3V3, LED_VDD, CHG_STAT and two GND. Excluded from the BOM. DRC and ERC
    show no new errors or warnings. The bring-up plan lists where each is.
    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
    [Dachshund60F.kicad_pcb, Dachshund60F.kicad_sch]
2026-10-23 SCHEDULED_TASKS: drop the finished KiCad review of the power path
    The review in KiCad was done on 2026-10-23 before PR #10 merged.
    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
2026-10-23 hardware: take KiCad 10.0.6's re-save of the project file
    KiCad drops the unused td_enabled flags from the teardrop parameter sets and writes empty net_colors/netclass_assignments as null. DRC and ERC are unchanged.
    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
2026-10-23 hardware/step: re-export STEP models after power path, LED buffer and test pads
    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
    [Dachshund60F-Assembly.step, Dachshund60F-Dongle.step, Dachshund60F-Plate.step, Dachshund60F-USB.step, Dachshund60F.step]
2026-10-23 Phase 4: NKRO, media keys, lock LEDs, suspend and remote wakeup
    Core (host-tested): kb/hid.h has the report descriptors for a boot
    keyboard interface and an extra interface (NKRO, consumer and system
    control with report IDs), the report packers, and a reporter that sends
    only changed reports on one key path, falls back to 6KRO when the host
    asks for boot protocol, and releases on the old path before pressing on
    the new one. kb/indicators.h renders the LED colours from lock state,
    layer, battery and suspend. New NK_TOGG keycode, on Fn+N by default.
    Firmware: a second HID interface, a queue per interface that resyncs
    from the current state on overflow, remote wakeup with indicators dark
    while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
2026-10-23 Phase 5: config protocol v1 over a vendor HID interface
    protocol/protocol.yaml defines the frame, status codes, capability bits
    and the v1 commands (handshake, reboot, identify, get_serial, key and
    keymap-chunk access, save/revert/factory reset). protocol/gen/gen.py
    generates the C and TypeScript bindings; CI checks they are current.
    The core handler validates every length, index and keycode and is
    unit-tested, randomly fuzzed in ctest and run under libFuzzer in a new CI
    job. The firmware adds a 64-byte vendor HID interface and a config
    thread; host-lib gains frame encode/decode helpers.
    Claude-Session: https://claude.ai/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
    [config.c, config.h, fuzz_protocol.h, hid.c, hid.h]
2026-10-23 Phase 6: persistence for the keymap and settings
    kb/store.h is a wear-levelled, CRC-checked log of whole snapshots that
    survives power loss mid-save; kb/settings.h encodes the keymap and global
    settings as versioned, tagged sections with range checks on load. Both
    are host-tested against a simulated flash, including a power cut at every
    write of a save.
    The firmware keeps the store on storage_partition, loads it at boot, and
    implements the protocol's save, revert and factory_reset.
    Claude-Session: https://claude.ai/code/session_015HAJe8Q5T7hsgrDAE7PGm9
    [config.c, indicators.c, indicators.h, keyboard.c, keyboard.h, settings.c, settings.h, sim_flash.h]
2026-10-23 Phase 7: host library over the config protocol
    HidBoard implements the typed Board API on any Transport: handshake and
    version negotiation (a board on another version is listed but refuses
    every call), chunked keymap access, save/revert/factory reset, identify
    and reboot. ProtocolClient serialises requests, matches responses by
    command and sequence, and retries timeouts (never reboot).
    WebHidBoardManager and NodeHidBoardManager (separate ./node entry, node-hid
    loaded at run time) find boards and follow hotplug. keycode-codec maps
    keycode ids to the firmware's numbers, generated from keycodes.h.
    kb_host_device runs the core protocol handler and store on the host; the
    same Board tests run ag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
    [kb_host_device.c]
2026-10-23 Phase 8: Doghouse on real boards over WebHID
    Doghouse lists real boards from WebHidBoardManager ("Connect a board…" the
    first time, hotplug after that) next to demo boards (?demo, or a browser
    without WebHID) through host-lib's new CombinedBoardManager. It follows
    the firmware's capabilities, shows boards on another protocol version
    with an update message and never writes to them, and can restart a board
    into its UF2 bootloader.
    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
2026-10-24 Phase 9a: advanced keys in the core engine
    kb/features.h adds fixed-size tables the engine runs from: combos, tap
    dance, key overrides, Leader sequences, per-key tap-hold rules, encoder
    actions per layer, Caps Word, Auto Shift and mouse-key settings, and a
    macro buffer. kb_features_valid() checks every index and keycode.
    The engine runs key events through a combo stage, then the tap-hold
    stage, then the keymap; fired combos and encoder detents are events of a
    virtual key row. New: permissive hold, hold on other key press, quick
    tap, retro tapping, Caps Word, Auto Shift, Repeat, Leader, stored and
    dynamic macros, mouse keys with acceleration, and kb_engine_encoder().
    New keycodes M(n), TD(n)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
    [engine.c, engine.h, features.c, features.h, keycodes.c, keycodes.h, test_engine.c, test_features.c]
2026-10-24 Phase 9b: advanced keys in the firmware, protocol and host library
    Protocol (version 1, commands added): get_feature and set_feature read
    and write one entry of the advanced-key tables, whose layouts are in
    protocol.yaml's feature_tables; get_macro_chunk, set_macro_chunk and
    apply_macros edit the macro buffer. Every write is checked against all
    the tables and undone on an error. The generator supports u8[] fields
    and emits the table constants.
    Settings gain features and macros sections (no schema bump); loading
    checks the whole set and reads entries field by field across versions.
    kb_engine_set_features() releases fired combos and stops macros, so the
    tables can change while keys are down.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
    [config.c, default_keymap.c, default_keymap.h, encoder.c, encoder.h, encoder_input.c, encoder_input.h, engine.c]
2026-10-24 Phase 9c: Doghouse editors for advanced keys and macros
    Doghouse gets Advanced and Macros tabs for boards with those capabilities:
    the options, combos, tap dances, key overrides, Leader sequences and
    tap-hold rules, and macros as steps with the buffer use shown. host-lib's
    advanced.ts holds the limits and the firmware's checks; the mock board
    implements the advanced-key and macro methods, and their tests run
    against both the mock and the host-built firmware.
    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
2026-10-24 Add a README and a design decisions page
    The repo is now public. The README sets out the project's goals, the
    board, phase status, how to try it, and the licences with a disclaimer.
    docs/design-decisions.md records the decisions made along the way and
    the topics the project has covered.
    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
2026-10-24 Phase 10: indicator colours and global settings
    Protocol v1 gains get/set_settings, get/set_indicators and
    get/set_layer_colour (commands only, no version bump). The firmware
    applies changes live, saves the colours in a new settings section, and
    reports the settings and indicators capabilities. HidBoard and the mock
    implement settings and colours with shared checks, and Doghouse's
    Settings tab now works on real boards, with a debounce style picker and
    light colours.
    Also records Tiam's choice to stay on the pid.codes test PIDs, with a
    README warning for anyone rebuilding the project.
    Claude-Session: https://claude.ai/code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
2026-10-24 Phase 11: in-app firmware updates
    Every firmware image now carries an info block (version, model,
    protocol), so Doghouse can check a .uf2 before flashing it. host-lib
    gains a UF2 checker that refuses other chips and anything outside the
    application flash, a whole-board backup and a restore that writes only
    what differs, and mock boards that reboot and take simulated firmware.
    Doghouse's About tab runs the update: check the file, back up, reboot
    into UF2, write the file to the board's drive (File System Access API,
    with the drive's Board-ID checked), wait for the board, verify its
    version and restore anything the update lost. Backups can also be
    restored from a file, and demo boards can run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
    [config.c, fw_info.c, test_version.c, version.h]
2026-10-24 Phase 12: Bluetooth LE
    HID over GATT behind the same report layer as USB, with three host
    profiles (one identity and bond each), bonding management, the Battery
    and Device Information services, and automatic USB/Bluetooth output
    selection. The config protocol runs over vendor reports on the HID
    service (report ID 6), so Doghouse works wirelessly.
    - core: kb/output.h (output selection), the Bluetooth report map and
    released reports in kb/hid.h, and the get_connection, set_output,
    select_profile and clear_profile commands, with tests
    - firmware: kb_ble.c, output.c, USB that follows VBUS, a bt_settings
    NVS partition at 0xEA000, and OUT_USB, OUT_BLE, BT_SEL and BT_CLR
    - host-lib: Bluetoot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
2026-10-24 Phase 13: power management, battery gauge and lower input delay
    - Scan at once when a key goes down (rows on a level interrupt between
    scans), instead of at the next 1 ms tick.
    - Power states in the core (kb/power.h): idle after 500 ms quiet (scan
    timer stopped, wake on matrix or encoder interrupt); on battery, lights
    out after 60 s, advertising paused after 5 min, deep sleep (System OFF,
    wake on a key) after the sleep timeout. QK_SLEEP sleeps on demand.
    - Battery gauge (kb/battery.h): VDDH/5 on the SAADC, read only on
    battery, CHG_STAT for charging; fed to the Battery Service, indicators
    and screen.
    - Protocol: get_power and get_timing (non-breaking, version 1), with the
    batte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
2026-10-24 Phase 14: 2.4 GHz dongle
    The keyboard can now send keys to its own USB receiver over Nordic's
    Enhanced ShockBurst, alongside USB and Bluetooth.
    - Core: the link packet format (kb/link.h) with host tests; the dongle
    as a third output (preferred, else USB, dongle, Bluetooth); RF_PAIR.
    - Keyboard: src/kb_esb.c, ESB on MPSL timeslots next to Bluetooth,
    pairing kept in Zephyr settings, polling that follows power states.
    - Dongle: USB HID relay reusing kb_usb.c, config passthrough, pairing
    button and RGB LED, keys released when the keyboard goes quiet.
    - Protocol (still v1): get_dongle, pair_dongle, the dongle capability,
    set_output 3 and the unreachable status.
    - host-lib: dongle PID det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
2026-10-24 Add the Pup: keyboard firmware on an nRF52840 Dongle
    A one-key test board (boards/Pup/) so Bluetooth and the 2.4 GHz dongle
    can be tried on Nordic's PCA10059 before the Dachshund60F PCB exists.
    It builds on Zephyr's nrf52840dongle/nrf52840 board: the app's board
    overlay brings app.overlay and the Pup's pins and flash layout, and its
    .conf sets the names, Nordic's bootloader and a 10 s recovery hold.
    Firmware: direct-wired keys when a board has no column pins, one RGB
    LED on GPIOs as the Caps Lock indicator, the bootloader's GPREGRET
    value as a Kconfig option, and a per-board default keymap picked by
    KB_MODEL. The Dachshund60F build is unchanged.
    host-lib and Doghouse know the Pup (default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
2026-10-24 Phase 15: Doghouse desktop app with auto-update
    Tauri 2 shell in app/src-tauri for Windows, macOS and Linux. hidapi
    replaces WebHID in the app (the macOS and Linux WebViews have none):
    the app lists, opens and writes HID devices and streams reports over a
    channel, and host-lib's TauriHidBoardManager runs the node-hid manager
    on that bridge. Firmware updates find the board's UF2 drive and write
    it without a picker. The updater checks GitHub Releases at start-up
    when the build has the public key, and the sidebar offers to install.
    A release workflow builds the installers onto a draft release, signing
    the update files with a repo secret; CI gains a Rust job (fmt, clippy,
    tests). The .deb and .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
2026-10-26 Doghouse: leave demo mode, even legends, battery colour
    - Leave demo mode from the demo panel when it was opened with ?demo.
    - Key legends share one size and only shrink when they don't fit the
    key; shifted symbols match the base legend, with a gap between them.
    - Battery colour by charge: white when full, shading to yellow, red
    below 15%, on the board's battery LEDs and the bone gauges.
    Claude-Session: https://claude.ai/code/session_01MUgMf9x2Aw75qFyULHfs1K
2026-10-26 Doghouse: presets, feature info, and a new dog
    Presets on the Settings tab: Everyday, Gaming, Careful typing and Battery
    saver, plus your own (saved from the board's current settings and kept in
    localStorage). Gaming is tuned for latency: eager debounce, NKRO, and
    tap-hold, tap dance, combos and Auto Shift switched off.
    For that, the firmware can switch tap-hold, tap dance and combos off as a
    whole (an off byte appended to the options entry, capability
    feature_switches); the tables are kept. Not a breaking change: host-lib
    reads and writes the old 14-byte entry on older firmware.
    An info button beside each feature says what it does, with its pros and
    cons. The dachshund gets a proper eye,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
2026-10-26 Doghouse 0.1.3: update checks, app settings and a UI pass
    Every release so far was built without the updater's public key, so no
    installed copy could look for updates. Now, when the updater can't help
    (no key in the build, or its check fails), Doghouse asks GitHub's
    releases API and offers "Download from GitHub". It checks at start-up and
    every six hours, and App settings has a Check for updates button that
    says what it found or why it couldn't check.
    App settings (sidebar) holds the theme and the Doghouse, host-lib and
    protocol versions; the sidebar shows the version too, and the About tab
    no longer shows a hard-coded 0.1.0.
    The battery is a real bone: round knobs at each end and a thick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
2026-10-26 Mainboard: lower the charge current to 300 mA (R1 = 3.3 kΩ)
    The 500 mA charge current plus the keyboard's own load through D8
    came to about 630 mA, over a 500 mA USB port's budget (project review
    finding H1). R1 sets I = 1000 V / R_PROG, so 3.3 kΩ gives about 300 mA.
    Value change only, in the schematic and the PCB; the bring-up plan's
    charger numbers follow.
    Claude-Session: https://claude.ai/code/session_01La3JB4NYHq7NgWrfFS2bsw
    [Dachshund60F.kicad_pcb, Dachshund60F.kicad_sch]
2026-10-26 Mainboard: antenna keep-out rule areas under U1
    The board's copy of RF_Module:Raytac_MDBT50Q had lost the library's two
    keep-out zones, so the GND pours ran under the antenna. Add them back as
    board-level rule areas, mapped through U1's placement (B.Cu, 90 deg):
    - "U1 antenna keep-out" on F.Cu and B.Cu, (333.0, 66.8)-(337.5, 79.2):
    the 12.4 mm band from Raytac's spec, extended 0.75 mm out to the board
    edge as the spec's RF layout page asks.
    - "U1 antenna keep-out (B.Cu)", (331.75, 73.7)-(332.95, 75.3): the
    1.6 x 1.2 mm area on the module's own copper layer.
    Both block tracks, vias, pads and copper pour. The footprints rule is off
    because U1's own courtyard overlaps them; pads stay bl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
    [Dachshund60F.kicad_pcb]
2026-10-26 PROGRESS: the antenna keep-out under U1
    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
2026-10-26 Firmware: resend after a failed USB submit; TO clears held layers; one-shot mods survive bare modifiers
    From the 2026-10-26 project review (H2, M4, M5):
    - kb_usb: a failed keyboard or extra report submit schedules a resync
    8 ms later, so a lost key release is sent again with the full state.
    - TO(n) also turns off held and one-shot layers, and forgets the keys
    holding them so their releases can't end a later hold.
    - A bare modifier no longer uses up pending one-shot modifiers.
    Tests for each in test_engine.
    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
    [engine.c, kb_usb.c, keycodes.h, test_engine.c]
2026-10-26 CI: retry apt installs that stall
    The bootloader and desktop-app jobs each hung once on 2026-10-26 in
    apt-get until the job timed out. Each attempt now has an 8-minute cap and
    apt's own network timeouts and retries, and a stalled attempt is retried
    up to three times.
    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
2026-10-26 Doghouse: one board change at a time; revert waits for its reload; undo moves only on success
    From the 2026-10-26 project review (H3, M1, M2):
    - BoardSession queues every read and change of the board (SerialQueue),
    and edits read their old value inside the queue, so overlapping edits
    record the right undo history.
    - Revert and factory reset read the board back before reporting done.
    - Undo and redo move the history only after the board takes the write.
    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
2026-10-26 Mainboard: align ST6 with ST4's holes, battery polarity and board name on the back; fab export script
    ST6's right holes sat 0.038 mm from the 6.25u stabilizer's, a near-overlap
    that drills a sliver. They now coincide exactly. The back silkscreen gets
    +/- at J2, the board name and revision, and JLC's order-number marker.
    hardware/export_fab.py zips Gerbers and drill files for every board.
    Claude-Session: https://claude.ai/code/session_01P5t8x38EvinT9rpFK5k2Rj
    [Dachshund60F.kicad_pcb]
2026-10-26 CI: switch to archive.ubuntu.com when the runner's apt mirror is slow
    The 8-minute cap from the last change killed installs that were slow
    rather than stalled (the Azure mirror managed about 60 kB/s on
    2026-10-26), so all three attempts ran out. The retry now lives in
    .github/scripts/apt-install.sh: attempts are capped at 12 minutes, keep
    what they downloaded, and after the first one switch to
    archive.ubuntu.com. The bootloader job's limit goes to 45 minutes to
    fit the retries.
    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
2026-10-26 JLCPCB assembly: LCSC and MPN fields on every assembled part, BOM and CPL export
    Every part JLC assembles on the mainboard, daughterboard and dongle now has
    an LCSC number checked on jlcpcb.com, including the Kailh hot-swap sockets.
    export_fab.py writes JLC-format BOM and CPL files and moves the sockets to the
    bottom layer at their own centre. F1 becomes BHFUSE BSMD1206-075-6V (same
    1206 / 750 mA rating as MF-NSMF075-2, which LCSC doesn't stock).
    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
    [Dachshund60F-Dongle.kicad_sch, Dachshund60F-USB.kicad_sch, Dachshund60F.kicad_sch]
2026-10-26 Docs: add the project review; bring-up plan never backfeeds a bench supply; review follow-ups as tasks
    - docs/project-review-2026-10-26.md, with a note on what was done about
    each finding.
    - Bring-up plan (review M7): take the bench supply off J2 before USB goes
    in; USB plus battery is tested with a protected cell or a sinking supply.
    - SCHEDULED_TASKS: antenna keep-out, fab check of the ST4/ST6 holes, USB
    edge cases, Doghouse session tests, KiCad checks in CI, display current.
    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
2026-10-26 Docs: the antenna keep-out is done, not a task
    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
2026-10-26 Docs: the ST4/ST6 holes are aligned now, so only the USB edge check stays a task
    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
2026-10-26 Mainboard: fill boxed-in pour pockets, regular stitching-via grid, logo
    - B.Cu/F.Cu pour pockets fully enclosed by tracks (SW305/D305, SW400,
    SW513 and ~25 more) were removed as unconnected islands; each one
    big enough now gets a GND via so it fills like its neighbours.
    - ~600 scattered GND stitching vias replaced by ~200 on a regular
    9.525 mm grid, placed only where both pours are clear; two vias tie
    the pour pieces around the MCU to the main pour. Clears the 35
    copper-to-edge warnings.
    - Back silkscreen logo "Doghouse Boards" / "Daschund60F Rev 1.0" as
    filled polygons (group "Doghouse Boards logo").
    Claude-Session: https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
    [Dachshund60F.kicad_pcb]
2026-10-27 Mainboard logo: spell it Dachshund60F
    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
    [Dachshund60F.kicad_pcb]
2026-10-27 Mainboard logo: "Doghouse Boards" in a bold rounded sans (Fredoka Bold)
    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
    [Dachshund60F.kicad_pcb]
2026-10-27 export_fab.py: Gerbers the way JLCPCB's KiCad guide asks
    JLC's quote page didn't detect the mainboard's size or layers. Drop the
    X2 and netlist attributes, the drill maps and the job file, write
    decimal Excellon, and leave out empty drill files (the plate).
    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
2026-10-27 Mainboard BOM: hot-swap sockets to HanElectricity CPG151101S11-2 (C49352235)
    JLC has no stock of the Kailh CPG151101S11 (C2803348). The -2's datasheet
    matches the Kailh socket and the footprint (6.35 x 2.54 mm hole spacing,
    3.0 mm holes, 2.55 x 2.5 mm pads, 14.5 x 5.89 x 1.85 mm body).
    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
    [Dachshund60F.kicad_sch]
2026-10-27 Use the MDBT50Q-P1MV2 module on the keyboard and dongle
    The -P1MV2 is the same Raytac nRF52840 module with a PCB trace antenna
    instead of a chip antenna: same 15.5 x 10.5 mm body, same 61 pads,
    antenna at the same end. Footprint and keep-outs are unchanged; only
    the Value, MPN and LCSC (C5119772) fields and the docs change. It costs
    about C$10.74 at JLC against C$25.71, for about 20 % less rated
    open-air range.
    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
    [Dachshund60F-Dongle.kicad_pcb, Dachshund60F-Dongle.kicad_sch, Dachshund60F.kicad_pcb, Dachshund60F.kicad_sch]
2026-10-27 Case: gasket-mount case at 7°, brass bone weight, gaskets, plate foam and assembly
    hardware/case/gen_case.py (CadQuery) builds the top and bottom case, the
    weight, the eight socks and the plate-PCB foam (as a DXF outline) from
    parameters and the plate's own Edge.Cuts, and an assembly STEP with the
    mainboard, plate and USB-C daughterboard placed from hardware/step/.
    render.py draws the previews in hardware/case/renders/. No PCB or plate
    file changes.
    Claude-Session: https://claude.ai/code/session_01NfZpEYBtnP3VfQ882F5vxf
    [Dachshund60F-Case-Assembly.step, Dachshund60F-Case-Bottom.step, Dachshund60F-Case-Top.step, Dachshund60F-Gaskets.step, Dachshund60F-Plate-Foam.dxf, Dachshund60F-Weight.step]
2026-10-28 Case: OLED hood with LED holes and roller slot, stepped floor, strip feet
    - Top case: a raised hood over the sidebar covers the encoder, holds a 1.3"
    SH1106 128x64 I2C OLED on four M2 bosses behind a bevelled window (in front
    of the radio's antenna), has a 3 mm hole and light tube over each of D3-D7,
    and steps down to bezel height around the roller so only the wheel shows.
    - Bottom case: no weight; the inside floor steps up per switch row to 3.5 mm
    under the PCB, except under the sidebar, battery tray and USB-C corner.
    - Socks get the round closed end from the sock drawing; two channels for
    10 x 3 mm self-adhesive rubber strip replace the round feet.
    - Assembly gains OLED and strip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
    [Dachshund60F-Case-Assembly.step, Dachshund60F-Case-Bottom.step, Dachshund60F-Case-Top.step, Dachshund60F-Gaskets.step, Dachshund60F-Plate-Foam.dxf, Dachshund60F-Weight.step]
2026-10-28 Don't track Python caches
    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
2026-10-28 Case: lower hood, 1.12" SH1107 screen, sealed LED channels, centred USB-C
    - Hood top at keycap-bottom height (6.6 mm above the plate) with a 1.5 mm
    roof; the encoder body gets its own cover right of the wheel.
    - Screen: Pimoroni 1.12" 128x128 SH1107 breakout in a locating frame,
    taped by its glass border; new oled-sh1107-128x128 overlay and CI build.
    The 1.3" SH1106 stays selectable (DISPLAY).
    - LEDs: one 4 mm channel each through a solid block, sealed to the plate
    with black foam (LED-Seal DXF), with a 4 mm diffuser disc under each hole.
    - Wheel 12.25 mm wide (was 8) in a wider slot.
    - USB-C daughterboard centred; back screws split around it.
    - Back engraving removed.
    Co-Authored-B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
    [Dachshund60F-Case-Assembly.step, Dachshund60F-Case-Bottom.step, Dachshund60F-Case-Top.step, Dachshund60F-Gaskets.step, Dachshund60F-LED-Seal.dxf, Dachshund60F-Plate-Foam.dxf]
2026-10-28 SH1107 overlay: use the SSD1306 driver's SH1106 mode
    NCS v3.4.1's Zephyr has no sinowealth,sh1107 binding, so the screen node
    built no driver. The SH1107 takes the SH1106's commands with 16 pages.
    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
2026-10-28 Case and firmware: 2.13" e-paper strip in the hood
    The hood now holds a bare 2.13" e-paper panel (GDEY0213B74) on end, with
    an Adafruit eInk Breakout Friend taped to its back. The screen profiles in
    gen_case.py say whether the frame locates the glass or the module board.
    Firmware: a portrait overlay (120 x 248) through a small rotating display
    driver, dachshund,display-rotate, because the SSD16xx driver's rotation
    keeps reporting the landscape size. The rotation is kb_screen_rotate() in
    the core, with host tests. CI builds the new overlay.
    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
    [Dachshund60F-Case-Assembly.step, Dachshund60F-Case-Bottom.step, Dachshund60F-Case-Top.step, Dachshund60F-Gaskets.step, Dachshund60F-LED-Seal.dxf, Dachshund60F-Plate-Foam.dxf]
2026-10-28 Mainboard: flip the roller encoder so its shaft points right
    SW3 moves from (330.3, 47.025) at 0 deg to (314.3, 52.025) at 180 deg: the
    body sits just right of the last key column and the shaft points toward the
    board edge (tip at x ~331.3), so the wheel can be about 17 mm wide.
    Reroute ENC_A, ENC_B, COL14 and ENC_SW to the new pads (one new ENC_A via),
    dip ROW0 under the new lower mounting tab, drop the two GND stitching vias
    the new pins landed on, move the back-side name/version/JLC text off the
    pins and refill the zones. DRC is unchanged: 0 errors, 0 unconnected, 0
    parity issues.
    Regenerate the plate (the notch is unchanged) and refresh the STEP exports.
    The case still has the old roll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
    [Dachshund60F-Assembly.step, Dachshund60F-Dongle.step, Dachshund60F-Plate.kicad_pcb, Dachshund60F-Plate.step, Dachshund60F.kicad_pcb, Dachshund60F.step]
2026-10-28 Case: wider roller for the flipped encoder
    SW3 now points its shaft right, so the encoder's raised cover moves to
    the left end of the sidebar, next to the keys, with the bushing arch in
    its right wall. The roller is 15.55 mm wide (was 12.25), from just past
    the bushing to just inside the right wall, in line with the screen's
    right edge. New render 16-section-encoder.
    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
    [Dachshund60F-Case-Assembly.step, Dachshund60F-Case-Bottom.step, Dachshund60F-Case-Top.step, Dachshund60F-Gaskets.step, Dachshund60F-LED-Seal.dxf, Dachshund60F-Plate-Foam.dxf]
2026-10-28 SW3: 3D model from Bourns' PEC12R-2xxxF-S drawing
    Replace the roller encoder's hand-placed stand-in (body, bushing and shaft
    STEPs) with one model generated in gen_models.py from the datasheet:
    shaft axis 10.0 mm above the PCB top (the stand-in assumed 6.7), body
    12.5 x 13.4 mm centred on it and 6.0 mm deep on 3.3 mm feet, hub 7 x 5,
    6 mm shaft with the D-flat, 20 mm from the rear face to the tip. SW3's
    footprint uses it with no offset. Refresh the mainboard and assembly STEP.
    [Bourns_PEC12R-2x20F-S_standin.step, Bourns_PEC12R_Horizontal_standin_body.step, Bourns_PEC12R_Horizontal_standin_bushing.step, Bourns_PEC12R_Horizontal_standin_shaft.step, Dachshund60F-Assembly.step, Dachshund60F.kicad_pcb, Dachshund60F.step]
2026-10-28 SW3: PEC12R-2220F-S0024, the shaft-parallel part
    PEC12R-4220F-S0024 is Bourns' horizontal-mount part, whose shaft stands
    up from the board. The roller needs the vertical-mount (radial pin) part,
    which the footprint is drawn for. Tiam chose 24 detents: PEC12R-2220F-S0024
    (20 mm shaft, push switch, 24 pulses). Update the schematic value, MPN and
    LCSC number (C49673168), the PCB value and the docs.
    [Dachshund60F.kicad_pcb, Dachshund60F.kicad_sch]
2026-10-28 Case: one bezel height, encoder hump, polycarbonate end and switch cap
    The top case loses its stepped hood. The bezel is one height all round,
    level with a keycap's bottom edge (6.6 mm above the plate), with the key
    opening 1 mm outside the keycaps; over the sidebar it is a flat 1.5 mm
    roof holding the screen and the LED channels, so the screen frame is
    flush without moving the screen.
    With SW3's real axis height (10 mm above the PCB top) the roller grows
    to 19 mm across, and the encoder body sits under a hump coaxial with the
    wheel (radius 10.1 mm, 8.5 mm above the bezel).
    The bottom case is split for an aluminium build: the right end
    (x > 128 mm) is a separate polycarbonate part under th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
    [Dachshund60F-Case-Assembly.step, Dachshund60F-Case-Bottom.step, Dachshund60F-Case-End.step, Dachshund60F-Case-Top.step, Dachshund60F-Gaskets.step, Dachshund60F-LED-Seal.dxf, Dachshund60F-Plate-Foam.dxf, Dachshund60F-Switch-Cap.step]
2026-10-28 Case: Lemokey-style wheel with a push cap, out through the end wall
    SW3's switch is pressed along the shaft, and the wheel's end was hidden
    inside the right end wall. The roller now runs out through a notch in the
    end wall to 0.25 mm inside the end face (23.5 mm wide). After the Lemokey
    L1's corner wheel it has a straight knurl (44 ribs), chamfered ends and an
    amber, slightly domed push cap set into its end (new part "Wheel cap").
    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
    [Dachshund60F-Case-Assembly.step, Dachshund60F-Case-Bottom.step, Dachshund60F-Case-End.step, Dachshund60F-Case-Top.step, Dachshund60F-Gaskets.step, Dachshund60F-LED-Seal.dxf, Dachshund60F-Plate-Foam.dxf, Dachshund60F-Switch-Cap.step]
2026-10-28 SW3: the 30 mm shaft, PEC12R-2230F-S0024
    Tiam chose the 30 mm shaft so the wheel that reaches out through the end
    wall sits on about 19 mm of shaft. Update the schematic value and MPN (LCSC
    has no listing, so the LCSC field is cleared), the PCB value and the docs.
    gen_models.py takes the shaft length as a parameter and builds the 30 mm
    model (tip at board x 340.8, 12 mm D-flat); SW3 uses it. Refresh the
    mainboard and assembly STEP.
    [Bourns_PEC12R-2x30F-S_standin.step, Dachshund60F-Assembly.step, Dachshund60F.kicad_pcb, Dachshund60F.kicad_sch, Dachshund60F.step]
2026-10-28 Case: continuous-curvature corners, curved wheel notch, polycarbonate side panel
    - Plan-view corners are superellipse quadrants (exponent 5, 11 mm along each
    edge) instead of 9 mm arcs, so the curvature is continuous where they meet
    the straight edges, as on Apple's products.
    - The notch round the wheel follows its curve, 0.5 mm away, below its axis.
    - The polycarbonate is now a panel in the middle of the right side only (the
    side wall and the floor inside it, round the power switch and next to and
    under the antenna), held by two screws in the end wall.
    - Docs follow the 30 mm shaft (19 mm bore in the wheel). New render
    20-right-side.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
    [Dachshund60F-Case-Assembly.step, Dachshund60F-Case-Bottom.step, Dachshund60F-Case-End.step, Dachshund60F-Case-Panel.step, Dachshund60F-Case-Top.step, Dachshund60F-Gaskets.step, Dachshund60F-LED-Seal.dxf, Dachshund60F-Plate-Foam.dxf]
2026-10-28 Case: bezel tongue beside the arrows, thumb scoop along the front
    The 0.5u gap in the bottom row between the right Ctrl and the left arrow
    now has a tongue of bezel, 1 mm from the keycaps. The front bezel's top
    falls away from the key opening to the outer edge (2.5 mm lower there),
    corner to corner, as a smooth mostly concave curve that keeps the
    opening's front edge at keycap-bottom height. New render 21-thumb-scoop.
    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
    [Dachshund60F-Case-Assembly.step, Dachshund60F-Case-Bottom.step, Dachshund60F-Case-Panel.step, Dachshund60F-Case-Top.step, Dachshund60F-Gaskets.step, Dachshund60F-LED-Seal.dxf, Dachshund60F-Plate-Foam.dxf, Dachshund60F-Switch-Cap.step]
2026-10-29 Case: Cherry-profile keycaps (keycaps.py, Dachshund60F-Keycaps.step)
    Generates a keycap on every key of keyboard.json's default layout, in the
    case's desk frame, from KeyV2's GMK-based Cherry numbers. Checked against
    the top case: no clashes, 0.99 mm minimum gap; no cap-to-cap overlaps.
    Claude-Session: https://claude.ai/code/session_01NfZpEYYiQkyLfEWR7mBUBy
    [Dachshund60F-Keycaps.step]
2026-10-29 Case: G2 roll, deeper scoop, CNC rules, tongue and groove, tighter radii, F-row bezel, SKUF feet (#56)
    Continuous-curvature 1.5 mm top roll, 3.5 mm thumb scoop with a 2.5 mm flat, CNC rules (inside radii, dog-bones, 1 mm walls, tapped M3), tongue and groove at the seam, tighter radii (6 mm plan corners, 1 mm opening corners, 0.3 mm chamfer), bezel in the F row's gaps, USB-C board raised 4.5 mm, eight SKUF feet in 1 mm pockets.
    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
    [Dachshund60F-Case-Assembly.step, Dachshund60F-Case-Bottom.step, Dachshund60F-Case-Panel.step, Dachshund60F-Case-Top.step, Dachshund60F-Gaskets.step, Dachshund60F-LED-Seal.dxf, Dachshund60F-Plate-Foam.dxf, Dachshund60F-Switch-Cap.step]
2026-10-29 Case: screws front and back, narrower ends, gasket seats, dowels, case BOM
    - Twelve M3 screws, six front and six back at an even 53.1 mm pitch, clear
    of the socks; none in the ends.
    - End bezels 9 -> 6.5 mm (case 331.5 mm long); wheel 21 mm wide, still
    0.25 mm inside the end face; wheel slot clearance 0.5 -> 0.3 mm.
    - Polycarbonate panel held by a 4 mm floor lap and the tongue, no screws.
    - Seam up 1 mm: socks sit in 1 mm seats in the bottom case.
    - Two 3 x 8 mm dowel pins at opposite corners, one hole slotted.
    - F-row posts stop at the bar (they ran under the number row's caps).
    - New hardware/case/BOM.md.
    Claude-Session: https://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
    [Dachshund60F-Case-Assembly.step, Dachshund60F-Case-Bottom.step, Dachshund60F-Case-Panel.step, Dachshund60F-Case-Top.step, Dachshund60F-Gaskets.step, Dachshund60F-LED-Seal.dxf, Dachshund60F-Plate-Foam.dxf, Dachshund60F-Switch-Cap.step]
2026-10-29 Case: carry the F-row bezel down as ribs to 1 mm above the plate
    The bar between the F row and the number row and the posts after Esc, F4,
    F8 and F12 were only the roof's 1.5 mm deep. They now run down on the same
    footprint to 1 mm above the plate: 1.1 mm to the plate, 2.2 mm to the
    switch housings, keycaps still 0.965 mm.
    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
    [Dachshund60F-Case-Assembly.step, Dachshund60F-Case-Bottom.step, Dachshund60F-Case-Panel.step, Dachshund60F-Case-Top.step, Dachshund60F-Gaskets.step, Dachshund60F-LED-Seal.dxf, Dachshund60F-Plate-Foam.dxf, Dachshund60F-Switch-Cap.step]
2026-10-29 Keycaps: GMK-style doubleshot legends
    Each cap gets a second-colour legend body 0.4 mm deep in its top, from
    keyboard.json's legends: one centred character on alphas and arrows, the
    shifted character over the base one on symbols, smaller words on mods.
    Inter stands in for GMK's typeface (--font overrides).
    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
    [Dachshund60F-Keycaps.step]
2026-10-29 Mainboard: move status LEDs right, wider gap after D3
    D3 310.0 -> 310.5, D4-D7 316.5/322/327.5/333 -> 318.5/324/329.5/335 (y 130.5),
    with their light cutouts and caps (C14-C18). The gap after the layer LED is
    8.0 mm (was 6.5) for the case's notch; the battery LEDs keep their 5.5 mm
    pitch. Reroute the data chain and LED supply, drop a stitching via that
    D5's pads now straddle, move D7's reference off the edge and refill.
    DRC: 0 errors, 0 unconnected, 0 parity issues; warnings unchanged.
    Regenerate the plate's LED windows, refresh the STEP exports and move the
    indicator positions in keyboard.json.
    [Dachshund60F-Assembly.step, Dachshund60F-Plate.kicad_pcb, Dachshund60F-Plate.step, Dachshund60F.kicad_pcb, Dachshund60F.step]
2026-10-29 Case: swooping scoop, centred screen and LEDs, printed light guide, 8 screws, 4 feet, engraved weight
    - Thumb scoop keeps falling to the front edge (Bezier 0,0,0,1/3,2/3,1), meeting
    the roll at about 29 degrees instead of levelling out.
    - Screen glass centred on the sidebar (slot into the end wall from the seam);
    LED holes follow the mainboard's new LED positions, with a score after D3.
    - The machined LED block is replaced by a printed light guide and five clear
    plugs; the screen frame is notched over J4.
    - 8 screws (x +-50.5, +-151.5), 4 SKUF feet (x +-101), dowels over the feet.
    - Brass weight (80 x 64 mm, stepped, about 285 g) flush in the bottom,
    engraved with a line-art dachshun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
    [Dachshund60F-Case-Assembly.step, Dachshund60F-Case-Bottom.step, Dachshund60F-Case-Panel.step, Dachshund60F-Case-Top.step, Dachshund60F-Gaskets.step, Dachshund60F-LED-Guide.step, Dachshund60F-LED-Plugs.step, Dachshund60F-LED-Seal.dxf]
2026-11-02 Mainboard Rev 1.1: encoder moves to its own module board
    SW3 (the PEC12R roller encoder) leaves the mainboard. J5, a 5-pin JST SH
    port on the back, takes its nets (COL14, ENC_A, GND, ENC_B, ENC_SW), so the
    pin map, firmware and Doghouse are unchanged; C10, C11 and D114 stay on the
    mainboard. New hardware/Dachshund60F-Encoder/ project carries the encoder
    (22.5 x 22 mm, two M2 holes, JST SH J1 on the bottom side).
    - Silk and logo say Rev 1.1; zones refilled; DRC 221 items (was 222), 0
    unconnected; ERC unchanged.
    - gen_plate.py no longer reads the encoder from the mainboard (fixed
    ENCODER_BOX with the old values), so the plate is unchanged.
    - export_fab.py and export_step.py include the mo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
    [Dachshund60F-Assembly.step, Dachshund60F-Encoder.kicad_pcb, Dachshund60F-Encoder.kicad_sch, Dachshund60F-Encoder.step, Dachshund60F-Plate.kicad_pcb, Dachshund60F.kicad_pcb, Dachshund60F.kicad_sch, Dachshund60F.step]
2026-11-02 Mainboard: cable slot for the encoder module
    6.0 x 2.5 mm slot (1 mm corner radius) centred at x 306.6, y 50.0, just left
    of J5, so the cable from the module above reaches J5 on the back. Moved
    1.6 mm right of the requested x 305 to clear SW113's mounting hole and
    silkscreen; J5's back silkscreen outline is removed because the slot would
    clip it. DRC 222 items (same count), 0 unconnected. STEP files refreshed.
    [Dachshund60F-Assembly.step, Dachshund60F.kicad_pcb, Dachshund60F.step]
2026-11-02 Plate: six forked gasket tabs, reliefs for the encoder module's posts
    Three forked tabs on each long edge, two prongs each (7 mm apart), so twelve
    silicone socks instead of eight, all seated in the case's top shell. Two
    5.2 mm reliefs in the plate for the encoder module's M2 posts. gen_plate.py
    only counts the outline's corner arcs now (the cable slot has its own).
    [Dachshund60F-Plate.kicad_pcb]
2026-11-02 Plate: refresh STEP exports, add battery and screen models, polycarbonate outline DXF
    All STEP files re-exported from the forked-tab plate with 3D models (none missing).
    New battery (803450 LiPo) and screen (GDEY0213B74 + driver board) STEP models to
    datasheet sizes. Plate outline DXF for a polycarbonate plate cut from the same outline.
    [Dachshund60F-Assembly.step, Dachshund60F-Battery.step, Dachshund60F-Dongle.step, Dachshund60F-Encoder.step, Dachshund60F-Plate-outline.dxf, Dachshund60F-Plate.step, Dachshund60F-Screen.step, Dachshund60F-USB.step]
2026-11-03 Mainboard: two clearance holes for the encoder module's screw heads
    4.2 mm NPTH holes at (307.2, 41.7) and (307.2, 58.3), as the case thread
    asked. The lower one sat on ROW0, COL7 and COL14, so those were rerouted
    (ROW0/COL7 over the top of the hole on the front, COL14 down its west
    side on the back; one GND stitching via removed). DRC 222 items (same
    count), 0 unconnected. gen_plate.py ignores the cable slot's arcs when it
    reads the corner radius; the plate is unchanged. STEP files refreshed.
    [Dachshund60F-Assembly.step, Dachshund60F.kicad_pcb, Dachshund60F.step]
2026-11-03 Docs: note the module screw-head holes and the rerouted nets
2026-11-03 Encoder module: PEC12R-2220F-S0024, 20 mm shaft
    SW1 changes from the 30 mm PEC12R-2230F-S0024 to the 20 mm
    PEC12R-2220F-S0024 (same body and footprint). Schematic value, MPN and
    LCSC, PCB value field, docs and the module STEP updated;
    gen_models.py now builds the 20 mm stand-in model (the 30 mm one is gone).
    Module DRC and ERC unchanged.
    [Bourns_PEC12R-2x20F-S_standin.step, Dachshund60F-Encoder.kicad_pcb, Dachshund60F-Encoder.kicad_sch, Dachshund60F-Encoder.step]
2026-11-03 Move the power switch to the USB daughterboard
    SW1 (C&K PCM12SMTR) leaves the mainboard and goes on the daughterboard's
    back edge. The cable between the boards goes from 4 to 6 pins: pin 5 is
    VBAT and pin 6 is VBAT_SW.
    - Daughterboard rev 1.1: 54 x 9 mm (12 mm added on the right), 6-pin J2,
    SW1 with its actuator out of the back edge, H2 moved to x 140.
    - Mainboard: SW1 removed, 6-pin J1, VBAT and VBAT_SW routed down the right
    edge to the old switch pads.
    - DRC: mainboard 218 items (was 222), daughterboard only SW1's silkscreen
    crossing the edge; 0 unconnected on both. ERC clean. STEP exports,
    bring-up plan and docs updated.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
    [Dachshund60F-USB.kicad_pcb, Dachshund60F-USB.kicad_sch, Dachshund60F-USB.step, Dachshund60F.kicad_pcb, Dachshund60F.kicad_sch]
2026-11-03 Rename the project to Dachshund70: firmware, app and docs
    Zephyr board dachshund70/nrf52840 in boards/Dachshund70/, USB, Bluetooth
    and UF2 names, the host-lib and Doghouse packages (@dachshund70/...), the
    docs and CI. Doghouse goes to 0.1.4 so it knows the renamed board. The
    hardware/ projects, STEP files and case scripts follow in a second change,
    once the encoder PCB and plate branches have merged.
    Claude-Session: https://claude.ai/code/session_01NfZpEbnGpfrPZmShRKiJs9
2026-11-03 Mainboard: corner notch, J5 and J1 moves, even LED spacing (#67)
    * Mainboard Rev 1.1: encoder moves to its own module board
    ENCODER_BOX with the old values), so the p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
    [Dachshund60F-Assembly.step, Dachshund60F-Plate.kicad_pcb, Dachshund60F-Plate.step, Dachshund60F.kicad_pcb, Dachshund60F.step]
2026-11-03 Rename the PCB projects to Dachshund70
    Mainboard, USB-C daughterboard, dongle and encoder module: folders, KiCad
    files, sheet instances, title blocks, the Dachshund70.pretty footprint
    library and its references, and the silkscreen labels. The mainboard's
    back logo polygons now read "Dachshund70 Rev 1.1" (URW Gothic Book "7"
    in place of "6", "F" removed, logo re-centred). export_fab, export_step
    and gen_plate follow the new paths; the plate project, STEP files and
    case outputs keep their names until the plate branch has merged.
    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
    [Dachshund70-Dongle.kicad_pcb, Dachshund70-Dongle.kicad_sch, Dachshund70-Encoder.kicad_pcb, Dachshund70-Encoder.kicad_sch, Dachshund70-USB.kicad_pcb, Dachshund70-USB.kicad_sch, Dachshund70.kicad_pcb, Dachshund70.kicad_sch]
2026-11-03 Plate: branched T gasket nubs, 2 mm web by Delete; 6.25u keycap set (#70)
    * Encoder STEP: 20 mm shaft model (PEC12R-2220F-S0024), from the encoder branch
    * Battery model: EEMB LP803450 52.0 x 34.5 x 8.3 mm; screen model: driver board stays on the J4 header
    * Case: keycap set with the 6.25u spacebar (keycaps.py --full)
    * Plate: branched gasket nubs (T-shaped, flexing arms), regenerated STEP and DXF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
    [Dachshund60F-Assembly.step, Dachshund60F-Battery.step, Dachshund60F-Keycaps-6.25u.step, Dachshund60F-Plate-outline.dxf, Dachshund60F-Plate.kicad_pcb, Dachshund60F-Plate.step, Dachshund60F-Screen.step]
2026-11-03 Rename the plate, STEP files and case outputs to Dachshund70
    Plate project (hardware/Dachshund70-Plate/), every STEP file in
    hardware/step/ and hardware/case/step/, the foam and LED seal DXFs, and
    the names in export_step, export_fab, gen_plate, gen_case, keycaps,
    assembly and the case docs. export_step's temporary old-name mapping is
    gone.
    Also points Doghouse's update check, the desktop releases link and the
    UF2 index link back at TiamDesigns/Dachshund60F: part 1 had moved them to
    a repo name that doesn't exist until Tiam renames the repo.
    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
    [Dachshund70-Assembly.step, Dachshund70-Battery.step, Dachshund70-Case-Assembly.step, Dachshund70-Case-Bottom.step, Dachshund70-Case-Panel.step, Dachshund70-Case-Top.step, Dachshund70-Dongle.step, Dachshund70-Encoder.step]
2026-11-03 Case rev 2: Fusion model, STEP, DXF and render exports, build scripts; remove the CadQuery case
    The case is now the Fusion model "Dachshund70 case rev2" (v31), 4 degrees, with an accent ring,
    stepped floor, flat battery bay, brass weight (R4 face, R5 flange, four M3 screws spread to
    x +/-103.5, y 2.5 and 22.5), knob, encoder cover, switch cap and LED light guide.
    - hardware/case/fusion/: Dachshund70-Case-rev2.f3d and the Python scripts that build and export it
    - hardware/case/step/: eight part STEP files, the assembly, and both keycap sets, all at assembly position
    - hardware/case/dxf/: the ring for the laser and the weight engraving (dog and text)
    - hardware/case/renders/: five new views;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
    [Dachshund70-Case-Assembly.step, Dachshund70-Case-Bottom.step, Dachshund70-Case-Encoder-Cover.step, Dachshund70-Case-Knob.step, Dachshund70-Case-LED-Guide.step, Dachshund70-Case-Panel.step, Dachshund70-Case-Ring.dxf, Dachshund70-Case-Ring.step]
2026-11-04 Mainboard logo: "Dachshund70 Rev 1.1" in Fredoka SemiBold
    Tiam asked for the slideshow's font (Fredoka) on the PCB logo. The name
    line's polygons are regenerated from Fredoka SemiBold at the old cap
    height, on the "Doghouse Boards" baseline, and the logo is re-centred
    inside its old area.
    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
    [Dachshund70.kicad_pcb]
2026-11-04 Case: weight text in Fredoka SemiBold (Fusion v33); re-export weight, engraving DXF, assembly and f3d
    The "Dachshund70" engraving on the weight is now Fredoka SemiBold (SIL OFL), the font of the
    project's slideshow and PCB logo, at the same size and centre. Re-exported from v33: the weight
    STEP, the engraving DXF, the assembly STEP, the f3d and the weight close-up render. build_case2.py,
    BOM.md, README.md, PROGRESS.md updated; the font task is removed from SCHEDULED_TASKS.md.
    [Dachshund70-Case-Assembly.step, Dachshund70-Case-Weight.step, Dachshund70-Case-rev2.f3d, Dachshund70-Weight-Engraving.dxf]
